ElMagoCT/brophy-tshirt-cannon/docs/concepts/renders/09-ramp.jpg

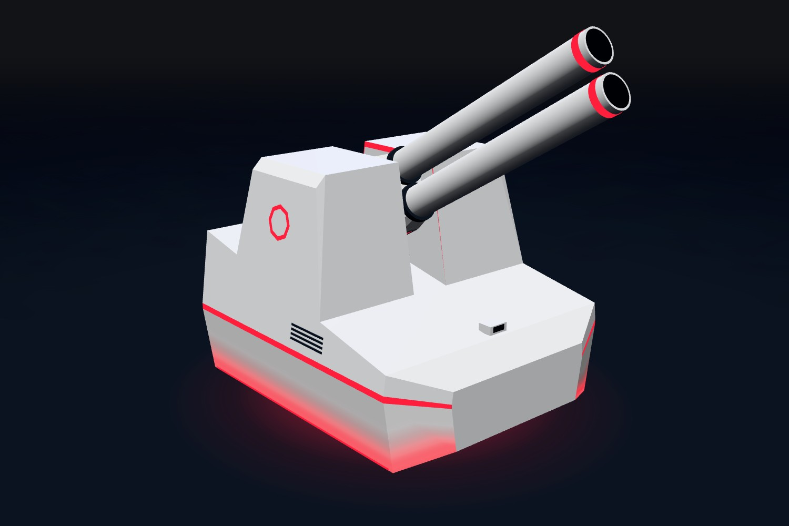
docs/concepts/renders/09-ramp.jpg
