ElMagoCT/brophy-tshirt-cannon/docs/concepts/renders/02-monolith.jpg

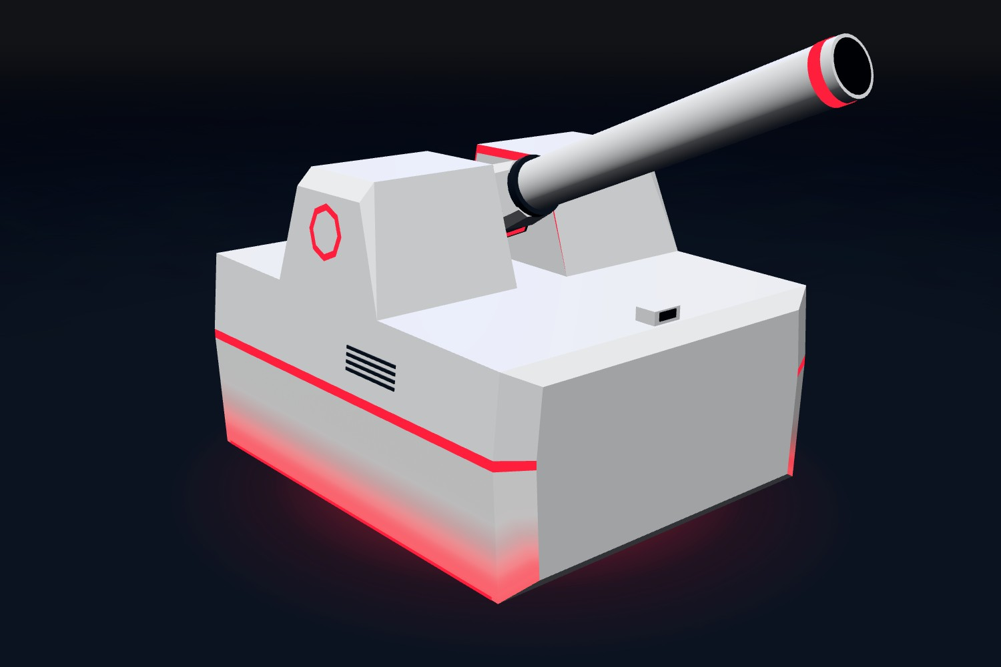
docs/concepts/renders/02-monolith.jpg
