ElMagoCT/brophy-tshirt-cannon/dashboard/README.md

# dashboard/

Web UI served by the ESP32 from flash. Plain HTML/CSS/JS, no build step, talks to
the robot over a WebSocket. Remappable keyboard / HID / gamepad bindings, per-tank
pressure, battery, fire buttons, arm switch, robot rendering, video feed.

Not started.
