ElMagoCT/brophy-tshirt-cannon/docs/glacis/waterjet/README.md

# Waterjet parts (frame plates, 40x40 T-slot frame)

Every flat plate on the 40x40 T-slot frame (branch extrusion-4040), in millimetres, from `cad/glacis/brackets.py` (the CAD's own numbers, regenerated by every `robot.py` run). Nothing is bent. Each DXF is one part (layer CUT: outline, pockets and holes); `nest_*` are the parts laid out on 12 x 12 in sheets (layer SHEET is the sheet edge).

- Holes of 5.5 mm are for M5 screws into drop-in / roll-in T-nuts in the extrusion's 6 mm slots: no holes in the extrusion for them, so the plates go on anywhere along a slot. The shop list for the extrusion itself (lengths, end taps, 10 mm access holes) is `docs/glacis/cut_list_4040.csv`.
- Parts marked CSK take M5 countersunk screws: countersink those holes 90 deg to 10.4 mm on the outer face after cutting (the bearing plates sit right beside the wheels; the bottom corner plates and the bellypan face the underglow and the floor). The rest take M5 x 10 button heads.
- The bearing plates (3 per wheel: the inner one on the side plate, two stacked on the outer rail) take the flanged 1/2 hex bearing as a press fit (28.68 mm): ream to fit the bearing in hand.
- 1/8 in = 3.175 mm, 6061 or 5052.

| Part | Qty | Thickness | Size (mm) | M5 screws each | File |
|---|---|---|---|---|---|
| Bearing plate | 12 | 1/8 in | 112 x 38 | 4 CSK | `bearing_plate.dxf` |
| Bellypan (CNC router) | 1 | 1/8 in | 768 x 259 | 27 CSK | `bellypan.dxf` |
| Corner plate bottom | 4 | 1/8 in | 70 x 224 | 8 CSK | `corner_plate_bottom.dxf` |
| Corner plate top | 4 | 1/8 in | 70 x 224 | 6 | `corner_plate_top.dxf` |
| Rail spacer strip | 2 | 1/8 in | 171 x 20 | 0 | `rail_spacer_strip.dxf` |
| Side plate front | 2 | 1/8 in | 254 x 140 | 6 | `side_plate_front.dxf` |
| Side plate rear (CNC router) | 2 | 1/8 in | 380 x 140 | 12 | `side_plate_rear.dxf` |
| Tower plate | 2 | 1/8 in | 293 x 128 | 2 | `tower_plate.dxf` |

## Nest

- 1/8 in: 5 sheet(s) of 12 x 12 in, 46% of the metal used (`nest_1-8_sheet1.dxf`, `nest_1-8_sheet2.dxf`, `nest_1-8_sheet3.dxf`, `nest_1-8_sheet4.dxf`, `nest_1-8_sheet5.dxf`)

Not in this nest (CNC router, bigger than the 12 x 12 bed): the bellypan, one piece with every electronics part's footprint engraved on layer MARK (0.3 mm deep: drill each part's holes to the part), and the two gun cradle plates (`docs/glacis/gun_plates/`). Also not here: the fog heater bracket.
