ElMagoCT/brophy-tshirt-cannon/docs/glacis/acrylic_cuts/README.md

# Acrylic cut plan (Brophy Borealis, 2026-11-10)

Two Lesnlok 24 x 48 in sheets, 1/8 in (B0H68ZJZW8). The laser bed is 18 x 36 in, so saw each sheet across into the
strips below (the red dashed lines in `acrylic_cut_plan.svg`, measured from one 24 in end), then lay each strip on the
bed with its 24 in side along the bed's 36 in and cut its DXF (millimetres, origin at the strip's corner, panels
centred on the strip: a strip is 609.6 mm wide).

- Sheet 1 strip 1: 24 x 16.42 in -> rear (22.75 x 15.98)
- Sheet 1 strip 2: 24 x 15.00 in -> front (U round the light bar hole) (22.79 x 14.55)
- Sheet 1 strip 3: 24 x 16.33 in -> front side L (18.33 x 15.89)
- Sheet 2 strip 1: 24 x 16.89 in -> front side R (18.33 x 15.89)
- Sheet 2 strip 2: 24 x 15.43 in -> battery door (15.89 x 10.72), deck strip (18.59 x 3.46)
- Sheet 2 strip 3: 24 x 15.43 in -> battery door (15.89 x 10.72), deck strip (18.59 x 3.46)

The outlines are the acrylic as modelled: 1 mm under the frame's rebate all round, every hole included.
Cut them after a dry assembly of the printed frame, as the parts list says.
