ElMagoCT/brophy-tshirt-cannon/docs/glacis/JUDGMENTS.md

# Glacis rev D.1: judgment calls

Rev C (2026-11-02), C.1 and C.2 (2026-11-03) are the redesign from your third to fifth rounds of notes:
- both chambers on the back of their cannons, in line, with the barrels as close together as they go
  (8 mm apart, rev C.2);
- the gun balanced on a pivot axis that runs between the two cannons;
- the old cannon's firing valve, plus a U.S. Solid one (your savings pick);
- small, cheap 2 in pipe chambers (0.53 L), sized by a shot simulation;
- the back tank moved to the right, and no room left for a pump;
- a 60 deg front, with the sides and back leaning more, and the open middle kept;
- the rear-panel controls at the bottom of the panel, and the electronics in the back bottom;
- a 60 rpm pivot motor;
- a custom 12 V fogger: smoke into both barrels ahead of the shirt, plus trail vents front and back;
- no check valves or fill block: a main valve, then one in valve per chamber, each metering its own chamber;
- an LED loop on a leaning rail 1.15 in behind each panel, aimed across it, and a 100/m strip pushed
  through a tunnel in every frame member, so the frame glows; corner clips chamfered and twice the size;
- two slim 100 W siren speakers high in the front-side corners (horn replacement), with their amp;
- the vector-style wheels from your TTB file.

Each item says what I picked and why. Numbers come from `cad/glacis/params.py` and the last clean run
(`cad/glacis/out/check_log.txt`).

**Checks on the final model:**
- no part overlaps another;
- nothing hits anything as the gun sweeps 0-90 deg, checked every 5 deg;
- every printed part fits a 256 mm bed;
- every part is a single solid.

**Where it is:** Onshape "Brophy Mark 5 - Glacis", saved as version "Glacis rev C.2"; the assembly is
"Glacis rev C (whole robot)". The parts list is the "Glacis BOM" tab: **$1,512.44** to buy (rev C.1 was
$1,707.39, rev B $1,555.11). Aluminum, acrylic, prints, Falcons, FRC stash parts and the old cannon's valve are all at $0.
The pneumatic and electrical diagrams are in the "Glacis air & wiring" artifact
(source `docs/glacis/air_wiring_artifact.html`).

## What I identified on the old cannon
1. **Firing valve: Atlantic Valves SZW-25.** The plate says SZW-25, not S2W.
   - It's a 1 in NPT stainless solenoid valve, normally closed, with a Viton seal.
   - It's semi-direct acting, with a 25 mm orifice and Cv 12. The 12 V DC coil is 16 W.
   - Rated **0-115 psi on the 12 V DC coil** (0-145 on the AC coils).
   - It's sold at electricsolenoidvalves.com, not Amazon: SZW-25-12VDC, **$127.56**, 29 in stock
     ([page](https://www.electricsolenoidvalves.com/1-inch-12-volt-dc-stainless-steel-electric-solenoid-valve/),
     [spec sheet](https://www.electricsolenoidvalves.com/content/Atlantic_Valves_SZW_Spec_Sheet.pdf)).
   - The old one is reused on the top cannon.
   - **The bottom cannon gets a U.S. Solid USS2-01023**, $59.80
     ([B0CXWR76GT](https://www.amazon.com/dp/B0CXWR76GT)): the same 1 in NPT 12 V DC size, rated 0.8 MPa
     (116 psi), which you read off the listing. That's just above the 110 psi cap, and $68 less.
   - **Check the old valve's coil label.** It has to be the 12 V DC one.
2. **Old chamber: a grey primed-steel ASME air tank with a 1 in NPT end port**, probably 1 gal. It's no
   longer used; see item 6 for the new chambers.
   - Its buyable twin was McMaster 9888K9 at $397.34
     ([link](https://www.mcmaster.com/9888K9/)), which is what pushed me to look for something better.
3. **Longacre 5 gal polished aluminum tank:** rated 125 psi
   ([52-50305](https://toolsid.com/longacre/5-gal-horizontal-silver-lightweight-air-tank-mpn-52-50305.html)).
   It can't go on the 200 psi tank side, so it's a spare.
4. **The screw-set regulator is gone.** Each chamber's in valve meters air into it against that
   chamber's transducer, so each cannon's pressure is set in software.
5. **Red "5 in ONE Universal" couplers:** brand and rating not confirmed, so they stay off the pressure
   side.

## Gun
6. **Chamber size, from a shot simulation.** I modelled a shot: the chamber, the valve opening over its
   real time (Cv 12), the air behind the shirt and the shirt itself (250 g with friction). Then I ran it
   against chamber size at 110 psi
   (`cad/glacis/shot_model.py`; numbers below are for a 50 ms valve opening):

   | Chamber | Exit speed | Shots per charge |
   |---|---|---|
   | **0.53 L (2 in x 8 in, picked)** | **22.7 m/s** | **about 20** |
   | 0.64 L (2 in x 10 in) | 24.0 m/s | about 17 |
   | 0.75 L (2 in x 12 in) | 24.9 m/s | about 15 |
   | 1.25 L | 27.0 m/s | about 9 |
   | 3.8 L (1 gal) | 29.0 m/s | about 4 |

   - With this slow a valve, the valve sets the shot, not the chamber. The 1 gal tank gives 28% more speed
     than 0.53 L, and you get a fifth of the shots.
   - The 10 in and 12 in nipples were modelled too. They swing the chambers low enough at the back to
     open the rear face down through the fill port, tank relief and charge port. The 8 in keeps the
     rear controls where you asked for them.
   - If the valve opened in 10 ms like a QEV, the same chamber would give about 38 m/s. That's the case
     for adding a QE5 later (item 9).
7. **Chamber: 2 in Sch 40 x 8 in steel nipple between two 2 x 1 malleable reducing couplings, about
   0.53 L.**
   - About $41 per chamber in pipe ($15 nipple and two $13 couplings), against $397 for the McMaster
     twin of the old tank.
   - The couplings are UL/FM listed, 150 lb class and factory pressure tested; the pipe is rated well over
     1,000 psi. Everything sits behind the 125 psi relief.
   - At 3 in across the couplings, the chambers are no wider than the barrels, which is what lets the
     barrels sit close.
8. **Two cannons stacked 8 mm apart** (84.2 mm between axes; rev C.1 had 3.8, you asked for 8).
   - Each one, back to front:
     1. port block;
     2. 1 x 1/4 bushing;
     3. reducing coupling;
     4. 2 in nipple;
     5. reducing coupling;
     6. 1 in close nipple;
     7. SZW-25;
     8. 1 in close nipple;
     9. CNC breech adapter;
     10. polycarbonate barrel.
   - The breech adapter is stash 6061 with a 1 in NPT tap ($16.99 on the list). The barrel slips over its
     spigot, so it's no wider than the barrel.
   - One printed breech block in two halves clamps both barrels onto their spigots. The muzzle collar is
     two halves meeting between the barrels.
   - **Balanced on the pivot.** The model finds the gun's centre of mass and slides both cannons along the
     barrel axis until it lands on the pivot axis. Valves end up 71 mm ahead of the axis, centre of mass
     within 0.3 mm, gun 11.4 kg: **0 N*m to hold at any angle.**
   - The valve (1.0 kg) and coupling (0.31 kg) masses are estimates; the pipe is computed. Weigh yours,
     update `gun.py`, and re-run before cutting the cradle plates.
9. **Pressures and the valve trade-off.**
   - 110 psi software cap on the chambers, just under the valve's 115 psi DC rating. Above that, the coil
     may not lift the valve; it fails closed, not open.
   - **Milton 1090-125** ASME reliefs ($16.87) go on each chamber. Their pull ring is the manual bleed.
     125 psi is above the cap, so they never simmer, and under the tanks' and transducers' 200. This replaces the settled "150 psi chambers" for this valve.
   - CLAUDE.md lists "big direct-acting solenoid as the firing valve: too slow vs a piloted QEV" as a dead
     end. The SZW-25 is semi-direct, so it's slower. It's in because you asked for the old valves and it
     worked on the old cannon.
   - The simulation says a QE5 QEV ($51.75) between the chamber and the barrel, with the SZW-25 as its
     pilot, would be the biggest single gain if you want more range later.
10. **Air budget:** each 0.53 L refill takes about 5 psi out of the two 6 L tanks, so a 200 psi charge
    gives **about 20 full-power shots** (2 loaded plus about 18 refills). Lower settings give more.
11. **Chamber fittings: a 1/4 NPT brass cross on the back of each chamber**, so nothing is drilled. Its
    four ports are exactly what's needed, so the 5-port block and its plug are gone (-$23, lighter gun):
    - in from the chamber's bushing;
    - fill push-to-connect straight out the back;
    - 125 psi relief pointing outward;
    - 0-200 psi transducer to the side.
12. **No check valves: a main valve, then one in valve per chamber** (your call, rev C.2).
    - The checks were only there because one fill valve fed both chambers through a shared block, so
      firing one would have drained the other back through it. With a valve per chamber, a closed in
      valve seals its chamber, so the checks and the fill block (with its sensor and relief) are gone.
    - **Main valve** (kept, as you asked): the tanks' shut-off. It opens only while a chamber fills, and
      it's on the safety-powered valve rail, so a trip closes it. *Rev C.3: now a manual ball valve (E2).*
    - **In valves A and B:** each pulses until its chamber's sensor reads that cannon's own setpoint
      (110 psi max). All three are the same Aignep 02F direct-acting 12 V valve ($41.36, 507 psi rated).
      Direct-acting means they open from 0 psi and don't need a pressure difference to work.
    - **Fill order:** open the main valve, meter the in valve, close the in valve, then the main valve.
      That leaves tank pressure on the in valves' inlet side, which pushes their seats shut. A solenoid
      valve isn't rated to hold pressure backwards, so the firmware never vents that line.
    - **No bleed valve.** The manual tank bleed is gone. To dump by hand, pull the relief rings:
      - the tank relief, which now points out through the rear panel where the bleed lever was;
      - the 200 psi relief on the valve cross;
      - the 125 psi relief on each chamber.
      With power, the firmware can empty the chambers by firing them.
    - **One relief I kept that you circled:** the brass between the main valve and the in valves holds
      tank pressure when both are shut, so it's its own pressure zone. The project rule is a hardware
      relief on every zone, so the cross carries a 200 psi relief ($16.30) instead of the fill block's
      125.
    - Air side: -$15.60 (checks, fill block, fill sensor, 125 relief and ball valve out; two in valves
      and a 200 relief in). Two more MOSFET channels, from the spares.
    - Two nylon service loops run from the in valves up to the gun and flex as it elevates. The sweep
      check skips them; give them slack when you route them.
13. **Firing valves switch on MOSFET modules, not relays,** to take the relay's ms off the shot. Add a
    flyback diode on each coil.
14. **Cradle:**
    - two 1/8 aluminum plates either side of the stack;
    - printed chamber saddles (one block between both pipes at each station), each pipe's outer half
      held by a printed cap with two M5 screws into the saddle (they replace the cam straps);
    - valve side blocks and the two-piece breech block;
    - a printed mantlet carrying the smoke vents beside the barrels and an LED groove;
    - a two-piece LED-groove muzzle collar.

## Elevation
15. **The 60 rpm motor is the goBILDA 5203 99.5:1.** It drives a 16T -> 56T HTD 9 mm belt (100T) to
    the right pivot stub.
    - That's about 17 rpm at the gun, so 0-90 deg takes about 0.9 s at full speed.
    - The gun is balanced, so the motor only fights friction and inertia. It has 46 N*m stall at the
      pivot.
16. **Two 1/2 hex steel stubs carry the pivot**, one per cradle plate, each through a printed hub
    bolted to the plate's outside face. The pivot axis still runs between the two cannons.
    - With the barrels 8 mm apart, there's no room for a shaft between the chambers' couplings.
    - The stubs sit in four flanged hex bearings, in two PA-CF blocks on 1x1 towers on the inner rails.
    - The pulley is on the right stub; the arm-angle pot is on the left stub through a printed coupler.
    - The two plates are tied together by the saddles, valve blocks, breech block and mantlet.
17. **The gun well follows the gun.** The model sweeps the gun 0-90 deg and cuts the well floor to that
    envelope plus 10 mm, so the body stays as closed as it can.
    - The floor is 437 mm high at the front, 388 at the back and 232 under the axle.
    - The well is 224 mm wide; the elevation pulley turns inside it.

## Body
18. **Front slant 60 deg** (was 70), the back leans 80 deg, and the sides lean in 8 deg (was 6). The deck
    is flat at 24.8 in.
19. **Size:**
    - 37.7 x 27.7 in over the bumpers.
    - With the gun level, the muzzles reach 44.9 in overall and the chambers stand 31.2 in tall.
    - At 90 deg it is 37.8 L x 50.1 H.
    - To get through a 40 in door, drive with the gun raised.
20. **9 panels.** Both side walls split at the battery bay; their rear panels are the battery doors.
21. **Each panel has its own LED loop, 1.15 in behind it, aimed across it** (rev C.2, your second note).
    - A printed rail hangs inside every window from a flange on the frame's inner face, leaning 15 deg
      toward the panel. A 10 mm 60/m strip sticks to its panel side, centred 35 mm behind the outer face
      (1.15 in behind the acrylic). The LEDs shine across the back of the panel and slightly at it.
    - The rail runs all the way round each window, so every panel is one closed loop and can be its own
      colour. The rail's back shades the next panel, so the light doesn't leak across.
    - **How far in:**
      - **42 mm from an edge shared with another panel.** Every corner on this body is 91-100 deg, and at
        any less the two panels' strips cross along the whole edge.
      - **29 mm from an open edge** (the bottom, the gun slot, the speaker notches), so the bottom runs
        sit low.
      - The rail corners round off at up to 45 mm.
    - **The bottom runs fit.** I moved parts out of the loops' way:
      - the batteries 15 mm inboard, and their SB50 plugs with them;
      - the side tanks 6 mm inboard and 20 mm back;
      - the elevation motor 22 mm lower, round its belt circle (same belt);
      - the pot bracket's top 20 mm lower;
      - the rear smoke tube up 15 mm, and the smoke box 10 mm back;
      - the rear manifold 5 mm lower, with its tank transducer pointing down from its underside.
      The rear panel's bottom run passes under the E-stop, charge port and smoke nozzle.
    - 12.1 m of strip, so three 5 m rolls (BTF-LIGHTING, Amazon, $13.99).
22. **The frame glows too: a strip tunnel through every member.**
    - A 6 x 2.6 mm rectangular tunnel runs down the middle of each member, so a 5 mm strip can't twist
      and its LEDs face out. That's 100 LED/m (5 mm, 2020 LEDs, AliExpress, $15.79 per 5 m). Print the
      frame in natural or white PETG.
    - It's centred across the member and stacked over the joint line: the tenons moved deeper (18.5 mm,
      was 15), and the tunnel sits 2.5 mm outward of them, so the M4 cross screws stop 2.75 mm short of it.
    - On the bottom edges, where the face meets the open bottom at a sharp angle (60 deg at the nose),
      the tenon and tunnel move in from the edge until they keep 2 mm of wall.
    - **Feed slots:** at each end of each member, a slot opens from the inside down to the tunnel. Push
      the strip in from one slot to the next; at the nodes, solder or plug the next member's strip in the
      slot. The slots stay 9.5 mm under every outer face and out of every joint.
    - 9.5 m in the tunnels. With the loops that's about 1,680 LEDs, so cap them at about 20% white on
      the 20 A buck.
    - Print the frame in natural PETG at 15% gyroid with 4 walls (your savings pick): lighter, and the
      glow comes out more even than at 25%.
    - **Frame:** 89 printed pieces, 101 tapered tenons with M4 cross screws, 40 corner clips and 2
      door latches. Short edges round the speaker notches set back less so they still get a
      segment, and the few nodes that still came out bigger than the bed are halved and glued.
    - Strips, rails and loops are in the model (red), so they show in Onshape.
23. **Corner clips: chamfered, twice the size.** Each is a corner plate with a straight chamfer across
    the panel corner instead of a round edge, legs 27 mm along the frame (rev C.1's discs reached about
    14). One M3 into a heat-set insert, 8 mm in from both edges.

## Speakers (rev C.2)
24. **Two slim 100 W siren speakers, one high in each front-side corner.** Your old list had a 20-30 W PA
    horn; that's quieter than a car horn at a parade. Siren speakers are built to replace a horn.
    - **UBL 100W Slim:** 11 ohm, 120-130 dB at 100 W, 400-4,000 Hz, 5.5 x 5.75 x 2 in, $79.99. Being 2 in
      deep is what lets them sit in the corners; the 5-6 in PA horns are 6-8 in deep.
    - Horn tones and voice sound right; music has no bass at 400 Hz up.
25. **Aim, as you asked for the top ones:** 45 deg out from straight and 30 deg up. Each sits 90 mm down the
    front-side corner from the top and seats 55 mm in from the corner edge.
    - **I didn't fit the bottom pair** (22.5 out, 15 up). The lower corner has the front wheel under it
      and the side tank behind it, and a 6 in speaker per notch leaves too little panel between two
      notches. Everywhere I tried, one of these broke:
      - the side panels pinched into two pieces;
      - the cups hit the front wheels;
      - the grilles pushed the robot to 28.8 in wide, past your 28 in door.
    - Two at about 26 W each is roughly car-horn loud at 1 m. If you want the bottom pair, a speaker
      about 4 in across would fit. Your call.
26. **Integration:** each speaker sits in a square notch cut into the corner. The body shape itself is
    notched, so the front and side panels, the frame, the LED rails and the loops all follow the notch.
    - A printed cup lines the notch and carries the speaker on 4 x M4 through its floor; a wire hole goes
      through the floor.
    - A printed grille covers the speaker face: 3 walls, no top or bottom layers, 12% gyroid, so it prints
      as an open mesh. Glue it or screw it to the cup.
    - The grille's top corner stands 4 mm above the deck.
27. **Driver:** the ESP32-S3 WiFi bridge streams sound from the web UI over I2S to a PCM5102A DAC. One
    TPA3116D2 board ($13.98) drives both speakers, one channel each.
    - It runs from a 12 -> 24 V 10 A boost converter ($39.99) on a PDH channel. On 24 V it puts about
      26 W into 11 ohm; on 12 V it's about 6 W, 6 dB quieter. Skip the boost if that's loud enough.
    - The amp and the boost sit on the middle of the bellypan, under the gun's swing.
    - Audio adds $199: two speakers $160, amp $14, boost $18, DAC $7.

## Layout
28. **The back tank moved to the right.** I read that as mirroring the left one, so both tanks lie along
    the sides over the front wheels, on cantilevered 1x1 arms with printed saddles and straps. No pump
    spot.
29. **Bottom of the rear panel:**
    - E-stop;
    - fill port (air in; rev C.3: an M-style plug with a check valve behind it, P3);
    - the tank relief's pull ring (the hand dump; there's no bleed valve);
    - SB50 charge port, to run or charge on standby power with the batteries in;
    - USB-C to the STM32.
30. **Rear manifold** (back bottom, left): tank lines, 0-300 psi transducer (pointing down underneath),
    and the line to the main valve. The fill port and the 200 psi relief go straight out through the rear panel.
31. **Electronics in the back bottom bay:**
    - PDH and main breaker on the bellypan;
    - STM32, both ESP32-S3s, the PWM gate, the drivers, the buck and the Spark MAX on a printed shelf;
    - the main valve, valve cross and in valves beside them (coils up).
    - Rev C.3 adds the PDH contactor and the logic supply here (E1); the main valve's handle has to reach
      the rear panel (E2).
32. **Batteries:** two spots, one per side, each on its own sled over a rear wheel, so you can swap one
    while the other runs. Each slides out through its side's rear panel.
    - **The battery doors latch at the top** (your call). Each door keeps its two bottom corner clips,
      which act as hooks, and gets a printed quarter-turn latch on an M4 screw at the middle of its top
      edge. Turn the latch, tip the door out from the top, and lift it off the hooks.

## Smoke
33. **Custom 12 V fogger with one 200 W fog heater core, and room for a second** (your savings pick), instead
    of the EVAP smoker. The tray, the heater bracket, two MOSFET channels and a PDH channel are left free,
    so the second core and its pump drop in later for twice the fog. About $55 of parts plus fluid.
    - **Why not the EVAP smoker:** it burns about 0.3 mL of oil a minute; a 400 W fogger moves 13-16 mL.
      That class can't make outdoor trails or fill two barrels.
    - **Why not a mains fogger:** a $30 400 W fogger plus a 500 W inverter draws about 40 A, puts mains
      wiring on the robot, and the inverter doesn't fit the bay
      ([BORGOVA](https://www.amazon.com/dp/B0F4XJMNFR) + [BESTEK](https://www.amazon.com/dp/B086SSRRZ7)).
    - **The core:** a cast fog-machine heat exchanger made for 12 V
      ([AliExpress, $22.42](https://www.aliexpress.us/item/3256805556610953.html)), 97 x 32 x 36 mm,
      about 17.5 A on its own 30 A PDH channel. One makes about as much fog as a 200 W mains fogger; two
      would match a 400 W one.
    - **Parts:**
      - a Kamoer 12 V peristaltic pump per core, fed from a printed 400 mL tank;
      - a MAX6675 thermocouple amp and K probe per core, read by the STM32;
      - a KSD301 250 C cutout and a 40 A relay per core;
      - a 5015 blower to push the fog into the splitter.
    - **Warm-up is 5-8 minutes** (heat on standby power before an event). Then about 40 s of continuous
      fog before a reheat.
    - The ready-made 12 V 200 W fogger on AliExpress ($58.49) uses the same class of heater, but it has one
      1-star review and no size listed.
34. **Control and safety.**
    - The STM32 holds each core at 220-240 C, with a firmware cut at 245 C. It switches the heaters
      slowly (about 1 Hz) on paired MOSFET channels, gated at 5 V through the spare 74AHCT125 buffers.
    - The pump and the blower are on their own MOSFET channels. With the firing and in valves that's
      8 channels of two 6-packs, which leaves 2 for a second core.
    - Each core's 40 A relay sits upstream of its MOSFETs. Its coil runs through the KSD301 and an STM32
      enable pin that's pulled low, so an overheated core, a shorted MOSFET or an STM32 reset all drop it.
      The KSD301 resets itself when it cools, so the firmware latches the fault.
    - Pump only within 10 C of the setpoint, with a pump timeout, and cut the heater if a thermocouple
      reads open.
    - The cores sit on an aluminum bracket with ceramic-fiber wrap, never on a print.
35. **Fluid:** water-based glycol fog fluid only. Oil (the EVAP fluid) cokes the core's 2.5 mm tube. Like
    any fogger, it can trip gym smoke detectors, so check with each venue.
36. **Ducts:** a printed outlet adapter feeds a printed 1-to-4 splitter, then your four flexible tubes.
    - **Two go to the barrels.** Each barrel has six 5 mm holes 205 mm from its breech end, just past a
      rolled shirt. A printed two-piece smoke collar clamps round both barrels over the holes. Its two
      ring grooves meet between the barrels, so one plenum feeds both.
      - Smoke fills each barrel ahead of the shirt and spills out of the muzzle. On a shot, the shirt
        pushes it out in front.
      - The holes sit ahead of the shirt, so they don't leak the shot until the shirt has passed.
      - Drill the polycarbonate slowly with a sharp bit and deburr; the clamps still never drill it.
      - These two tubes flex with elevation, like the air loops.
    - **One goes to a vent under the front bumper** (through the bellypan, front left).
    - **One goes to a nozzle low in the rear panel**, centred under the open middle. It runs along the
      bellypan, under the gun's swing and over the electronics shelf. That's the back trail.
    - Keep the ducts short and sloped so condensed fluid drains back. Check the core's tab layout and outlet
      tube when they arrive, before printing the tray and splitter.

## Wheels (from your vector-wheel file, TTB-0010)
37. **Same style as your TTB wheel, scaled to 10 in.**
    - 10 rollers, 42 mm across and 104 mm long (rev B had 14 at 30 mm).
    - A lobed hub rim with a printed cup round each roller end, like the TTB's hooked lugs.
    - One change: the rollers keep a true mecanum barrel profile instead of the TTB's straight
      cylinders. At 10 in, a straight roller rides on its corners and the wheel bumps.
    - Coverage +6%, with 5 mm between neighbouring rollers.
38. **Rollers on 608 2RS and a fixed M8 rod.**
    - PETG-CF core, 3 mm TPU 95A tread (1.8 mm at the ends), a 608 pressed 8 mm into each end.
    - The rod doesn't turn; the bearings do. It threads through a captured M8 nyloc in the outboard
      cup (Loctite 243) and bottoms in a blind hole in the inboard cup. The outboard plate covers the
      nut channels, so a rod can't back out.
    - Each cup's stub sits in the roller's end recess and presses only on the bearing's inner race.
    - Nuts, not tapped aluminum: the rods sit at 45 deg to the plates, so a flat plate can't be
      tapped square to them.
    - To change a roller: take off the outboard plate (8 nuts), unscrew the rod by a slot cut in its
      end, and the roller drops out.
39. **Hub: two halves, as big as the bed allows.**
    - Split at the roller centre plane. Each half is 242 mm across and prints face down.
    - The bed would take 250 mm, but the rim stops 6 mm inside the tread so it never touches the floor.
    - Each half is a lobed face web, a drum ring, 6 spokes and a 1/2 hex boss.
40. **Aluminum: 12 flat 1/8 in plates (waterjet), three per wheel.**
    - The inboard plate is the belt's inner flange.
    - A centre disc sits between the two halves.
    - The outboard plate is lobed, the same shape as the rim.
    - 8 x 1/4-20 x 5-1/2 in bolts clamp the stack (M6 x 130 fits the same holes). The plates' hex holes
      put the wheel load on the axle through aluminum, not plastic.
    - Each plate also has 12 lightening holes: the hub's 6, plus 6 x 16 mm between the bolts (your
      savings pick). None at 0 and 180 deg, where they'd meet the hub's holes; >= 7.7 mm of web everywhere.
41. **Pulley: 116T HTD 5M, 15 mm, printed into the inboard half.**
    - Its flange is 1.27 in off the floor. 118T would be 1.20 in.
    - 9.67:1 from the Falcon's 12T (was 10:1); free speed 28.8 ft/s.
    - The stock 140T belt still fits; the Falcons now sit 169 mm from the axle.
42. **Load.** Two 608s per roller rate 2.7 kN static. At 69 kg, a wheel carries about 170 N standing
    and about 500 N on a 3 g bump, often all on one roller: over 5x margin. The printed cups are the
    weakest link, and the plates and bolts carry their load to the axle.
43. **The cost of the width.**
    - Each wheel is 120 mm wide (rev B 94). The outer rails stay put (27.7 in over the bumpers), so
      the inner rails and Falcons moved 26.5 mm inboard: the inner rails are now 104-129 mm off centre.
    - The electronics shelf narrowed to +/-100 mm, with the boards rearranged on it.
    - The valve cross moved 25 mm inboard, clear of the rear-left wheel.
    - The tank lines now run inboard of the rail posts.
    - The pivot bearing blocks follow the rails and are now 20 mm wide (was 47); both flanged hex
      bearings still fit, and the pivot stubs are shorter to match.
44. **Weight: 3.3 kg a wheel** (rev B 2.4), so +3.6 kg for four.
45. **Cost: +$60.85.** The 608s, rod, nylocs, bolts and Loctite replace the 685ZZ and M5 lines. The
    Bolt Depot prices are from search snippets, so check stock when you order.

## Things I'd flag
46. **Cost: $1,512.44**, well inside the $2,000 ceiling.
    - By section: pressure side $425, gun $357, audio $199, drive $157, frame and body $131, controls
      $103, smoke $91, bumpers $30, elevation $19.
    - Your savings picks took off $439 (it was $1,951.55). What I didn't change, and why:
      - **#12, 1/4 NPT transducers:** FUSCH's 200 psi transducer only comes in 1/8 NPT, so the bushings
        stay.
      - **#13, HornBlasters VA-4:** it's $41.95 in stock, the same as the Aignep, and nothing says it's
        direct-acting. So the Aignep stays.
      - **The VA-4 as a firing valve:** it can't do the job. It's a 2.5 mm orifice (Cv about 0.15) against
        the 1 in valve's Cv 12, so a shot would barely leave the barrel.
      - **#10, the pipe tap:** it cuts the 1 in NPT threads inside the two aluminum breech adapters. It
        stays on the list; borrow one if the shop has it.
    - The speakers are now the biggest line (2 x $79.99).
47. **Weight is about 157 lb** (71.0 kg). The two siren speakers add about 4.8 kg (2.4 kg each, a guess from
    similar 100 W units); the gun is 11.5 kg.
48. **Check before ordering:**
    - the old valve's coil voltage (it must be the 12 V DC coil);
    - the U.S. Solid valve's coil voltage (12 V DC);
    - the Aignep coil and plug (you need 3 valves);
    - the AliExpress strip's sale price ($15.79 a roll);
    - the speakers' weight and mounting holes, and that the 4 x M4 pattern in the cups matches;
    - the fog cores' tabs and outlet tube when they arrive;
    - the AliExpress, Zoro and dollar-store prices (search snippets only).
49. **Found while checking: the battery doors are too narrow for the battery.** This goes back to rev C.
    The back leans 80 deg, so at the top of the battery the door window is about 163 mm wide, but the
    battery is 181 mm long; the LED rails take it to about 149. It slides out only if you tilt it. Fixes:
    move the door split forward about 40 mm, which runs the split's LED rail into the side tank, or lay
    the battery on its side. Your call; the new top latch doesn't change it.
50. **The Onshape model is imported STEP** (dumb solids), with the gun posed at 20 deg. To change it,
    edit `cad/glacis`, run `python robot.py`, and replace the changed tabs.

## Electronics and air review (rev C.3, 2026-11-03)
Your electronics review notes, then your pneumatics notes. Full electrical write-up: `electrical/README.md`.
Range math: `cad/glacis/range_model.py`. The parts list goes up $36.46 for all of this.

**Electronics**

E1. **The STM32 switches the whole PDH, and the logic has its own always-on circuit** (your call).
    - Main breaker -> 200 A contactor -> PDH. Ahead of the contactor, a 5 A fuse feeds a Pololu S13V30F5
      5 V buck-boost ($17.95): the logic rail for the STM32, both ESP32-S3s and every sensor.
    - Standby (contactor open) leaves the PDH dead but the STM32, sensors, web UI and remote alive, so you
      see pressures, fog fluid, temperatures and battery with the systems off. Arm from the UI.
    - Contactor: Hamolar RD-200 2-pack ($26.24, one spare), coil about 0.7 A through a spare MOSFET channel.
      The rear E-stop's second contact is in that coil, so the E-stop now kills the whole PDH in hardware;
      the first contact stays in the safety relay coil.
    - Buck-boost, not a buck: a drive sag can't brown out the controllers.
    - The 20 A buck now feeds only the LEDs, from the PDH. 1,680 WS2812s draw about 1 A even when dark,
      so they belong on the switched side.
E2. **Main valve is manual** (your call). A 1/4 NPT brass ball valve, the old cannon's if it's stamped
    200 psi or more (else a $6.55 Dwyer DBV-00). -$41.36 for the Aignep it replaces.
    - Open all session, closed for transport and gun work. Its handle needs to reach the rear panel:
      that's a CAD move I haven't made (the C.3 CAD session has the model open).
    - The in valves now hold tank pressure all session. They're rated 507 psi and normally closed on the
      valve rail, so a trip still isolates both chambers. A stuck in valve is caught by the chamber's
      125 psi relief, which flows 120 SCFM against a 2 mm orifice.
E3. **Smoke sensing.** The core temperature sensor was already there (MAX6675 + K probe). Added:
    - an XKC-Y25 capacitive level switch on the outside of the printed tank ($21.95; no hole in the tank);
    - a fluid gauge for free: the pump is peristaltic, so pump-seconds = mL used;
    - DS18B20 probes ($9.49 for 5) in the fogger box (heater off at 70 C, before the PETG tray softens),
      on the electronics shelf and in the battery bay. That last pair answers the "cooling system" question
      with data.
E4. **The STM32F411 is right for its job, not for Wi-Fi or video.** It has the ADC channels, timers and
    FPU for everything time-critical, and a drag-model trajectory solve takes it tens of ms. But it has no
    radio and 128 KB RAM, which is why the ESP32-S3 bridge does the web UI. Put the trajectory math in the
    browser: it's where the aim arc is drawn, and it costs the robot nothing.
E5. **Camera: a Pi Zero 2 W + Camera Module 3 Wide, about $50, on the logic rail.** H.264 over WebRTC at
    about 720p30 and 0.2 s lag. An ESP32S3 camera ($14-20) is cheaper but VGA MJPEG. Not on the list yet.
    - If 2.4 GHz turns out jammed at games, the better option is an ESP32-C5 bridge (5 GHz access point,
      $8-14) with a dual-band camera Pi. Test with one of your S3s at a game before buying.
E6. **Fixes from the review:**
    - battery and PDH volts on two ADC pins (the dashboard's battery goal had no sensor);
    - pull-downs so a cut transducer wire reads as a fault, not as an empty chamber to keep filling;
    - the gun-angle pot on 3.3 V, not 5 V (5 V would overdrive the ADC);
    - all three transducers are now the same 0-300 psi part;
    - firmware latches: no restart after an E-stop, a welded-contactor check, low-battery standby, an
      in-valve time limit;
    - LED power injection at every frame node.
E7. **Runtime:** about 25 A on average at an event, so two FRC batteries last roughly an hour. Swap one
    every ~30 minutes at long games. LEDs and fog are the big steady draws.

**Air**

P1. **The tanks aren't what's short. The gun is.** I modelled range with drag (250 g rolled shirt; its
    drag is the big unknown, so three cases):

    | Gun (110 psi max on the SZW-25) | Exit speed | Range | 200 ft at | 75 ft at |
    |---|---|---|---|---|
    | **rev C.2: 0.53 L, 22.5 in barrel** | 22.7 m/s | **108-132 ft** | can't | 77 psi |
    | 2.0 L, 36 in barrel | 35.3 m/s | 175-238 ft | 109 psi | 34 psi |
    | 2.0 L, 48 in barrel | 39.4 m/s | 194-271 ft | 89 psi | 40 psi |
    | 3.8 L (old 1 gal tank), 36 in barrel | 37.5 m/s | 185-256 ft | 93 psi | 22 psi |
    | QE5 QEV (opens in 10 ms), 1.0 L, 30 in | 35.2 m/s | 174-237 ft | 110 psi | 52 psi |

    - 200 ft needs about 35 m/s at the nominal drag (31-41 across the range). 75 ft needs only about 17.
    - So 75 ft x 6 already works. 200 ft doesn't with any pressure these valves allow: the SZW-25's DC
      coil stops at 115 psi, and its 50 ms opening is slower than the shirt's trip down a 22.5 in barrel.
      More pressure isn't available without a QEV.
    - What gets 200 ft back is the old cannon's recipe: about 2 L or more of chamber and a 36-48 in barrel.
P2. **Shot count is fine with the tanks you have.** One 200 ft shot then six 75 ft shots needs 4-6 L of
    tank, from shop air at 150 psi. The two 6 L tanks (12 L) cover it twice over. The rev C.2 gun gets
    15-23 shots at 75 ft per charge. Bigger tanks would only add shots, so I didn't change them.
    - Shot order: take the 200 ft shot first in a charge, while the tanks are highest. The dashboard can
      show when the big shot is still available.
    - Most shop compressors stop at 135-175 psi, not 200. Everything above assumes 150.
P3. **Fill port: your universal coupler.** A 1/4 MNPT M-style plug ($4.29) replaces the Schrader valve, so
    your EVOULTES couplers snap on like they do on your tanks. A plug is an open pipe, so a 250 psi brass
    check valve ($7.05) sits right behind it to hold the tanks. No kit to buy: you already have the
    hose-side coupler. +$2.19 net.
P4. **Fewer sizes.** All the air plumbing is 1/4 NPT with one 1/4 in tube and one push-fit. The only other
    sizes are the firing path (1 in), the chamber body (2 in) and the transducers' 1/8 NPT port. I looked
    for 1/4 NPT transducers to drop the bushings: the cheap ones are G1/4 (BSPP, which won't seal in NPT),
    so the bushings stay. The 0-200 and 0-300 psi transducers are now one part. A bigger gun in the old
    cannon's style (a 1 gal tank with its 1 in end port) would also drop the 2 in pipe and reducing couplings.
P5. **Open: which gun for 200 ft.** Bigger chambers and longer barrels change the gun's size, weight and
    balance, so the CAD has to be redone. I haven't changed the model or the list for it; that waits on your pick.

## Rev D gun and air (proposal, 2026-11-03)
Your picks after the range math: the top cannon on the old chamber, the bottom on a smaller one, both
barrels the same length, and the top able to run at full tank pressure. Targets: 200 ft from the top
cannon; 120 ft shots, 6 per cannon (12) per tank charge, 10 each (20) ideally. Numbers: `cad/glacis/range_model.py`.
Not in the CAD yet (D6).

D1. **Top firing valve: U.S. Solid USS-HSV04, $98.19.** 1 in NPT, 12 V DC, normally closed, pilot-operated,
    rated 1-50 bar (725 psi) on air, Cv 11.67 (the SZW-25 is 12), 25 mm, 16 W, PTFE seal, 3.86 lb.
    - What else I found: every 1 in 12 V valve on Amazon and AliExpress tops out at 0.8-1.0 MPa
      (116-145 psi). One U.S. Solid listing claims 230 psi, but its own spec table says 7 bar. ASCO's 1 in
      high-flow valve is rated 350 psi on air (price not checked; ASCO is usually several hundred). The
      1/2 in train-horn valves are rated high enough (HornBlasters 210 psi, Kleinn VX7004 250 psi), but at
      Cv 5.5 they flow under half as much.
    - Its opening time isn't published, so the model brackets it at 50 and 80 ms. Bench-test it with a
      phone in slow-motion before cutting the barrels.
    - It replaces the U.S. Solid USS2-01023 (116 psi, $59.80). The old SZW-25 moves to the bottom cannon.
D2. **Top chamber: the old 1 gal ASME tank (3.8 L)**, its 1 in end port straight onto the HSV04.
    - Read its nameplate. It needs 200 psi or more to run at full tank pressure; otherwise cap it 10% under
      the plate. Also check which small ports it has (fill, transducer, relief) and its diameter and length.
    - Software cap 190 psi, with a 200 psi relief (the same Interstate V200-4 as the tanks). It can't fill
      past the tanks anyway.
D3. **Bottom chamber: 3 in Sch 40 x 10 in nipple between two 3 x 1 reducing couplings, about 1.35 L** (you
    asked for 3 in pipe). It stays on the SZW-25 with the 110 psi cap and the 125 psi relief. 2 L would be
    a 3 in x 16 in pipe; 1.35 L does the 120 ft shot at 69 psi, so the extra length buys nothing.
D4. **Both barrels 36 in** (two 4 ft sticks, +$84.48):

    | 36 in barrels | Top, 200 psi | 200 ft at | 120 ft at |
    |---|---|---|---|
    | HSV04 opens in 50 ms | 46.5 m/s, about 263 ft | 96 psi | 42 psi |
    | HSV04 opens in 80 ms | 39.2 m/s, about 224 ft | 151 psi | 65 psi |
    | Bottom, 1.35 L on the SZW-25 | 33.0 m/s at 110 psi | can't | 69 psi |

    - 48 in barrels (the option you picked) were for a 110 psi valve. With 200 psi on the top they add range
      you don't need and make the gun a foot longer. Go to 42 in if the HSV04 bench-tests slower than ~60 ms.
D5. **Tanks: five of the same 6 L aluminum 200 psi tank (30 L), +$170.** Tank needed for 120 ft shots:

    | Charge | 6 + 6 shots | 10 + 10 shots |
    |---|---|---|
    | 200 psi | 13-18 L | 22-30 L |
    | 175 psi | 16-22 L | 28-38 L |
    | 150 psi | 22-29 L | 37-50 L |

    (Ranges are the 50 ms and 80 ms cases, with 15% lost to the tanks cooling as they empty.)
    - 30 L gives 10 + 10 from a 200 psi charge and 6 + 6 from 150-175. Three tanks (18 L, -$113 from this)
      would give 6 + 6 only from a 200 psi charge.
    - One part number, daisy-chained. More fittings and straps are on the list.
    - **"Full 200" needs a compressor that reaches 200 psi.** Most shop compressors stop at 135-175.
    - The other way to get a whole event from one fill: a 4,500 psi carbon-fibre paintball tank holds more
      air than all five tanks in about 1.5 kg, but it's filled at a paintball or scuba shop, not with shop air.
D6. **CAD (not done).** A 1 gal tank (about 6 in across) and a 3.5 in chamber can't both sit in line behind
    barrels 84 mm apart. Stagger them along the barrel axis or spread the barrels. The gun also gets longer
    and roughly 5 kg heavier, which changes its balance. That's the gun CAD, which the C.3 session has open.
D7. **Cost: +$360.07**, so $1,908.97 on the committed list. That's close to the $2,000 ceiling (about
    $1,964 with the other session's C.3 rows). The biggest adds are tanks +$170, barrels +$84 and the valve +$38.
D8. **Electronics:** the web UI's access point moves to 5 GHz on an ESP32-C5 ($13.99); the camera is deferred.
    The "STM32 with WiFi" question is answered in `electrical/README.md`.

## Rev D.1: both chambers in 3 in pipe, three tanks (proposal, 2026-11-03)
Your notes on rev D: five tanks is too many and too expensive; put a bigger or third tank where you
circled (low in the front half, under the gun); the old tank is too big, so make the top chamber like the
bottom one but longer; barrel spacing, the top elevation (60 deg is fine), the pivot and the drive motors
can all move. Supersedes D2, D5 and D6.

D9. **Both chambers are 3 in Sch 40 pipe between 3 x 1 reducing couplings.** Top: 12 in nipple, about
    1.59 L, on the HSV04 (up to 190 psi). Bottom: 10 in nipple, about 1.35 L, on the SZW-25 (110 psi).
    Both use 36 in barrels:

    | Top chamber on the HSV04 | 200 ft at | 120 ft at | Air per 120 ft shot |
    |---|---|---|---|
    | 10 in (same as the bottom) | 127-184 psi | 70-96 psi | 95-129 L*psi |
    | **12 in (picked)** | **120-176 psi** | **64-89 psi** | **102-142** |
    | 18 in | 107-163 psi | 52-76 psi | 122-177 |
    | old 1 gal tank (rev D) | 96-151 psi | 42-65 psi | 159-246 |

    - Past 12 in, a longer chamber barely adds speed (the valve limits it), and it burns more air on every
      120 ft shot. 12 in keeps the 200 ft shot under the 190 psi cap even if the valve opens slowly.
    - The smaller top chamber uses about 40% less air per shot than the old tank, which is what lets the
      tank count drop.
D10. **Barrel spacing: about 112 mm between axes (barrels about 36 mm apart, was 8).** A 3 in coupling is
    4.28 in (109 mm) across, so two of them side by side set the spacing.
    - Staggering the couplings only gets it to about 102 mm (a coupling still has to clear the other
      chamber's 3.5 in pipe), and it takes a longer nipple on one cannon. Not worth 10 mm.
    - 2.5 in pipe would fit at about 95 mm, but the chambers grow to 17-21 in long.
D11. **Tanks: the two side tanks plus a third 6 L of the same part (18 L), in the space you circled.**
    120 ft shots per charge, both cannons alternating:

    | Tanks | Total | Fast valve (150/175/200 psi) | Slow valve | Cost of the third |
    |---|---|---|---|---|
    | two side tanks only | 12 L | 9 / 11 / 15 | 6 / 8 / 10 | - |
    | **+ third 6 L (picked)** | **18 L** | **13 / 17 / 21** | **8 / 12 / 16** | **$56.60** |
    | + Viair 2.5 gal steel, 6 x 23.5 in | 21.5 L | 15 / 21 / 25 | 10 / 14 / 18 | $109.25 |
    | + 3 gal aluminum, 7 x 18.9 in (Ridetech) | 23.4 L | 17 / 23 / 27 | 10 / 16 / 20 | about $145 |

    - The third 6 L gets your 12-shot target from a 175 psi charge, and 16-21 shots from 200 psi.
    - The bigger ones add 2-6 shots for $53-88 more. The Viair is likely too long for that spot, and Ridetech
      doesn't publish the 3 gal tank's pressure rating (ask before buying). AccuAir's 2 gal seamless tank is
      $174.95.
    - The spot you circled is where the side tanks and, above 60 deg, the chambers' swing already are. So the
      CAD has to make room: cap elevation at 60 deg, move the pivot or the Falcons, or move the side tanks.
      That's a CAD call (the C.3 session); if a 3 gal fits there, it's the upgrade.
D12. **Money, each round** (parts list on committed rows):

    | Round | Change | Total |
    |---|---|---|
    | rev C.2 | | $1,512.44 |
    | C.3 electronics + air review | +$36.46 | $1,548.90 |
    | rev D (old tank on a 725 psi valve, 5 tanks, 36 in barrels, 5 GHz bridge) | +$360.07 | $1,908.97 |
    | rev D.1 (3 in top chamber, 3 tanks) | -$17.83 | $1,891.14 |
    | rev D.1 as modelled (two tanks, underglow, hood lights) | -$2.77 | $1,888.37 |
    | D.1.1 your cuts: no rivets, old 9 in mecanum (printed-wheel hardware off), goBILDA owned, light bar | -$225.30 | $1,663.07 |
    | **D.1.1 cost-down: cheapest of AliExpress (logged in), Amazon, McMaster** | **-$303.16** | **$1,359.91** |

    - Rev D.1 in detail: two fewer tanks -$113.20 and one fewer pack of straps -$8.99; the top chamber
      (12 in nipple $31.59, two couplings $63.78, a bushing $8.99) +$104.36. The old tank goes back to spare.
    - The other session's C.3 rows (elevation, smoke, body) add about $55 on top.
    - The biggest lines now: speakers $160, barrels $169, the three tanks $170, the HSV04 $98.
D13. **Search: one tank, 200 psi, bigger than the three 6 L tanks (18 L) and under their $169.80.**
    None found that also fits. 200 psi tanks over about 12 L are long and thin (24-30 in). The robot's
    longest straight run in the spot you circled is about 18-20 in across, and only if the Falcons and
    fogger move. Shorter, fatter 5 gal tanks exist, but they're 125-150 psi.

    | 200 psi tank | Volume | Size | Price | Verdict |
    |---|---|---|---|---|
    | **6 L aluminum (current)** | 6 L | 6 x 14.2 in | $56.60 | Fits anywhere; $9.43/L, the cheapest per litre |
    | Viair 91028 steel | 9.5 L | 6 x 23.5 in | $109.25 | Too long to go across |
    | Ridetech 3 gal aluminum | 11.4 L | 7 x 18.9 in | $141-145 | Might fit across; pressure rating not published |
    | Generic 3 gal aluminum (eBay) | 11.4 L | 6.7 x 20.5 in | $48-58 | Listed 200 psi but out of stock; generic like the 6 L |
    | Seamless / Speedway 2 gal | 7.6 L | 6.6 x 18 in | $175-201 | Over budget |
    | Air Lift 4 gal aluminum | 15 L | 6 x 30 in | not checked | Too long |
    | Vixen 5 gal steel | 19 L | 7 x 30 in | not checked | Too long |
    | "Bomb" 5 gal | 19 L | 20 in long, 12.5 in high | about $230 (EUR 199) | Over budget, 1/2 in ports |

    - **So the three 6 L tanks stay (18 L, $169.80).** The only upgrade worth it is a 3 gal as the third tank
      (23.4 L total), if one is confirmed 200 psi and the CAD shows it fits across. That's +$0 to +$88.
    - Skipped: 150 psi tanks (Viair 91050, Firestone, Kleinn, HornBlasters) and anything with G (BSP) ports.
D14. **CAD test-fit (the C.3 session): no room for a third tank, so it's two 6 L tanks (12 L).**
    - The side tanks already fill your circled band in side view (x -134..226 mm, z 280-440). Between them
      only about 295 mm is free lengthwise, and a 6 L needs 360. The gun's rear swing is behind that and
      the front face is ahead of it.
    - Across the robot (x ~80, z ~335, ends in the middle of each front side window) a 3 gal fits: the
      generic 170 x 520 mm and the Ridetech 178 x 479. But it takes the side tanks' place, so 11.4 L would
      replace 12 L. The Viair 2.5 gal (597 mm) doesn't fit.
    - The CAD now has the pivot at z 645 and **45 deg max elevation** (you'd allowed 60), slot +/-133 mm.
    - 120 ft shots per charge with 12 L: **9 / 11 / 15** from a 150 / 175 / 200 psi fill if the HSV04 opens
      fast, **6 / 8 / 10** if slow. Your 12-shot target needs a 200 psi fill and a fast valve. More would take
      a bigger relayout: the side tanks need somewhere new, and the battery bay is behind them.
    - **Money: -$65.59** (one fewer tank -$56.60, one fewer pack of straps -$8.99), so **$1,825.55** on the
      committed rows. The other session's C.3 parts rows (elevation, smoke) are still uncommitted.

## Model: rev C.3 body and rev D.1 gun (CAD, 2026-11-03)
Your body notes, then the D.1 gun above, as built and checked in `cad/glacis/` (Onshape version "Glacis rev D.1").
These replace items 14-17 and 20-26 where they disagree.

M1. **Frame and acrylic.** The acrylic now laps 7 mm onto the print (was 14): members are 19 mm wide, the outer lip
    stays 12. Windows, acrylic and clips all have rounded corners (22.5 mm windows, 28 mm acrylic). Each clip is a
    round head lapping 6 mm over the acrylic's corner plus a tail to its screw, which goes into an M4 heat-set
    insert where the acrylic's corner is cut away. M4 x 12 is now the only screw on the body; the M3 pack is off
    the list.
M2. **Front.** The front panel stops at the gun-well floor, so it's one plain rectangle (no arms up the sides).
    Above it, each side is one printed cheek round the speaker pocket (it replaces the cluster of small pieces you
    named). The speakers sit 13 mm deeper.
M3. **LED loops.** Corners are 22.5 mm (half) and stand square to the panel, so the strip bends the easy way; the
    15 deg lean only happens on the straight runs and twists in over 40 mm. How far in each run sits:
    - **42 mm on edges shared with another panel.** I tried 8. A neighbour's rail hangs square to its own panel, so
      any closer it sits right behind this panel's acrylic (a dark shelf, and it hit the acrylic) and its cross runs
      cut through this loop. The corners still come in: about 66 mm from the panel corner, was 78.
    - **19 mm on edges with no neighbour** (bottom, front cut, the seams in the deck and side walls): just behind the
      window edge, so those dim bands are gone. 24 on the gun-well edges (clear of the pivot blocks), 30 on the
      speaker notches, 46 under the speaker cups.
    - A flange from the member's inner face carries each rail. 10.6 m of 60/m strip in the loops.
M4. **Battery doors.** The side walls now split at x -105 (was -150) and the batteries sit 17 mm further forward,
    so a battery passes between the door's LED rails with a few mm each end.
M5. **Underglow:** a printed 45 deg bracket under each outer and end rail, just inside the bumper, with 60/m strip
    aimed down and out. Light passes under the bumper (3 in off the floor) and pools round the robot. 2.5 m, from
    the rest of the third 60/m roll. A strip inside the bumper would mostly light the noodles.
M6. **Hood lights:** two mini 12 V 3 W spots (30 deg beam, 32 x 19 mm, $3.86 each on AliExpress) in printed pods at
    the low front corners, just above the bumper, aimed straight ahead; dimmed together on the last spare MOSFET.
    The cheeks were the first spot, but the wider gun well left them only about 20 mm wide.
M7. **Gun (rev D.1).** Both chambers 3 in Sch 40 between 3 x 1 couplings: 12 in on the HSV04 (1.63 L) on top, 10 in on
    the SZW-25 (1.38 L) below; barrels 112 mm apart and 36 in long. Valve faces line up; the core is 148 mm wide
    for the couplings plus the fill and smoke lines beside them. Gun 20.3 kg, balanced on the pivot.
    - **Elevation 0-45 deg, pivot raised 73 mm to z 645.** The chambers reach 460 mm behind the pivot. At 60 deg
      they swung down through the electronics shelf and the rear manifold, fill plug and main-valve lever; 45 deg
      is about the best range angle anyway. The bearing towers now stand about 15 mm above the deck, inside the
      gun well, which is 266 mm wide (was 224).
    - Envelope: 62.2 in long with the gun level (the muzzles reach 25 in past the front bumper), 30.9 in tall.
    - Elevation belt 150T (was 135T) so the motor stays above the side tanks.
M8. **Third tank: no room.** The side tanks already fill the zone you circled (x -134..226, |y| 87-239, z 280-440).
    Between them, a 6 L lengthwise needs 360 mm but about 295 is free (the gun's rear swing behind, the front face
    ahead). A tank across the robot (3 gal 170 x 520 or Ridetech 178 x 479) fits at x ~80, z ~335 with its ends in
    the middle of the front side windows, but only in place of the two side tanks. So D.1 keeps two 6 L tanks (12 L).
M9. **Detailed pneumatics in Onshape.** Every air part is now a recognisable fitting (hex bodies, thread stubs,
    push-to-connect collets, valve coils and levers, relief pull rings, transducer plugs; `cad/glacis/pneu_parts.py`),
    and each one's Onshape Description says what it does.
M10. **Onshape is grouped by system:** sub-assemblies for the body panels, body frame, lights & speakers, bumpers,
    pneumatics, power & smoke, chassis & drive, and the gun. Click one's eye to hide or show it.
M11. **Checks:** sweep 0-45 deg clean, nothing over the bed, every part one solid. Two fittings' hex bodies touch
    (146 and 64 mm3) at the valve cross and the manifold's fill elbow, where a real close nipple would space them.
    Weight 174 lb (gun 20.3 kg). Parts $1,888.37.

## Rev D.1.1: LEDs, light bar, tanks, parts cost-down (2026-11-04)
Onshape version "Glacis rev D.1.1"; renders in `docs/glacis/render_d1_1_*.png`.

N1. **LED loops (your notes).** Every corner radius is 2/3 of C.3's (windows 15 mm, acrylic 18.7, LED corners 15), and
    each kind has its own variable in `params.py`: `WINDOW_R`, `ACRYLIC_R`, `LED_CORNER`, `FLANGE_ROUND`, `CLIP_ROUND`,
    `RAIL_EDGE_R`. The rail's free back edge rounds over (2.5 mm).
    - The strip face now starts right at the window edge on every side (19 mm in), so the dead band is gone. On an
      edge shared with another panel the two rails meet back to back in a point.
    - The strip is 5 mm closer to the acrylic (0.96 in behind the panel, was 1.15) and the rail is 5 mm shorter.
    - Where three panels meet, a neighbour's corner turn crosses the loop. The strip is cut there and jumped with 3 wires:
      8 jumpers on the robot.
N2. **Front light bar: your Zmoon 12 in** (72 W, spot/flood) across the nose just above the bumper, on two printed
    brackets. Its face stays inside the bumper line.
    - The STM32 switches it, and can PWM-dim it, through a MOSFET channel (about 6 A).
    - Amazon lists only "12 in", so it's modelled 330 x 30 x 45 mm [UNVERIFIED].
    - The lens-pod bars from the AliExpress search are out.
N3. **Tanks: the EVIL ENERGY 2.5 gal (9.5 L, 200 psi, 498 x 200 x 160 mm, steel 4.55 kg, $98.99) isn't worth it.**
    The CAD test-fit:
    - **Sides, lengthwise:** about 381 mm is free ahead of the battery bays, but the tank needs 498. At every position
      tried it runs into a battery and pokes through the side wall.
    - **Across the front:** one fits, at x 60 and z 330. It only needs the fog line to the gun rerouted. But it sits in
      the same space as the two side tanks, so it can only replace them.

    Shots at 120 ft per charge to 150 / 175 / 200 psi, both cannons alternating:

    | Air | Cost | HSV04 opens in 50 ms | in 80 ms | Fits? |
    |---|---|---|---|---|
    | **Two 6 L (now), 12 L** | $112.62 | 9 / 11 / 14 | 6 / 8 / 10 | yes |
    | One EVIL instead, 9.5 L | $98.99 | 7 / 9 / 11 | 4 / 6 / 8 | yes, in their place |
    | Two EVIL, 18.9 L | $197.98 | 13 / 17 / 22 | 8 / 12 / 16 | no |
    | Two 6 L + one EVIL, 21.5 L | $211.61 | 15 / 21 / 25 | 10 / 14 / 18 | no |

    - **For the EVIL:** steel, 6 ports, well reviewed. Two of them would nearly double the shots.
    - **Against:** two don't fit without moving the batteries back and growing the body. One alone holds less air than
      now, and the steel adds about 6 kg over two.
    - **The cheaper lever is the valve:** bench-test the HSV04 and charge to 200 psi.
N4. **Parts cost-down: $1,888.37 to $1,359.91.** Every line is now the cheapest of AliExpress (your logged-in
    prices), Amazon and McMaster.
    - **Your cuts:** no rivets (your screws), the old 9 in mecanum for now (608s, M8 rod, nylocs, hub bolts and 140T
      belts off), and the goBILDA owned.
    - **Biggest savings:**
      - relief valves -$39.09 (McMaster 48435K72: ASME, ring pull, $6.67);
      - speakers -$40 (SoundAlert $59.99, 2 in deep like the old pick, 8 ohm);
      - barrels -$36.86 (3 ft tubes are the 36 in barrels);
      - couplings -$31.60;
      - LED strips -$23.24;
      - one push-to-connect pack instead of two -$19.99 (the CAD uses 8);
      - E-stops -$17.48;
      - most electronics moved to AliExpress.
    - **What went up:**
      - fog core +$11.97 ($22.42 was the new-shopper price);
      - check valve +$8.82 (Zoro isn't one of the three; AliExpress check valves are 145 psi);
      - Zmoon bar +$12.74 over the AliExpress bar;
      - sealant +$4.53;
      - an estimated $15 for McMaster shipping.
    - **Still off the three sellers, on purpose:**
      - the Aignep in valves: nothing at the three is 1/4 NPT, direct-acting and rated 200 psi under $155;
      - the HSV04: Amazon's only 200+ psi 1 in valve is $156.66;
      - the pool noodles: Amazon's are $33 for six.
    - **Kept the dearer, rated part on the pressure side:**
      - AliExpress relief valves are $2.69 but unrated;
      - its brass crosses state 850 kPa (123 psi);
      - the cheaper transducer doesn't state 0.5-4.5 V.
N5. **Not checked yet:**
    - AliExpress started showing a slider captcha after the parallel lookups, so the cheapest siren speakers there weren't
      searched. Solve the slider once in your browser and I'll look.
    - The M5 insert price is assumed equal to the M4 pack.
    - The canvas colour on Amazon, the Zmoon's size and the SoundAlert's height are unconfirmed. The speaker cup may need
      a few mm once it's in hand.
N6. **Checks:**
    - The light bar clears everything.
    - Sweep 0-45 deg is clean, nothing is over the bed, and every part is one solid.
    - The same two fitting slivers as D.1 remain (146 and 64 mm3): where two male threads overlap inside a 1/4 cross, the
      model engages them deeper than a real joint does.

## Rev D.1.2: the LED band is the window wall (2026-11-04)
Onshape version "Glacis rev D.1.2"; sections in `docs/glacis/led_sections_d1_2.png`. This replaces N1's rail.

N7. **Your fix list:**
    - **No rail, no flange.** The window wall runs straight back from the ledge the acrylic sits on (the only step) and
      carries on past the member as a 2.5 mm web.
    - **The strip** sits on that wall's last 10 mm, centred 25 mm behind the acrylic. It leans 10 deg toward the panel
      on the straight runs and stands square round the corners. The bend into the lean is the only "chamfer".
    - The strip needs only about 8 mm to stick to; the band is 10 mm, the strip's width.
N8. **No strip touches another strip, a web or the frame**: 0 overlaps, 0 jumpers, with 99-100% of every loop kept.
    The rule that does it:
    - **Shared corners:** each panel's web and strip stay on their own side of the corner's bisector, so the two
      neighbours' strips meet back to back at a point. That puts the window edge 31-36 mm in from a shared edge,
      depending on the angle (91 deg 36, 94 deg 35, 98 deg 32.5, 100 deg 31.4): in between the old 42 and the 19
      that overlapped. At 19, each web hung into the neighbour's window and ran into its seams and corners.
    - **Every other edge** stays at 19 (gun-well edges 24). The build pushes in any edge whose strip would hit frame,
      4 mm at a time. None needed it.
    - **The cost:** wider solid members on the shared edges, so the frame is 5.64 L of PETG (was 4.44). Hollowing their
      hidden back would only win about a third of that back, because the neighbour's member already fills most of
      the extra width.
N9. **Clip inserts no longer break out of a slanted face.** Each hole is tested against the outer surface with a 1 mm
    skin and shortened if needed. At the two deck-front corners, where two clips merge, the second screw would break
    out whatever the depth, so each of those clips keeps one screw.
N10. **Also fixed:** the light bar brackets' upright tab now sits behind the bar instead of inside it (2,880 mm3 each).
     Checks:
     - interference: only the two known fitting slivers;
     - sweep 0-45 deg clean;
     - nothing over the bed;
     - every part one solid.

## Rev D.1.3: chamfered window wall, filled LED corners, bent frame strips (2026-11-04)
Onshape version "Glacis rev D.1.3". Replaces N7's straight wall.

N11. **The thick edge is chamfered away, everywhere.** The acrylic keeps its 7 mm ledge (the only step). From the ledge's
     edge, which follows a line MEM_W in from the panel edge rounded at the corners, the wall chamfers straight down to
     the top of the LED band, then the band, then the skin.
     - Below the member the window cut is only a 4 mm ring inside the LED line. It clears the strip and nothing else.
     - Frame 5.17 L of PETG, down from 5.64 L (D.1.2), even with the corners filled.
N12. **The gap between back-to-back LED corners is filled.** On the 10 edges shared by two panels at an angle, the
     corner is solid between the two skins. The two strips sit on one V-shaped ridge that comes to a point, with no slot
     between them. Every way in for a joint screw there would come through the ridge or a surface you see through the
     acrylic, so those 24 joints are tapered tenons glued with epoxy. The other 57 keep their M4 cross screws.
N13. **Frame (interior) strips are modelled as one piece per member.**
     - Each strip lies on its tunnel's inner wall with the LEDs facing out.
     - At each end it bends the easy way (about its width), up to 8 mm radius, up into the feed slot. It runs out to the
       slot's mouth at the bottom of the ridge, where it's soldered to the next member's strip. Each bend is sized so the
       whole strip width stays inside the slot.
     - On 6 short members the slot at one end is too short for even a 3 mm bend. There the strip ends straight at the
       slot and is soldered in place.
     - 8.7 m in all.
N14. **Checks:**
     - No strip touches another strip, a skin, a corner fill or the frame; 0 jumpers.
     - Sweep clean, nothing over the bed, every part one solid.
     - Only the two known fitting slivers.
     - An independent code review caught and fixed: the joint counterbore cutting both LED bands, a corner-fill gap at
       mismatched corners, buried solder ends, and the contact check not seeing strips.

## Rev D.1.4: printable frame, mounts, bumper ring, Xprite speakers (2026-11-05)
Micah's asks:
- hollow the prints to 2 mm and estimate plates, PETG and hours (0.6 mm nozzle, 2 walls, 10%, no slicing, frame only);
- review and clean up every part (clip 01-2, E04S0 + N13, N11, E28S0 + N14) and cut everything to the CC1/CC2 beds;
- tie the frame to the chassis perimeter and the turret towers (screwed from below into threaded inserts);
- bumpers that slide off the bottom, held by #10-32s from inside the chassis into wood inserts.

A nine-agent review of all 121 printed body parts then found 39 more problems (26 survived a skeptic, the
critic added 13), and the fixes are below. Onshape version "Glacis rev D.1.4". Your custom tank edits were versioned first,
as "Micah's edits (custom tank), before rev D.1.4".

N15. **Print plan** (docs/glacis/print_plan.md, from render/part_report.py):
     - each part in the orientation it prints in;
     - support from a ray cast, so tunnel roofs count as bridges;
     - plates packed from the real footprints.
     - **45 frame pieces on 11 plates: 2.97 kg PETG** (145 g of it support), **73 machine-hours, about 37 h with
       the CC1 and CC2 both running** (0.6 mm, 2 walls, 10% gyroid). Treat it as +/-25%: a slicer run will be closer.
     - At 3 walls (2 mm walls): 4.05 kg, about 50 h on both printers.
     - The other printed body parts (78 clips, posts, brackets, cups, grilles at 4 walls, 25%): 2.03 kg, 6 plates,
       about 27 h on both printers.
     - E13S0 and E31S0 touch the bed on a narrow strip: give them a brim.
N16. **Nothing is hollowed in the CAD.** At 2 walls and 10% gyroid the slicer already prints every piece as a
     1.3 mm shell over sparse infill, so a modelled 2 mm hollow would only add inner walls. If "2 mm" means the wall
     thickness, that's 3 walls (the plan gives both).
N17. **Your examples:**
     - Clip 01-2 (and its mirror 05-0) lapped the acrylic by 0 mm³. That panel's face ends in a spike by the
       speaker notch, and the acrylic's corner sits about 75 mm back from the tip. The two tip corners now act as
       one: the clip runs down the spike to the acrylic's corner, with its screw where both members are wide
       enough to clear their light tunnels. Every clip now has to lap at least 120 mm³; all 38 do.
     - E04S0 is part of the cheek, and N13 (now N12) is merged into its neighbour.
     - E28S0 + N14 (now E29S0 + N10 + E28S0) and its mirror are merged, along with the two lone sticks at the
       rear-top corners. Short segments merge into their one off-edge neighbour when the union fits the bed and
       lies flat.
     - N11 (now N00): the node across the gun well's front is still the only glued split. Its halves are merged
       into E05S0 and E05S1, and both fit the bed.
     - The rear one (N09) is gone: its region now leans out along the well floor.
     - 45 frame pieces, mirrored left and right (a mirror-consistent cut order), 51 tenons, no loose ends.
N18. **Frame to chassis.** Sized for your #10-32s (1/2 and 2-1/2 in):
     - **Side walls:** the bottom member sits right on the bumper, so each side station has a tab on the frame's
       inner face, out over the outer rail. A post on the rail holds it: 2-1/2 in up through the rail into the
       post's foot insert, then 1/2 in up from the post's outer pocket into the tab.
     - **Ends:** posts on the end rails at y 0 and +/-170. The outer two stand on the corner gussets.
     - **Towers:** a bracket on each tower's outer face, two 1/2 in screws in +/-3 mm slots into rivnuts. Nothing
       pokes into the gun well, and you set the height against the deck at assembly.
     - The x -150 station moved to -205: there its tab blocked a frame joint's cross screw. The build now checks
       every tab and insert against the joint screws and tunnels.
N19. **Bumpers are one ring.**
     - **Screws:** the old front, rear and outer side screws were unreachable (behind the wheels, the PDH and the
       bellypan). The 6 that hold the ring are at x -80, 0, 80 through each side rail, driven from the open bay
       underneath.
     - **Corners:** printed brackets join the four plywood strips (2 x 1/2 in per leg from the rail side, heads
       counterbored flush).
     - **T-nuts:** #10-32 4-prong T-nuts replace the wood inserts. A 10 mm insert doesn't fit 1/4 in ply. The T-nut
       goes in from the noodle side, so the screw pulls its flange into the ply; file its barrel to 6 mm.
     - **Axle screws:** the side strips have open-bottom slots past the axle-end screws.
N20. **Clips and panels:**
     - **Inserts and screws:** M4 x 6 inserts (5 mm OD, 4.7 mm hole, as bought) with M4 x 8 screws. Where two
       neighbouring panels' clip screws met inside a node (10 pairs), or a face was close, a short M4 x 4 insert
       and an M4 x 6 screw (12 clips).
     - **Battery doors:** ordinary clips. The quarter-turn latch couldn't turn in its pocket, and its insert ran
       through a light tunnel.
     - **Acrylic:** cut 1 mm under per side, with 1/16 in foam tape on the ledge (the rebate is 0.7 mm deeper) so
       the clips clamp it.
N21. **Speakers: Xprite 200 W (B01DMSR4L4).**
     - **Cups:** sunk 7.4 mm deeper so the face stays put. Each cup is screwed to the frame by 4 M4 through its
       walls (it was only sitting in the notch).
     - **Amp:** "100 W drivers" read as the amps: a TPA3255 board on a 1500 W boost set to 48 V, about 100 W a
       speaker, on a 40 A PDH channel. If you meant something else, say.
N22. **Light bar brackets:** a plate on the front slant's bottom lip with 2 x M4 into inserts. The front and rear
     bottom members lose their light tunnel: it ran under the acrylic's rebate with paper-thin walls. A jumper wire
     goes round each. The front's LED web moved in to 23 mm, so those pieces have a flat face to print on.
N23. **Underglow brackets** sit flat on the rails again, stepping down under the corner gussets. Each has 2 x M4 and
     a clearance hole round the post screws' heads.
N24. **Joints:** TENON_CLEAR is 0.3 mm a side for the 0.6 mm nozzle; print a test joint first. Small 5 mm tenons get
     their own mortise and are glued. Where a tenon would push a piece past the bed, the neighbour carries it.
     Merges keep 2 mm of bed margin.
N25. **PETG for everything.** The notes that said PA-CF or PETG-CF now say PETG, 5 walls, 40% gyroid.
N26. **Still open (your call, or later):**
     - Diagonal placement on the 256 bed would allow longer segments and fewer joints.
     - The glow through 2-wall gyroid will show the infill: the plan suggests a 100% modifier on the lit lip.
     - Cap the 100/m frame strips' brightness in firmware: heat in PETG in the sun.
     - The rivnut grip range is [UNVERIFIED].
N27. **Checks (build 15):**
     - interference: only the two known fitting slivers (146 and 64 mm³);
     - the 0-45 deg sweep is clean;
     - every printed part fits the 250 mm bed, and every part is one solid;
     - every clip laps its acrylic, no two clip screws meet, and no clip insert crosses a light tunnel;
     - every segment end has a neighbour piece;
     - every insert found frame clear of the tunnels and joint screws: 16 frame-mount, 8 speaker-cup, 4 light-bar;
     - LED strips: 0 overlaps, 0 jumpers.

## Rev D.2 proposal: listing re-check, one controller, bumper foam (2026-11-06)
Micah's asks: review every part (pneumatics with every thread confirmed from its listing, electronics), find better or
cheaper parts, a stronger single-board controller with WiFi (and Bluetooth for music the dashboard still controls),
drop the PWM gate, GoTo Foam for the bumpers, a female fill valve, a 1x6 bumper backing at the next CAD update, the LED
lean 0.75 closer to the panels at the next Onshape update; no Onshape changes until he green-lights the parts list.
Artifact "Glacis air & wiring" (same URL) is now four tabs: an air sim, a power sim, the parts list, the review.

P1. **Fill line genders were wrong.** The male McMaster 1077T17 plug went onto a male 1-1/2 in nipple, and the
    "FNPT x MNPT" check valve (B076K8SLBZ) is male on both ends (listing photo). Now: Milton 728 1/4 FNPT M-style plug
    (300 psi per Lord Co./Toolsid; box of 10, $9.99) threaded onto the check valve, which itself passes through the
    rear panel, then two street elbows into the manifold. The 1-1/2 in nipple is freed. Micah: "the fill valve should
    be female".
P2. **Three street elbows were missing** from the parts list (the CAD has them: main valve, fill line). 5-pack $11.99.
P3. **Top chamber fittings: listing ratings below 190 psi.** Supply Giant's 3 x 1 coupling and 1 x 1/4 bushing both say
    "pressures up to 150 lb". ASME B16.3 rates Class 150 malleable iron at 300 psi up to 150 F, but the rule is rated
    parts by their listing. Proposed: 304 stainless 1 x 1/4 bushings, 350 psi (B0C7N73YVZ, $7.99, cheaper) on both
    chambers; MSI Products 3 x 1 couplings "150-300 psi" (Global Industrial, $27.95) on the top only. Micah's call: those,
    or cap the top at 150.
P4. **HSV04 thread is "NPT / G"**, one version, no option (the old note said to pick NPT). Test-fit a 1 in NPT nipple
    before trusting it at 190 psi. Price $98.19 confirmed.
P5. **SZW-25 listing now says 0-90 psi** for the 12 V DC valve (old note: 0-115). Bottom capped at 90 until Micah reads
    the plate. The 125 psi relief stays.
P6. **Tank**: photos show 2 side bungs + an end port and welded feet; the CAD has 3 bungs underneath and strap saddles.
    $56.60 list ($46.81 is a new-shopper deal). Fix at the next CAD update.
P7. Confirmed from listings (2026-11-06): relief 48435K72 1/4 MNPT, ASME VIII, 125 and 200 set options, $6.67;
    transducer 1/8-27 MNPT, 0.5-4.5 V, +/-1% FS; 9151K91 1/4 M x 1/8 F, 1,000 psi; crosses 1/4 FNPT x4; close nipples
    and plugs 1/4 MNPT, 1,200 psi; DOT tube 1/4 OD J844 1,150 psi; push-to-connects 1/4 tube x 1/4 MNPT 250 psi J1131;
    Aignep 02F 1/4 NPTF both ends, 2 mm, 0-35 bar, $41.36. Not re-read: the Dwyer ball valve (Zoro blocks reads) and
    McMaster 44615K416. No psi stated: the 3 in nipples, the street elbows, the barrels.
E1. **One controller: ESP32-P4 + ESP32-C5 on one board** (Wireless Tag WTDKP4C5-S1, $29.29 AliExpress). Replaces the
    STM32F411 + ESP32-C5 bridge + their UART. Keeps 2.4 + 5 GHz WiFi 6, adds MIPI-CSI + H.264 (camera), 16 parallel LED
    lanes, a UART for a lidar. ADS1115 ($7.99) for the transducers (settled: ESP32 ADCs too nonlinear); the P4 ADC reads
    the pot and battery volts. Catches: new board (3 sold), ESP-IDF wanted for camera/LEDs, Arduino partial.
    Considered: ESP32-S31 (the only one-chip WiFi + Bluetooth Classic, but 2.4 GHz only, ESP-IDF preview, no Arduino),
    Arduino GIGA R1 WiFi ($65.54, 2.4 GHz only, no A2DP in the Arduino libraries, Mbed core being retired), Pico 2 W.
E2. **Bluetooth music** needs Bluetooth Classic (A2DP); only the original ESP32 and the S31 have it. A $8.99 ESP32
    WROOM board is the phone's speaker and streams I2S into the P4, which mixes the horn/effects and sends volume/pause
    back over a UART. If it dies only phone music stops. Alternative: songs stored on the robot, picked from the dashboard.
E3. **PWM gate removed** (Micah). The contactor is the cut-off: its coil runs through rear E-stop contact 1, the safety
    node's switch and the main controller's MOSFET in series. The safety node's only job is holding that coil while the
    remote's and the controller's heartbeats are alive. The valve arm relay stays (coil from the PDH through E-stop
    contact 2, armed by the controller). 74AHCT125s now only level-shift the LED data; the new MOSFET modules trigger
    from 3.3 V.
E4. Firmware latch modelled in the sim: power lost without a command = stays off until Enable is pressed again.
B1. **Bumper foam**: GoTo Foam 5 x 24 x 24 in, 43 ILD, $19.99 (Micah's pick) replaces the noodles. **Backing becomes a
    1x6** (Micah, next CAD update): 3/4 in is 1/2 in thicker per side than the 1/4 ply, so the foam is cut 2 in deep
    (not 2.5) to stay 27.75 in wide under the 28 in door limit; 5-1/2 in tall vs 5 in of foam (rip it or let the canvas
    cover the step); T-nut screws become the 1-1/4 in #10-32s. Lumber price is an estimate ($9 a board).
C1. Cost-downs: barrels to K-mac on Amazon (same 3.00 x 2.75 x 1/8 x 36 in PC tube, $45.81 vs $66.05), fog core now
    $26.38 at his price, one contactor ($12.99), diymore logic buck-boost ($8.17), MOSFET 10-pack ($6.29), Hillman tee
    nuts, FogUp gallon for a quart's price, light bar $17.99, McMaster shipping $10 (no long box). Kept: TPA3255 + 48 V
    boost (100 W into 8 ohm needs ~28 V RMS), Xprite speakers (cheapest real 200 W), the potted 20 A buck.
D12 (rev D.2). **Money**: $1,373.42 -> **$1,382.62 (+$9.20)**: cost-downs -$73.98, fixes +$26.34, Micah's changes
    +$56.84 (controller swap +$11.87, ADS1115 +$7.99, music board +$8.99, foam +$9.99, 1x6 est. +$18.00).
Queued for the next Onshape update (after the green light): LED lean 10 -> 10.75 deg ("0.75 closer to the panels";
read as degrees, to confirm), 1x6 backing + 2 in foam, the fill line re-route, the real tank ports and feet, one
controller board + music board + ADS1115 + one contactor on the shelf, MSI couplings and stainless bushings on top.

### Rev D.2, Micah's follow-ups and the green light (2026-11-06)
F1. **Bottom cannon to full tank pressure** ("the bottom has to do the full 200"): a second U.S. Solid HSV04 ($98.19)
    replaces the SZW-25 (now spare, listed 0-90 psi); MSI 150-300 psi couplings on both chambers (the Supply Giant pair
    is gone); a 200 psi relief on both chambers (four 48435K72 at 200, the 125 psi one is gone). Both caps 190 psi: the
    tanks are rated 200, so a chamber can't usefully exceed the tank, and 190 keeps the 200 psi reliefs from simmering.
    +$106.11. The gun re-balances itself (gun.py solves the CoM onto the axle).
F2. **Fill line, corrected again:** the check valve can't pass through the panel (its 1/4 NPT male end is ~10 mm and
    the panel is 5.7 mm, leaving ~4 mm for the plug). Final chain: female Milton 728 outside <- the owned 1-1/2 in
    nipple through the panel (the elbow sits 27.7 mm behind the outer face, so the nipple reaches the plug with ~3 mm to
    spare) -> 1/4 FNPT x FNPT 90 deg elbow (ChillWaves 2-pack, $7.99, 1,200 psi) <- male x male check valve -> street
    elbow -> rear manifold. Street elbows used: 2.
F3. **Open ports audit:** rear manifold ends 2 + up to 3 spare bungs per tank (photos show 3-4) = 8 of the 10 hex plugs;
    the valve cross and chamber crosses have no open port. One low tank plug doubles as the drain.
F4. **LED lean 17.5 deg** (Micah; supersedes the 10.75 reading of "0.75 closer"). params.LED_BAND.
F5. **Bumper backing 1x6 ripped to 5 in** (3/4 in), foam 2 in deep x 5 in: the envelope stays 27.75 x 37.74 in and the
    5 in bumper height, so nothing above it moves. Foam modelled as one mitred strip per side (cut from 24 in lengths).
F6. **E-stop placement** (his question): stays in the contactor's coil circuit, a hardwired power wire, not data. A 22 mm
    E-stop's contacts are rated ~10 A and the main line peaks near 160 A; the contactor switches the current, the
    E-stop cuts its coil, so no software can hold power on. The 120 A breaker is the main-line manual kill.
F7. **Compute headroom (estimate)** for the ESP32-P4: with the web UI to 8 browsers, 1 kHz control, 1,680 LEDs at
    60 fps on 8 PARLIO lanes, audio mixing, 720p H.264 to one viewer and a lidar: ~30% of the network/camera core and
    ~20% of the control core busy (65-75% headroom each); ~500 KB of 768 KB SRAM and ~20 of 32 MB PSRAM free. Video
    bandwidth through the C5 link and WiFi airtime is the real limit (one 720p or two 480p streams, ~10-20 Mbps).
F8. **Barrels, cheaper pipe:** clear PC (K-mac) $91.62 for two vs one 10 ft stick of 3 in Sch 40 solid PVC (Charlotte,
    $37.31 at Home Depot) for both: -$54.31, but opaque, 3.04 in bore, 3.5 in OD (spigot and four prints resize).
    Not changed: Micah's call.
D12 (rev D.2 final). **Money:** $1,373.42 -> **$1,496.72 (+$123.30)**: cost-downs -$73.98, fixes +$34.33 (incl. the
    FxF elbow), Micah's changes +$162.95 (controller swap +$11.87, ADS1115 +$7.99, music board +$8.99, foam +$9.99,
    1x6 est. +$18.00, bottom cannon to 200 psi +$106.11).

## Rev D.2.1: Waveshare controller, speaker tap, battery relays (2026-11-09)
Micah's asks: a board with the USB plugs (he picked the Waveshare ESP32-P4-Module-DEV-KIT on Amazon), use its speaker
output for the amp at a low volume instead of buying a line converter, his spare ESP32-C3 SuperMinis, and "a relay to
one of the battery leads and voltage checking to both so it can automatically disconnect the lower battery until they
are close enough in voltage".

W1. **Controller:** Waveshare ESP32-P4-Module-DEV-KIT, $28.79 (Amazon B0FDWZ6KWT, sold by UeeKKoo, 3.6 stars from 10).
    Gains USB-A + 2 USB-C, RJ45, a Pi-style 40-pin header (28 GPIO, takes Pi HATs), ES8311 + NS4150B + mic + speaker.
    Loses 5 GHz (the C6 is 2.4 GHz): the D.2 reason for the C5 (crowded gyms) is gone, so the AP runs 2.4 GHz.
W2. **Pins:** D.2 needs about 38 signals (5 drive PWM, 10 MOSFET outputs, valve arm relay, 8 LED lanes, I2C, 1-Wire,
    lidar UART, music I2S + UART, pot, heartbeat, 2 battery relays) against 28 header GPIO. A PCA9685 ($5.99) takes 12
    slow outputs (drive PWM, fog, light bar, battery relays; one ~200 Hz frequency, full-on/off for switches); OE pulled
    up and driven low by the controller so a crash turns them off. Valves, LED data and the contactor stay direct.
    Battery, bus and PDH volts move to a second ADS1115 (a 2-pack for the single's $7.99); the P4 ADC reads only the pot.
W3. **Speaker output to the amp:** not straight in at low volume. The NS4150B is a filterless bridge-tied class-D amp:
    each speaker wire switches 0-5 V at a few hundred kHz around 2.5 V DC whatever the volume (volume only changes the
    duty cycle difference between the two wires), and the amp's input ground is the robot ground, so wiring SPK- to it
    shorts the amp's output. The tap: SPK+ through two 1k/10 nF low-pass stages (16 kHz each, the carrier drops ~1000x)
    and a 1 uF cap (blocks the 2.5 V) into the TPA3255 input; SPK- unconnected. One wire gives about half the swing, up
    to ~1.8 V RMS, against the ~1.4 V RMS the TPA3255 needs for 100 W at 26 dB gain, so no divider. Parts from the kit,
    $0; the PCM5102A ($2.44) moves to LATER as the fallback if the amp whines. The $7 speaker-to-line converter is
    not needed.
W4. **Battery relays: two, not one.** One relay can only hold off the pack it's on; if the fuller pack is on the
    unswitched side, the robot would run on the emptier one and the gap would grow. So each pack gets a 200 A relay
    (the contactor's part, $12.99, 0.15 A coil) on a ULN2803 channel. Normally open + a 4.7 ohm 5 W bypass across each:
    power-up and a dead controller leave both open, the bypass still feeds the logic rail and trickle-balances the packs,
    and the contactor drops anyway. Close rule: within 0.3 V (about 10 A of rush), comparing the connected pack under
    load with the other at rest, which is the difference the rush sees. Normally closed 100 A+ relays weren't found
    under $40 (Amazon search, 2026-11-09), and a diode-OR logic feed would have needed its own master switch.
W5. **Remote:** one of Micah's C3 SuperMinis replaces the $3.79 S3 SuperMini (ESP-NOW is the same). They can't be the
    phone-music board: Bluetooth LE only, no A2DP. The $8.99 WROOM stays for that.
D13 (rev D.2.1). **Money:** $1,702.75 -> **$1,733.78 (+$31.03)**: controller -$0.50, PCM5102A to LATER -$2.44,
    ADS1115 2-pack $0, PCA9685 +$5.99, two battery relays +$25.98, bypass resistors +$5.79, C3 remote -$3.79.
Queued for the next CAD update: the Waveshare board's footprint on the shelf (dimensions not on its page), two more
200 A relays and their bypass resistors by the battery bay, the PCA9685 and the second ADS1115.

## Brophy Borealis (2026-11-10, Micah's Windows Claude Code chat)

Micah's asks (via his Mac chat): name it Brophy Borealis; two orders; a better fill plug and self-sealing interior
quick disconnects; the light bar recessed into the front panel with a 3 in gap above it for crowd sensors; 20x20
extrusion each side of the top and the cannon hub, symmetrical and clear of the pivot; an Onshape assembly that pivots
with an Upmost / Downmost / Range / Free setting; then a BOM review, a steeper LED lean, and a faster build.

B1. **Name:** "Brophy Borealis" on the Onshape document, CLAUDE.md and the Sheet; the code stays `cad/glacis/`.
B2. **Two orders** (Sheet tabs "Borealis Order 1 - pneumatics, electronics, speakers" and "Borealis Order 2 -
    materials, LEDs, smoke"), each with an ALREADY HAVE block under it (owned and stash rows, $0). Old-cannon spares
    and LATER rows are gone.
B3. **Plugs:** fill plug is a 303 stainless industrial M-style plug (McMaster 6718K52); the five interior joints are
    Milton 715 couplers + 728 plugs (300 psi; the coupler seals the supply side when it's pulled), on DOT
    push-to-connects. $39.88 for all five against $243.60 for McMaster ISO-B pairs. Still rated metal parts: nothing
    printed on the pressure side.
B4. **Light bar pocket:** the Zmoon bar sits 20 mm back from the front slant in a pocket with a level floor (z 266),
    level roof and upright back wall, so the bar and anything mounted on the 3 in blank band above it point straight
    ahead. A printed liner in two halves (split at y = 0 for the bed) lines it and carries the bar; 6 screws into the
    frame. The front fog tube was rerouted under the pocket floor (it clashed with the liner).
B5. **20x20 rails** (Micah's spares, $0): one inside each gun cradle plate (300 mm, 3 x M5 x 10 each), and two pieces
    each side of the deck along the gun well (245 mm behind the pivot, 155 mm ahead), with a 70 mm gap round the
    axle stub, angle pot, coupler and its bracket, which the one-piece rail ran into. All mirrored about y = 0 and
    clear of the 0-45 deg swing. The deck pieces' M5 x 30 screws come up from inside the well; the member's LED light
    tunnel runs under the rail's inboard half (|y| 137-142), so the screws go outboard of it (|y| 148.5), through a
    U-slot in the deck acrylic's edge, and the rail clamps that edge. 8 of 8 screws find frame.
B6. **LED lean 22.5 deg** (was 17.5), reached 15 mm after each corner arc (was 40 mm square + 40 mm ramp), smoothstep
    so there's no flat spot. A 2 mm square lead-in stays: with 0, OCC built an invalid window loft on the rear panel
    and the window cut deleted the whole frame (body.build now stops on an invalid window cut or a collapsed frame).
    Checks: LED strips 0 overlaps, every loop kept 100%, 0 jumpers.
B7. **Build speed:** `par.py` runs the slow independent OCC jobs on 90% of the cores (14 of 16 here; GLACIS_JOBS=1
    for serial): frame sectioning, the piece contact table (Shape.distance on the twisted members was ~1.5 h serial),
    node-merge trial fuses, joint neighbour lookups, interference pairs, the elevation sweep and the STEP export (one
    tab per worker). Full robot.py: ~2 h 40 min -> 55 min, same results (52 pieces, 54 tenons).
B8. **Onshape:** each of the 9 sub-assemblies has one rigid group of all its parts and an "Origin" mate connector;
    Chassis & drive and Gun also have a "Pivot" connector on the axle line (x -40, z 645). At the top, every
    sub-assembly but the gun is fastened to the origin, the gun has a revolute on the pivot connectors (+ = barrels
    up, configured limits), and a "Gun angle" configuration: Range (0-45 limits), Free (no limits), Upmost and
    Downmost (the revolute swapped for a fastened lock at 45 or 0 deg). **Known issue:** Onshape keeps one stored
    position for every configuration and doesn't re-solve on a switch: server renders of all four settings are the
    same 45 deg pose, even after re-saving the lock in Downmost. Dragging in Range/Free is the reliable way to set an
    angle; the fix would be a separate gun instance per fixed setting, shown by configured suppression. Micah
    (2026-11-10): "Range drag is fine", so the fixed settings stay as they are.
B9. **Front light bar hole** (Micah, same day: "it should start from the bottom and just be a hole, not plastic frame",
    aluminum extrusions inside to mount the light and other things, "from the bumper to 4.5in above the bumper").
    Replaces B4's pocket and liner. The hole runs from the body's bottom edge (z 204.7, on the bumper) to z 317.5
    (4.5 in above the bumper's top), |y| < 175, open at the bottom; its edges are plain 19 mm frame members, and the
    front acrylic is now one U-shaped sheet round it (8 panels, was 9). Two 372 mm 20x20 rails cross it behind the
    shell, lying flat on the frame's inner face (tilted with the 60 deg slant), one along the bottom and one level with
    the top (372 mm: at 380 their ends touched the LED walls of the windows beside the hole's top corners), each held
    by one M4 x 8 per end from inside, through a hole CNC'd across the rail into an M4 x 4 insert in the inner face
    of the frame member beside the hole: screws through that member from outside hit its LED light tunnel near the
    bottom, and from inside no heads show on the front. The bar
    stands on the lower rail on its own end brackets (M4 x 8 into T-nuts; its side bolts set the aim), bottom at
    z 241, clear of the fogger, 4 mm behind the slant at its top edge; the upper rail is free for sensors. The front
    end of the chassis now has 2 frame mount posts at y +-205 (was 3 at 0 and +-170, which the hole left without frame
    over them).
B10. **In-well rails and the pivot mount** (Micah, same day, from a screenshot of the deck rail beside the bearing
    block: "move the extrusion to be inside the cannon section, not on top of the panel, it can go through the 1x2
    going up holding the pivot", "push the pivot up a smidge", "cut off the 1x2 at the extrusion and run a plate from it
    to the extrusion and to the bearing", "outside is fine, just make sure it wraps the frame, i want the extrusion and
    the frame to be seamless"). Each deck rail is now one 470 mm piece inside the gun well (x -320 to 150), flush with
    the tower's and bearing block's outboard face (|y| 109.35-129.35) and 2 mm under the deck (z 608-628). The 1x1
    tower stops under it, the bearing block sits on it (2 x M4 x 12 into T-nuts), and the pivot went up 11 mm
    (z 645 -> 656). A 1/8 in tower plate on the outboard side (not the inside: the 112T pulley sits just inboard of the
    right block) runs the rail's length between it and the deck's well-edge member, wraps the tower's outboard, front
    and back faces (4 rivets) and runs up the block (its 1/4-20s); the axle and pot coupler pass through a hole in it.
    The rail's screws are M4 x 30s through holes CNC'd across its core (8 mm head access from the well) and the plate
    into inserts in the member's inner face at z 618, under the member's light tunnel (z 620-623). The elevation motor
    bracket's web now stops under the right rail and bolts into its bottom slot. The turret tower brackets and their 4
    rivnuts are gone: the rail screws over the tower hold the deck to it. The deck acrylic's U-slots are gone too.
B11. **Welded chambers and the Mac chat's batch** (Micah's calls in the Sheet's column J; the Mac chat's answers in
    column K, now kept in `bom/glacis_bom.py` COMMENTS). 3 in Sch 40 plain-end pipe (top 12.9 in, 1.56 L; bottom
    10.9 in, 1.32 L) between two 3/8 in A36 discs, 3.5 in OD, flush with the pipe (waterjet). The valve screws onto half
    of a 1 x 4 in nipple welded through the front disc's 1.33 in hole, flush with its inner face (24 mm between the
    valve and the disc for the weld). The back disc is blank. The 1/4 NPT weld bung sits 1 in behind the front disc
    on the tube-lane side (-y), turned 30 deg toward the axis, with a swivel push-to-connect elbow pointing forward to
    where its tube drops out of the core. At 45 deg straight toward the axis, the two cannons' elbows met between the
    chambers. The reducing couplings, bushings and the crosses, reliefs and transducers on the chambers' backs are gone.
    Each chamber's transducer and 200 psi relief now sit on a brass cross right after its in valve on the chassis,
    modelled at the ChillWaves cross's ~33 mm across the ports (at the generic 25.4 mm the hexes collided). The gun
    lost 2.5 kg (18.9 kg) and rebalanced with the valves 55 mm further forward. The smoke line is 1/2 in ID x 5/8 OD:
    the splitter's gun barb is 1/2 in (10 mm bore, was 7 mm), and the breech block, mantlet and collar passages are
    opened to suit (collar's inner passages 10.5 mm). M4 throughout: every insert M4 x 4 (holes and screw lengths as
    drawn), cradle-plate rail holes 4.5 mm with M4 x 8s, chamber caps on M4 x 12s. The fill plug comes from the
    Lnrueg M-style kit and the fill check valve is the 304 stainless male x male one. PITCH stays 112 mm, so the 23 mm
    gap between the chambers keeps room for the tubes. Cannon A's cross sits beside the left tower, so its transducer
    stands up and its relief hangs down through a notch in the electronics shelf; cannon B's lie flat (pointing down,
    its relief hit the main breaker).
B12. **Elevation 0-85 deg** (Micah, same day: "the gun should swing to 85"; read as 85 deg). The welded chambers are
    shorter and the pivot is higher, so at 85 deg the chambers' back ends reach about z 290 just behind the pivot. The
    gun well's floor (cut from the swing) now reaches z 281 under the axle (351 at 45 deg). Precheck: 0 clashes from 0
    to 85 deg against everything outside the body; the full build's sweep and interference checks cover the body.
B13. **GOGO in valves** (Micah, via the Mac chat): GOGO GPG-M03 2/2 NC direct-acting 12 V, G1/4 (BSPP) ports,
    modelled from the seller drawing (40 x 26 mm body, 76 mm to the top nut, coil + DIN plug 82 mm long), coil up,
    flow toward the chamber. Each port takes a G1/4 x 1/4 NPT 304 hex nipple (19 mm hex drawn) with a bonded seal; the
    QD on the inlet side isn't drawn. The runs got about 20 mm longer, so the valve cross moved 51 mm back (x -300).
    That clears the rear-left Falcon, which cannon A's chamber cross hit. Cannon A's DIN plug points +y: pointed -y,
    it met cannon B's valve. The left tank tube's run behind the valves rose to z 282, over that plug. The valve cross
    is now drawn at the ChillWaves part's real ~33 mm across the ports (was 25.4), which also cleared the 146 mm3
    valve cross / line relief sliver that had been on main since rev D.2.
B14. **Elevation 0-90 deg; Onshape gun mate = one revolute with variable limits** (Micah, same day: "it should just
    be the limits on the revolute that are variables in the configuration panel. no need for those other fastens. ...
    at least 0-85 but you can go up to 90 if there's room"). A swing check of the pass-2 build (every gun part rotated
    about the pivot against every other exported part, 80-95 deg) found no clash with the body, chassis or anything
    fixed up to 95 deg, so ELEV_RANGE is 0-90. The only hits were with parts that ride on the gun (its two 20x20 rails)
    or flex with it (service and fog loops). Next build re-cuts the well floor for 90 and its sweep checks 0-90.
    Onshape: configuration = two variables, "Gun min angle" (default 0) and "Gun max angle" (default 90), 0-90 deg;
    the "Gun pivot" revolute's limits are #Gun_min / #Gun_max (+ = barrels up: both Pivot connectors were turned 180
    deg about X, which flips the sense without moving anything). The angle-lock mate is gone. (The 8 fasten-to-origin
    mates went too at first, with the sub-assemblies only locked, but a lock didn't hold the chassis against the pivot
    solve, so Micah asked for the static parts to be fixed to the origin: the 8 fastens are back.) The gun's two
    20x20 rails moved from the
    Add-on rails sub-assembly into the Gun sub-assembly so they swing with it. The old Gun instance carried a stale
    stored pose (60 deg and 487 mm sideways, off its pivot) that no solve cleared, so it was replaced with a fresh
    instance. Onshape doesn't re-pose the gun when the variables change; drag it, or set both to one angle and
    use the mate's "Apply limit position".
B15. **Pivot hubs; the pulley bolts to the plate** (Micah, same day: "try to clean up the cannon hub, it needs some work.
    also the pulley should screw to the aluminum side plate instead of going through the axle"). Before: a 10 mm
    printed puck on each cradle plate keyed the 1/2 hex stub, the 112T pulley hung on the right stub's hex 18 mm out
    from the plate, and about 32 mm of bare hex crossed to each bearing block, with nothing locating the gun between
    the bearings. Now each side has a 72 mm printed boss on the plate's outer face that runs out to 1.5 mm short of the
    inner pivot bearing, with a 19 mm lip that bears on that bearing's inner race (0.3 mm float), so the hubs also
    locate the gun sideways. Right: the boss and the 112T HTD pulley are one print ("Elevation pulley 112T (pulley
    hub)"), with the belt plane unchanged (y -97 to -106) and a round 15.7 mm bore, so the stub only passes through;
    torque goes pulley -> plate. Left: "Axle hub left", hex bore (it keys the stub that turns the pot). Each takes 4 x
    M4 x 30 from its outer face (counterbored so 20 mm of print is under the head) through the plate into nylocs
    inside; the 4 bolts sit on a 28 mm circle at 30 / 120 / 195 / 300 deg, the angles that clear the fill and smoke
    lines and the valve side blocks inside both plates (checked against the gun). The plates' 6 x M3 hub holes became
    the 4 x 4.5 mm bolt holes. Checks (full build): interference 1 pair (the old 64 mm3 fill elbow sliver), sweep 0-90
    deg 0 clashes, every print fits the bed (the pulley hub is 183 mm across), gun 19.0 kg balanced on the axle.
B16. **Parts list: Kenzo's cheaper list, Amazon or AliExpress only** (Kenzo's "Cheaper Parts" tab, reviewed with every
    Amazon page re-read; Micah: "do the good ones ... amazon or ali are the ideal for everything. try hard not to have
    anything else"). Taken: brass close nipples (250 psi), the F x F elbow at $6.39, 2-pc street elbows, a stainless
    plug 10-pack, Litoexpe bushings (1200 psi), Boeray 35 ft DOT tube (500 psi), step bungs (24.8 mm collar; drill to
    it), cheaper continuous-duty contactors, a Diann blower 2-pack, $20.99 fog fluid (FogUp rose to $23.95), a MOSFET
    6-pack, iSANMATE PETG. His QD split is in with the plugs corrected to FEMALE thread (his were male, which don't go
    on the nipples). Off McMaster/Zoro: Loner ST25-1A ASME 200 psi relief 2-packs (pull ring), Grainger-approved 1 in
    Sch 80 close nipples (seamless A106, 300 psi; bore 24.3 vs 26.6 mm, about the HSV04's own orifice; the only Sch 40
    ones on Amazon are 150 psi decorative pipe), Amazon M4 nylocs; the McMaster shipping row is gone. Not taken: his
    M x F check valve (unrated, wrong gender), the ESP32-P4-WIFI6 (no USB-A, RJ45 or speaker amp), his canvas (no
    white), and his Amazon copies of AliExpress rows. The 1x6 bumper boards stay Home Depot (Amazon lumber is ~5x).
    Pre-tax $1,480.86 (Order 1 $1,039.12, Order 2 $441.74, no shipping rows), from $1,516.05.
B17. **Elevation: ring pulley on standoffs, belt centred** (Micah, same day: "remake it and its pair centered between the
    tower and the cannon. the cannon pulley should be a ring and have standoffs so its screwed to and floating on the
    side. the other pulley axle should be a touch shorter but the pulley further out ... I have a pulley design for
    whatever amount of teeth you want"). The 112T is now a printed ring (136 mm bore, the axle runs through its open
    middle) on 6 M4 x 10 stainless coupling nuts used as standoffs, 10 mm off the right cradle plate: M4 x 8 from
    inside the plate, M4 x 12 through the ring (7 mm counterbore). They sit on a 78 mm circle at 10 / 90 / 150 / 210 /
    270 / 350 deg, where the heads inside the plate clear the valve side blocks and fill lines. Belt plane |y| 87.2 to
    100.2 (centre 93.7; the gap between the plate and the bearing block is centred at 93.1), was 95 to 108. The
    16T pinion slid out the same 8 mm on the goBILDA's 8 mm REX shaft (shaft drawn 22.8 mm, ending flush; the motor
    and its bracket don't move), printed from Micah's own pulley design. 16T/112T kept: the 150T belt still fits
    exactly (750 mm). The left hub (B15) is unchanged; on the right a printed hex sleeve on the stub, from the plate to
    the inner bearing's race, takes over locating the gun sideways. BEARING_BLOCK_Y is now its own number (109), no
    longer tied to the pulley. Checked without a full rebuild (Micah: "just rebuild those parts"): the gun and the
    tower/pivot/elevation parts rebuilt and swapped into the last full build's STEPs, then the rebuilt chassis parts
    against everything and the gun swung 0-90 deg every 5 against everything fixed: 0 hits over 30 mm3; every print
    fits the bed; gun 18.8 kg, balanced.
B30. **Frame in 40x40 T-slot (design branch `micah-windows/extrusion-4040`, not merged)** (Micah, 2026-11-12: replace all
    the 1x2 / 1x1 box tube with 40x40 T-slot, he has lots spare; M5 T-nuts, end taps and new brackets instead of rivets;
    bumpers may be bigger than the battery door).
    - **Profile:** standard 40x40 20-series: 2 slots per face (6.2 mm opening) at face centre +/- 10, four 4.2 mm cores at
      (+/-10, +/-10) tapped M5 for end taps, a centre bore (`lib.ext4040`; `simple=True` drops cores and bore for fast
      booleans). Taken at 1.5 kg/m. Check the vendor drawing for the core size before tapping.
    - **Members (24, 7.47 m):** outer rails 848 (full length), inner rails 768 and end rails 547.5 (butting), towers 461,
      sled posts 114.4, tank posts 94.8, arms 172.7 (8). Cut list: `docs/glacis/cut_list_4040.csv` (lengths, end taps,
      access holes). Every butt joint is 2 x M5 x 16 end taps on the diagonal cores, the socket head through a 10 mm access
      hole in the far face of the member it butts against (52 holes; the 4 tower tops take M5 x 35 down through the
      in-well 20x20 rail instead). The corners also get flat 1/8 corner plates top (C) and bottom (L) on T-nuts.
    - **Y stack (gun side fixed):** `GUN_RAIL_Y` 129.35 is the datum, so the gun well, deck rails, bearing blocks, towers
      and pulleys don't move. Outward: side plate, inner bearing plate, flange, 1.5 mm printed thrust spacer, wheel,
      1/4 in hex collar, flange, two outer bearing plates, outer rail. FW 627.5 mm (24.70 in, was 22.25); 30.2 in over the
      bumpers (they come off), 26.6 in over the body; length 38.9 in over the bumpers (FRAME_X 424, +14.6). The plan's
      option B (+29.2) wasn't enough once the bearings needed two plates each side and the collar.
    - **Axle (Micah: keep the live 1/2 hex axles and the 9 in wheels):** no hole in any extrusion. A flanged hex bearing's
      5/16 in body needs two 1/8 plates, so the inner one is pressed through the side plate (bottom-open slot) and a bolted
      inner bearing plate over it, the outer one through two stacked outer bearing plates on the outer rail's inboard face.
      The hex axle is captive 0.5 mm off each rail face; a 1/4 in clamping hex collar outboard of the wheel locates it.
      The 8 bearing-plate screws per wheel are countersunk M5 x 12 on the wheel hub's light-hole circle (r 43), so a hex
      key reaches each through a light hole. Wheel off: unbolt the Falcon (belt slack), take the 8 screws out through the
      hub, and the wheel, axle, bearings and plates drop out of the side plate's slot. The 12 bearing plates are one
      waterjet part (press fit 28.68 mm: ream to the bearing in hand).
    - **Arm heights:** the sled rails' top goes to 301.4 (+19.6; batteries to 307.4): the plan's 296.4 left 3.7 mm at the
      -215 rail's near edge over the wheel's 127 mm swept circle, now 8.7 (19.5 at -332); the tower is 5.0 mm from the -215 post. The tank arms stay at 281.8 and the tanks at
      z 364 (raising them 14.6 puts the right tank 0.3 mm under the elevation motor); instead the front tank post moves
      to x 165 (its arm's lower corner 6.9 mm off the front wheel's 127 mm circle, 8.2 straight up; the Falcon 6.2 mm
      from the post) and the rear one to x 0 (a 40 mm post at -60 hits the rear Falcon),
      the tanks to x 47.5 so all three bungs fall between and ahead of the arms, straps between the bungs. The rear sled
      post moves to -332 (the valve cross's line relief points at it); the corner plates start at x 354 to clear it.
    - **Side plates stay 1/8 with M5 x 10 button heads:** the inner bearing plate sits between the side plate and the
      wheel, so the wheel is 6.3 mm off the side plate and a 2.75 mm button head clears it; countersinking 1/8 for M5
      (2.8 mm head) would leave a knife edge. Countersunk only where flush matters: bearing plates (beside the wheel),
      bottom corner plates and bellypan (underglow, floor), underglow brackets.
    - **Brackets:** dropped the inboard plates (6), arm knees (14) and the riveted corner gussets; added 12 bearing plates,
      8 corner plates on T-nuts, and 13 cast 40-series corner brackets at the post feet and inner/end corners where they
      fit (the placer drops any that would hit a part or a wheel's swept circle: 19 of 32 candidates; the arms rely on
      their end taps, about 220 N per screw for a 3 kg pack 150 mm out). `check_fasteners`: every T-nut screw on a slot
      centre line, none closer than 12 mm in a slot or 8 mm from an end, every end tap on a core, nothing in an access hole.
    - **Bumpers:** 6 printed hanger blocks under the outer rails (2 x M5 x 12 into the bottom slots each), one M5 x 30 from
      each into an M5 tee nut in the 1x6 (was a #10-32 through the tube). Underglow brackets screw up into the outer
      slots (2 x M5 x 8 countersunk each) instead of 3M tape. Frame-mount posts: 2 x M5 x 12 into the rails' top slots
      (M5 x 16 where they stand on a corner plate) instead of the 2-1/2 in #10-32s; the body's own #10-32 x 1/2 screws and
      heat-set inserts are unchanged (swapping them to M5 is easy but touches every body print; left for Micah).
    - **Electronics:** the 40 mm inner rails' inner faces are at |y| 89.35 (were 103.95), so every bellypan part is
      inside |y| 87; eleven moved a few mm to stay clear of each other (the engraving marks follow).
      The tank lines run at |y| 84.5 (inboard of the posts, was 98) and drop 25 mm ahead of the rear cross (a drop
      straight over it grazed the wider body's rear frame nodes and the rear panel's LED loop).
    - **Hardware (CAD count):** 273 T-nuts (M5, 6 mm slot); M5 x 10 button 116, x 12 button 8, x 8 countersunk 79,
      x 12 countersunk 32, x 12 socket 30, x 16 socket 8, x 16 socket end taps 52, x 35 socket 4; plus 6 M5 x 30 and 6 M5
      tee nuts (bumper), 4 hex collars. No rivets (262 before), no CNC'd tube holes (299 before), no 2-1/2 in #10-32s.
    - **Mass:** extrusion 11.2 kg (the box tube was 3.9 kg real). Whole robot 95.9 kg in the CAD; without the body 79.3 -> 89.4 kg;
      about 1.8 kg of that is the old model under-weighing the tube, and about 1.5 kg of screws and T-nuts isn't in the
      CAD, so the real gain is about +10 kg.
    - **Open:** the Falcon spline now engages its pulley 9.9 mm (was 14.6: the pulley moved out 4.8 mm with the wheel);
      check the real spline length or use a 1/8 thinner inner bearing plate. The 4 tank-arm and 8 sled-arm joints have no
      bracket. Parts list not updated (Micah: not yet).
B29. **No rear E-stop; rear panel in one row** (Micah, 2026-11-12: "remove the e-stop bc the frc breaker has a red kill
    button already. move things tighter in"). The breaker's trip kills the logic rail too (the E-stop only dropped the
    contactor), so a kill now means a cold restart; the remote's E-stop still drops the contactor through the safety
    node. Row: breaker, charge port, fill plug, USB-C within 175 mm.
B28. **No QDs, straight connectors, flat rear cross** (Micah, 2026-11-12: "remove every quick disconnect except the fill
    one, we'll just use the tube connectors if we need to take off the cannon or a tank. we only need 10 tube
    connectors, none of them angled. also remove the angle 1/4 to 1/4 and just adjust the T to be horizontal and have
    the fill valve point out the back, the master pneumatic valve can be right on the inside of the robot").
    - The rear cross lies flat 120 mm right of the old spot (clear of in valve A's coil): fill check valve out the
      back through the rear panel with the fill plug on it, main ball valve straight off the front, tanks either side.
      The check valve's hex sits in a 24 mm panel hole; the main valve lever is inside (reach in through the rear).
    - Tank outlets and chamber inlets take straight push-to-connects; their tubes leave along the port and bend.
    - Concept branch in Onshape (not the design): in valves + sensors on the chambers' back ends.
B27. **Rear manifold is one real cross; no tank relief; no QD on the main valve line** (Micah, 2026-11-12: "P04-1 and
    P05-2 is redundant remove it. P10-1 idk what it is, its not a 4way"; "for the ChillWaves parts, just up the
    count on amazon"; "remove P02-1 so it can be a single cross for the rear manifold").
    - **Rear manifold:** was a drawn block of made-up port blocks (P10-1). Now one ChillWaves 1/4 NPT cross standing
      upright behind the rear panel: right tank line straight up, left tank line into its bottom through a swivel
      push-to-connect (the tube comes in from the front), the main ball valve on a close nipple straight off its -y
      end, and the fill check valve screwed straight into its +y end (the female elbow behind the panel now sits on
      the cross's axis, so the fill nipple is 2-1/2 in). Nothing points forward: the left sled post and rail are
      there. Two crosses on a nipple were tried first; the second one hit the sled post.
    - **Tank transducer** moves into the right tank's front bung (a 1/4 x 1/8 bushing, same as before; the rear bung was tried first and hit the tank-arm knee plate) in place of a plug.
    - **Tank relief (P02-1) deleted, Micah's call.** The valve cross's 200 psi relief now covers the tanks only while
      the main valve is open, and its ring is the hand dump. Flagged before he chose: with the main valve shut
      (filling, transport), nothing on the robot limits tank pressure. So fill with the main valve open, or from a
      source that has its own relief at 200 psi or less.
    - **Main valve line QD (P04-1 / P05-2) deleted:** the main valve already isolates that line. 4 interior QDs left.
    - **Parts list:** crosses are one ChillWaves 6-pack ($16.99) instead of two 3-packs ($25.98), 4 used; fill nipple
      1-1/2 -> 2-1/2 in (Legines B0747L5XQZ, $8.49); street elbows dropped (none left in the design, -$7.49).
      Total $1,562.42 -> $1,546.94.
B26. **Smooth smoke channels, LED bands open all round** (Micah, 2026-11-12: "the tube geometry is not very smooth
    ... scrap the air barb system and just try to make the angle smoother and a little longer. the part is thick
    enough"; the mantlet's LED groove "is some weird artifact ... make it exposed all the way around"; "add a spot
    for a strip like it on the fog and end pieces"; "a 5.5mm groove so i can put COB strips we already have").
    - **Smoke collar:** baffles gone. 60 mm long: the line's socket, a short plenum (the line's bore), then six
      swept 3/8 in channels, each leaving the plenum heading forward and curving out, tangent all the way, into
      its hole. The holes now lean 45 deg toward the muzzle and sit 22 mm ahead of the collar's centre. Checked:
      no channel breaks out of the collar; each only grazes its barrel's outside beside its hole (~8 mm3, air).
    - **LED bands:** one helper cuts a 5.5 x 2.5 mm groove from the part's own section, so it is open all the way
      round: the mantlet (was a fixed rounded rectangle that missed the loft, leaving a partial slot), the smoke
      collar (new) and the muzzle ring. COB strips Micah already has; no parts-list change.
B25. **Angled smoke holes, collar baffles, breech pucks** (Micah, 2026-11-12: "make them bigger and angle them
    towards the open end ... put silencer type air barbs on the inside"; "i don't have any aluminum stock. i can only
    machine in 2.5D ... an aluminum plug with a flange that's jbwelded in"; "the whole tube assembly should be able to
    slide in the gun core and screw into the solenoid").
    - **Smoke holes:** 3/8 in, 3 per barrel facing the other barrel, each leaning 40 deg from radial toward the
      muzzle, so the shot's air streams past them instead of ramming into them. Drill them after the barrel is
      screwed home (NPT stops wherever it's tight), so they face the other barrel.
    - **Smoke collar:** 42 mm long: the line's socket, a chamber with two cone baffles (plate + forward-pointing lip:
      smoke passes the lips, blast air coming back is caught in the pockets round them), then one 7 mm channel per
      hole. Simple check-valve-by-shape, nothing moving.
    - **Breech puck** (replaces the turned adapter): 2.5D from 1 in 6061 flat bar (1 x 4 x 8 in, Amazon, ~$30
      [UNVERIFIED]): a 3 in x 1/4 in flange and a 2.74 in x 3/4 in spigot JB Welded in the barrel, 1 in NPT tapped
      through. Barrel + puck slide into the core from the front (clear 3 in bore, +0.4 mm) and screw onto the valve
      nipple; the core halves just close round them. The core and plates did not move; the barrels sit 34 mm further
      back (muzzle too). It is downstream of the firing valve: it sees the shot's pulse like the barrel, never held
      pressure. Gun 18.7 kg, balanced; gun rebuild clean.
    - **Parts list:** $1,562.42 pre-tax (Order 1 $1,088.28 / $1,187.31 with tax, Order 2 $474.14).
B24. **Micah's Sheet notes, LED wiring, a bigger centred smoke line** (Micah, 2026-11-11/12: his notes on both order
    tabs; "add 3p wire for leds, and servo connectors"; "every led should be individually addressable, nothing in
    parallel"; "have it be all controlled from the one board, just group the panels"; "thermal just complicates
    wiring"; "go bigger ... make the holes oblong so it can squish ... it should run perfectly in the middle and the 3d
    print that spreads it should be cleaned up and have specific holes that match the ones you add to the polycarb.
    also fix the hollow section in the loft thing at the front of the cannon hub").
    - **Dropped:** the LED level shifter (330 ohm series resistors), the fluid level switch (the pump-time gauge
      stops the pump), the KSD301 cutout (the firmware cut at 245 C is the only heater limit: Micah's call), M4 x 6s
      (cut M4 x 8s), both rivnut rows (the underglow brackets are taped to the rails), the coupling nuts (the 112T
      ring's 6 posts are printed on, an insert in each), the pin headers (his).
    - **Owned now:** M4 nylocs, the 1x6 boards, the 3 mm silicone tube. **Cheaper / changed:** 30 cm panel USB-C,
      a TP4056 Type-C board for the remote (no boost), white 2 yd canvas ($24.99), one PETG bundle (he has 3 kg), one
      pack of dome rivets; both rivet rows in Order 1. **Checked and kept:** the G1/4 adapters, the brass crosses
      (the cheaper 5-pack is 150 psi), the 2-pack ball valve, the Hillman tee nuts (cheaper per piece, dearer in
      total).
    - **LED wiring:** 22 AWG 3-pin wire (100 ft) and 20 servo leads cut into pigtails; five data lines from the main
      controller: left panels, right panels (each panel its own plug in and out, chained), left frame, right frame,
      underglow. Every LED individually addressable; nothing shares a data line.
    - **Smoke line:** 3/4 in ID x 1 in OD silicone (Quickun, 240 C). In the gun it runs dead centre between the
      barrels (25 mm apart), drawn squished to a 30 x 20 mm oval, and every printed hole it passes is that oval plus
      0.6 mm; it crosses in front of the valves on edge and drops out of the core beside the chambers. The splitter's
      gun barb is 3/4 in. Some fog will always condense in the line: wide, short and no low sag is what helps.
    - **Smoke collar:** an oblong socket and a small plenum between the barrels; one 5 mm channel to each of 3 holes
      per barrel, facing the other barrel (straight at it and 35 deg either side). The old barrel holes were drawn
      20 mm long from the axis, so they never actually reached the wall; they go through now. No ring grooves.
    - **Gun core:** the mantlet loft is solid (was a shelled loft that read as a hollow). The core is 8 mm taller
      and its clamp screws are 4, over the top barrel and under the bottom one (the line has the middle).
      Gun 18.8 kg, still balanced on the pivot.
    - **Parts list:** $1,532.42 pre-tax (Order 1 $1,058.28, Order 2 $474.14).
B23. **CAD matches the parts list, pulley teeth, fog tube up high, show-off visuals, McMaster check** (Micah,
    2026-11-11: "make sure the CAD BOM and parts list match" -> "Yes, both" [model the missing modules, list the drive
    belts]; "add teeth to the pulley"; "the fog tube can move to run above stuff or above the wheels. add visuals ...
    suppressable via configuration. make them organic. make a fake floor too"; "confirm we don't need any mcmaster
    stuff and that switching it away saved money").
    - **Modules now modelled** on the bellypan, each on a printed tray where it stands off: ULN2803A relay driver,
      SN74AHCT125 level shifter, two 40 A fog relays (one per core), six valve MOSFET modules, five fog / light MOSFET
      modules with heat sinks, the MAX6675, the inline ATO fuse holder and three DS18B20 probes (electronics, battery
      bay, fogger). On the fogger: a KSD301 cutout on the core and the fluid level switch on the tank.
    - **Five quick disconnects** (M-style coupler + plug) in the tank lines, the main valve line and both service
      loops, each at the first clear spot along the tube's longest run (checked against every part and, for the
      service loops, the gun at 0-90 deg every 15); the tube is split there into "(supply)" and "(downstream)" parts.
      The service loops now rise to z 310 straight out of the in valves so their QDs sit below the chambers' swing.
    - **Pulley teeth:** the 112T ring and the 16T pinion have real HTD 5M grooves (`lib.htd_teeth`).
    - **Fog tube:** the rear run now climbs to z 235 behind the gun well and runs above the sled to the rear vent,
      instead of along the floor.
    - **Visuals** (new `visuals.py`, its own "Visuals" tab, never in the checks or the parts list): a gym floor,
      billowing smoke under the front and rear vents and at both muzzles, four rolled t-shirts in flight, aurora
      ribbons behind each window and a headlight cone. Built from overlapping spheres, lofted splines and sine ribbons
      so they read as organic. In Onshape each kind has a configuration switch.
    - **Parts list:** + HTD 5M 15 mm drive belt 140T x4 (D06, $35.60, for the CAD's 116T wheel pulley). $1,566.22 ->
      $1,601.82 pre-tax.
    - **McMaster:** nothing on the list is McMaster now and nothing needs to be. Every McMaster item in dee53b1 came to
      $309.25 with shipping; their Amazon / AliExpress equivalents are about $73.81, so about $235 saved overall. The
      one switch that cost more (rated Sch 80 1 in nipples, +$17.10, net about +$7 after the cheaper relief valves and
      bushings and no McMaster shipping) is under the $20 line, so it stays.
B22. **Tube drilling table, lower underglow on tape, axles inside the rail, 3/16 in bumper gap** (Micah, 2026-11-11:
    ".4in 2x [the 3M tape listing], add it to the list for the bottom leds. also add a bracket / also add the holes in
    the extrusions for CNCing it"; "the underglow LEDs need to go lower down and be at least level with the bottom of
    the bumper. also the bumper wood shouldn't need the holes for the bearings, the bearing should just be on the
    inside face of the extrusion"; "add tolerance between the bumper and chassis? i think 3/16ths on each side").
    - **Every tube hole is in the CAD and in one table:** each bracket rivet (dome and countersunk), the bearing bores,
      the axle end-screw access holes, the bumper #10-32s and their access holes, the underglow rivnuts and the
      frame-mount #10-32s are cut through the box tubes, and `docs/glacis/tube_drilling.csv` lists each hole by tube,
      face, distance along the tube from its -x/-y/-z end, offset from the face's centre line and diameter, for the
      CNC program (about 300 holes in 24 tubes).
    - **Axles:** the axle ends in the outer rail's bearing (bearing in the rail's inner wall). Its end screw and washer go
      in through a 14 mm hole in the rail's outer wall, which the bumper covers, so the bumper has no axle slots.
      Axles are 6-3/8 in.
    - **Underglow:** new printed bracket, the 45 deg face dropped 16 mm on a web from the rail so the strip's centre is
      2.6 mm under the bumper's bottom edge. The strip sticks on with the 3M tape (0.39 in, 2-pack). Each bracket screws
      up with M4 x 8s into M4 rivnuts in the rail's bottom wall (28; 1/16 in is too thin to tap), through the corner
      gussets where it steps down; the gussets have the matching holes (and lost a few rivets, 7 top and 5 bottom,
      to clear them).
    - **Bumper gap:** the ring sits 3/16 in off the outer rails and the end rails all round, on six printed 3/16 in
      spacers at the side screws. To stay 27.75 in wide (the 28 in door), the foam is cut 1-13/16 in deep instead of 2 in.
    - **Parts list:** + 3M tape $15.99 (L05), + M4 rivnuts 50 pcs $5.49 (B20, grip range for 1/16 in unverified),
      M4 x 8 button heads 1 -> 2 packs (+$6.74). $1,538.00 -> $1,566.22 pre-tax.
B21. **Electronics on the bellypan, breaker at the rear panel, part numbers** (Micah, 2026-11-11: "try to put all the
    electronics on the bottom plate which can also be cnc'ed. make sure the breaker switch thing is accessible or are
    we just using the E-stop to turn on and off the bot?"; then "give every single part a number or code that
    corresponds to something on the list ... Acr ... ASh ... ATu ... AEx ... 3DP ... a pneumatic valve could be P24";
    "things like standoffs we can 3d print"; rows 56 and 57 "i don't think we have either of those"; "move the audio
    to the second parts order").
    - **On / off:** the 120 A main breaker is the switch. It moved from the bellypan (behind the bumpers, reachable
      only with the body open) to the rear panel's bottom strip beside the E-stop, its face parallel to the slanted
      panel 4 mm behind it, the trip button and reset lever through a 42 mm hole in the acrylic. The E-stop stays a
      stop, not a switch: it drops the contactor and the logic rail stays up (rev C.3 by design).
    - **Bellypan:** one piece on the CNC router (768 x 259 mm), the printed shelf gone. Each shelf part's spot was
      searched for clear of every other solid (the pneumatics over the rear bay, the fog tube and vents, the inboard
      plates): controller, Spark MAX, safety node and PCA9685 in the rear bay, both ADCs and the valve relay in the
      middle, the drivers board, LED buck and logic supply ahead of the boost. Every footprint is engraved (layer MARK)
      so its holes are drilled to the real part; no hole patterns were guessed.
    - **Board trays (3DP):** one under each board, 6 mm posts with pegs a soldering iron mushrooms over the board's
      holes, 2 x M4 x 12 up through the bellypan into inserts. Replaces the nylon standoff kit before it was bought.
    - **Codes:** every list row has one (bom/glacis_bom_codes.json, column A of the Sheet), kept fixed once given. A
      bought or owned part is its system letter and number (P pneumatics + gun, D drive, E elevation, C controls +
      power, S sound, F fog, B body + fasteners, R rails, L lights): the firing valves are P23-1 and P23-2. A made part
      is material + system + number: 3DP-B014, ASh-D02, ATu-D05, AEx-R03, ABr-P01, Acr-B04. `cad/glacis/partcodes.py`
      writes out/part_codes.json / .csv; every Onshape part's Part number is set from it. W = the deferred printed
      wheels' belts and rods (not on the list).
    - **List:** the main ball valve (2-pack, $15.99) and the 1-1/2 in nipple (2-pack, $7.49) are buys now; the M5
      standoffs under the fog heater stay metal (240 C) and go on the list as stash; audio moved to Order 2.
    Checks: full robot.py (interference: only the old 64 mm3 fill-elbow sliver; sweep 0-90 deg 0 clashes; prints fit;
    0 multi-piece), then the trays added and the power tab re-checked against everything and the gun swing: 0 hits.

B20. **Flat waterjet brackets, riveted, tied together** (Micah, 2026-11-11: "add all the brackets, everything can be
    waterjet from 1/8in or 1/16th aluminum. try to avoid bends because they throw off the holes and we plan to cnc the
    extrusions ... be metal efficient and feel free to style stuff. try to keep brackets under 12x12"; then "tie the
    motor mounts into the tank posts and stuff. make it interconnected. include the threaded rivets if/where you use
    them please but no need for screws").
    - **New module** `cad/glacis/brackets.py`: every bracket is 2D data (outline, isogrid pockets, holes) that makes
      the solid, the DXF and the nest. Each rivet hole is checked for its head (dropped if it would hit a part) and
      cut through the near wall of the tube under it, so the CNC program for every extrusion comes from the model.
    - **Side plates** (4, replace the drive plates): the Falcon and axle plate grown along the inner rail's outboard
      face into every post on its stretch. Rear: both sled posts, the tower and the rear tank post; front: the front
      tank post. Isogrid pockets, countersunk rivets (the wheel runs right beside them). 290 x 146 and 210 x 146 mm.
    - **Inboard plates** (6) on the rail's inner face round the same posts, clear of the Falcon bodies; the rear one
      stays low (the valve cross, line relief and in valve A sit just above the rail on the left).
    - **Arm knees** (14): an L on both faces of every post-to-arm joint (sled rails, tank arms) in place of the old
      flat top gussets; the -320 sled joint gets one short knee on its front face only (the rear manifold is right
      behind the post). The tank saddles step down onto the arms where the old gusset was.
    - **Tower plates** flat (no bent flanges), 293 mm, plus a flat spacer strip for the rest of the in-well rail; the
      bent tower base gussets are gone (the side and inboard plates hold the tower's foot).
    - **Corner gussets** as before, now drilled (the bottom ones countersunk: the underglow bracket runs right under).
    - **Bellypan** in 3 pieces (284, 240, 244 x 259 mm) with a strap under each seam.
    - Everything is 1/8 in (the only 1/16 part was a seam strap, which would have wasted a sheet): 41 parts, 15
      different, the biggest 293 mm; they nest on 11 sheets of 12 x 12 in (about 75% of each sheet inside part
      outlines; the bellypan takes 3 sheets on its own). 3/16 blind rivets: 166 dome, 118 countersunk (120 deg).
      No threaded rivets: nothing that has to come off screws into a tube.
    - Not bracketed: the gun cradle plates (490 x 226 mm) are bigger than the 12 x 12 bed, so they go on the CNC
      router (Micah: "ill use a cnc").
    Checks: full robot.py (interference 2 pairs: the old 64 mm3 fill-elbow sliver and a 475 mm3 tank line through the
    lowered tank saddle, then fixed and re-checked alone: 0; sweep 0-90 deg 0 clashes; prints fit; 0 multi-piece;
    brackets vs every part 0 hits).

B19. **Review pass: every plate hole backed, one gun core (left / right), side screws, electronics shelf, parts list**
    (Micah, 2026-11-10: "review the holes in it probably combining the manifold and breech blocks into one piece. review
    all the cannon parts and make sure they all go together well. then review the whole design and make sure its good.
    then review the parts list one more time and update the artifact and sidenote"; answers: combine all three, the
    holes are "the screw holes that don't have anything behind them, they should be moved").
    - **Holes:** the six 6.6 mm tie holes had nothing behind them and are gone. Every hole in both plates now lands on an
      insert, nyloc, T-nut or standoff (21 left, 23 right, all 4.5 mm for M4, plus the hex): 8 into the saddles, 4 into
      the chamber caps and 6 into the gun core per side (M4 x 8 into M4 x 4 inserts), 3 into the rail's T-nuts, the
      hub's 4 or the ring's 6. The chevrons were re-phased so every screw sits in a solid web. 704 g per plate.
    - **Gun core:** the valve side blocks, breech block and mantlet are one printed part split LEFT / RIGHT on the plane
      through both barrel axes. Micah's pick said top / bottom, but a top / bottom split leaves each half a closed ring
      round its barrel that can only slide on, not clamp; left / right halves close from the sides and 2 x M4 x 12
      across the split clamp both barrels onto their spigots. 243 x 198 x 74 mm and about 0.5 kg each, printed outer
      face down.
    - **Caps and saddles** screw in from the sides through the plates (the old vertical cap screws sat under the add-on
      rail). Left hub flange 3 mm (4 mm left an M4 x 12 too short for a nyloc); the ring's standoff screws are
      counterbored so the M4 x 8 and M4 x 12 don't meet inside the 10 mm coupling nut. Pivot stubs tapped 1/4-20 both
      ends with a bolt and washer each side.
    - **Electronics shelf** now matches the rev D.2.1 parts: Waveshare ESP32-P4-Module-DEV-KIT (88 x 56 x 18), a PCA9685
      where the music board was, both ADS1115s, a battery relay each side of the bellypan, the amp 40 mm forward, the
      1200 W boost (130 x 55 x 55, [UNVERIFIED] size). Stale CAD labels (McMaster relief, Lnrueg plug, FUSCH
      transducer, Sch 40 nipple) refreshed.
    - **Parts list:** PETG 1 -> 2 spools (the prints come to about 6.5 kg), M4 inserts 1 -> 2 packs, the logic supply
      row got its link (3.6-32 V buck-boost, $2.67), new $0 rows for the gun plates, breech-adapter bar, printed gun parts
      and aluminium stock, the drive rows get their own section, two stale notes corrected. $1,525.57 pre-tax.
    Checks: full robot.py (interference 1 pair, the old 64 mm3 fill-elbow sliver; sweep 0-90 deg 0 clashes; 0
    multi-piece; 50 frame pieces; all rail and speaker screws found; gun 18.5 kg, CG 1 mm ahead). The bed check flagged
    the two core halves at 254 x 198 x 83: it measured them tilted to the 20 deg display pose; robot.py now measures gun
    parts level (243 x 198 x 74, fits). The new shelf parts, rebuilt alone and swapped into the power STEP: 0 hits over
    30 mm3 against every other part and the gun over 0-90 deg.

B18. **Gun restyle: chevron + turret-wheel plates, cannons 30% closer, V rear holder, printed end covers** (Micah, same
    day, after 15 side-plate concepts (claude.ai artifact "Borealis Side Plates"): "combine chevron and turret wheel.
    make the wheel chevrons", then "just 1 set in the ring", "shorten the back ... leave the chambers where they are",
    "go 3 and 3", "push the chamber holder thing up ... to align it with the indent on the back ... make it match the
    profile"; earlier: "the turret hub needs to be cleaned up. fix these holes. lighten the sideplates and make them
    look cool. also make the chamber caps 3d printed and better. make the back more interesting. make the top and
    bottom profiles more dynamic. also put the cannons 30% closer together").
    - **Cannons:** GUN_GAP 35.8 -> 25.1 mm (read as the gap shrinking 30%; a 30% cut to the axis-to-axis spacing would
      overlap the 3 in chambers). Axes 101 mm apart (was 112), chambers 12 mm apart, the gun 11 mm shorter top to
      bottom. The old 35.8 came from two 3 x 1 reducing couplings side by side, gone since the chambers are welded.
    - **Plates** (new `plates.py`): the Chevron concept's swallowtail back and pointed nose, plus the turret wheel's
      round boss (r = plate half-height + 6) breaking the top and bottom edges round the pivot. Pockets: 3 forward
      chevrons behind the hub, 3 ahead of it, an X of 4 outward chevrons round the hub between the ring's standoffs;
      6 mm webs, 4 mm corner rounds, a 10 mm rim, solid at the pivot boss, the ring's standoff pads, the breech block,
      the top rail, the valve-block pads, the tie bolts and the saddle screws (the chevrons may be broken by those
      pads). The back is shorter: it ends 4 mm behind the rear saddle line (was 30), the chambers unchanged. 717 g each
      (was 846).
    - **Rear chamber holder:** the rear saddle and its two caps are now V-shaped, a 24 mm band 4 mm in from the plates'
      swallowtail edge, so they line up with the indent. Front saddle stays straight.
    - **Chamber caps** (both stations): solid blocks that fill out to the plates (stepping in under the add-on rail on
      top), so there are no open corners round the pipes (the holes in Micah's screenshot); 2 x M4 x 12 down through
      counterbores into inserts in the saddle. The saddles now also screw to the plates: 2 x M4 x 8 per saddle per side
      into inserts in their sides (the plates had no saddle screws before).
    - **End covers:** a printed sleeve over each chamber's welded back end with an octagonal faceted nose and an LED
      groove, held with RTV; cosmetic, the steel disc is the pressure boundary.
    - **Left hub:** a slim flanged hub (4 mm flange on the plate, 44 mm barrel to the inner bearing, the inner-race
      lip, 4 x M4 x 12 into nylocs) instead of the 72 mm block; the plate's turret boss is the visual hub now.
    - **Gun rails** 300 -> 276 mm (the plate starts later).
    Checks: full robot.py (on the 7-chevron version: interference 1 pair, the 64 mm3 fill elbow sliver; sweep 0-90 deg
    0 clashes; all prints on the bed; 0 multi-piece; the gun well floor re-cut, 261 under the axle; 50 frame pieces,
    58 tenons; all rail and speaker screws found), then the final gun rebuilt and swapped into those STEPs: the gun vs
    everything over 0-90 deg every 5 and the rebuilt chassis parts vs everything, 0 hits over 30 mm3; no clashes
    inside the gun; every print fits the bed; gun 18.5 kg, balanced.
D14 (Borealis). **Money:** $2,002.43 before the review -> $1,777.71, then $1,600.79 after Micah's Sheet changes
    (welded chambers, the M-style QD kit, M4 hardware, cheaper transducers and boost; Order 1 $1,082.69 + $10 shipping,
    Order 2 $508.10), then $1,584.06 with the GOGO in valves (Order 1 $1,065.96 + $10). The MSI vs Supply Giant coupling
    question is moot: the chambers are welded.
Not changed (already on main): two pneumatic fitting slivers in the interference check (valve cross / 200 psi relief
146 mm3, fill elbow / rear manifold 64 mm3), from rev D.2.
