ElMagoCT/brophy-tshirt-cannon/cad/glacis/out/clip_check.png

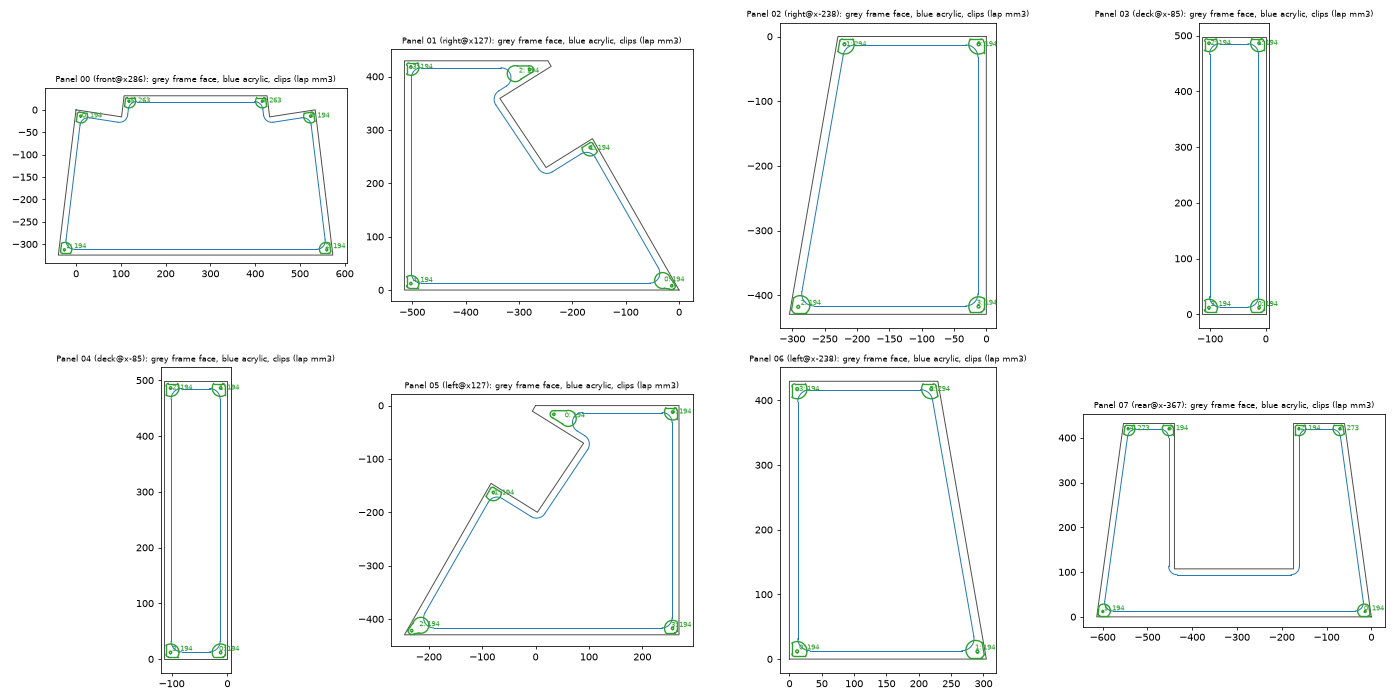
cad/glacis/out/clip_check.png
