ElMagoCT/brophy-tshirt-cannon/cad/glacis/out/glacis_gun.png

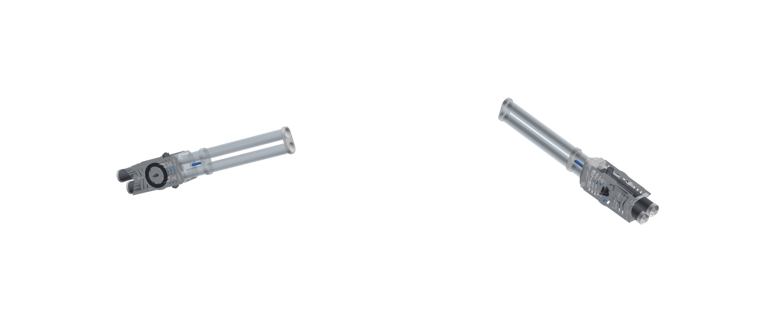
cad/glacis/out/glacis_gun.png
