ElMagoCT/brophy-tshirt-cannon/cad/glacis/out/glacis_inside.png

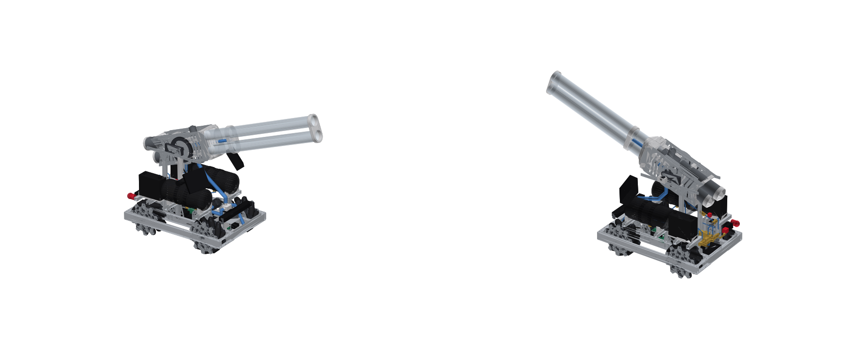
cad/glacis/out/glacis_inside.png
