ElMagoCT/brophy-tshirt-cannon/docs/concepts/renders/01-spectre.jpg

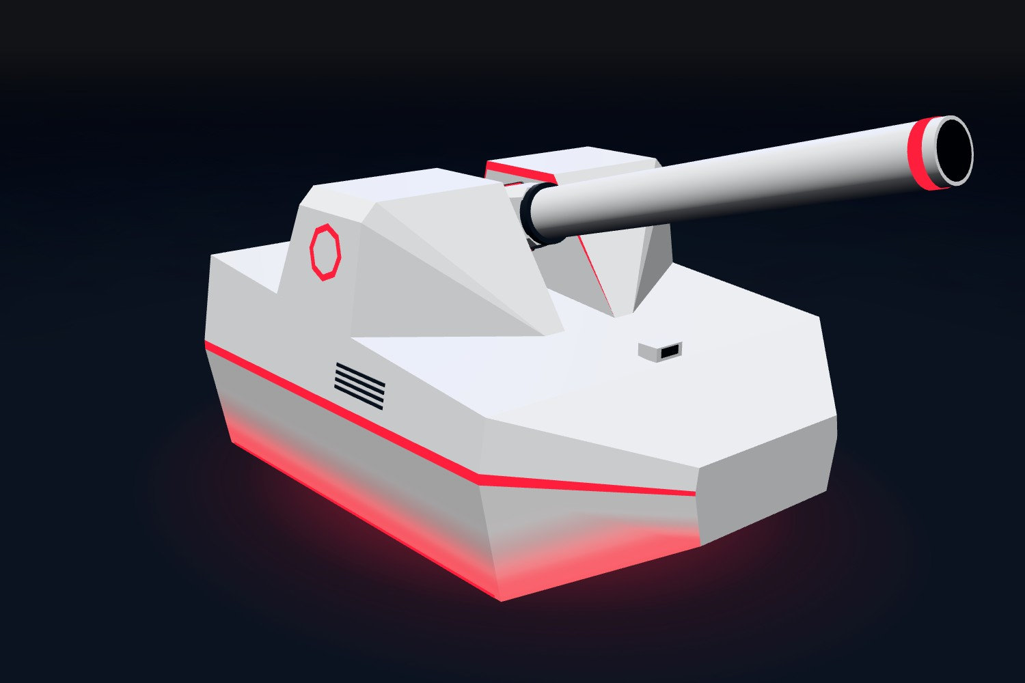
docs/concepts/renders/01-spectre.jpg
