ElMagoCT/brophy-tshirt-cannon/docs/concepts/renders/03-raptor.jpg

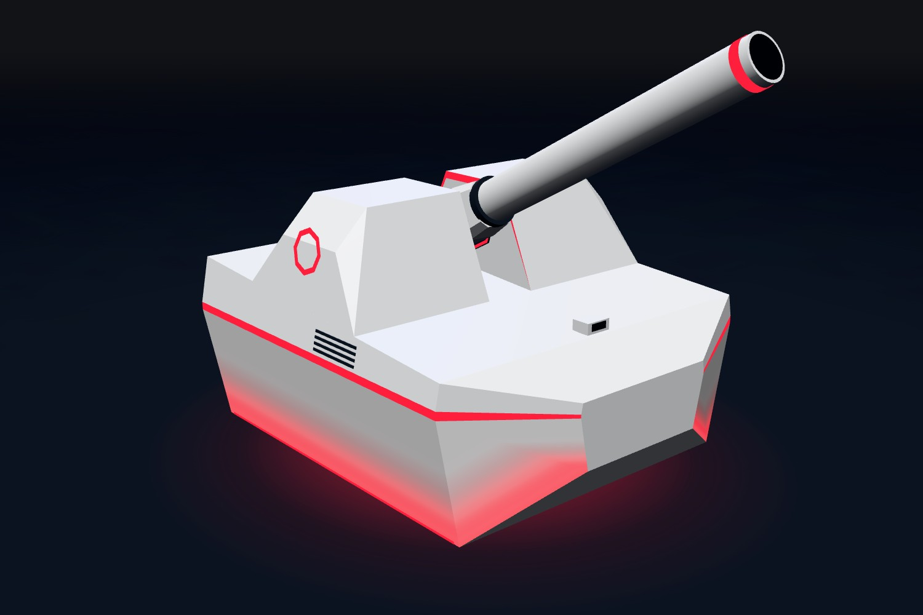
docs/concepts/renders/03-raptor.jpg
