ElMagoCT/brophy-tshirt-cannon/docs/concepts/renders/04-doorstop.jpg

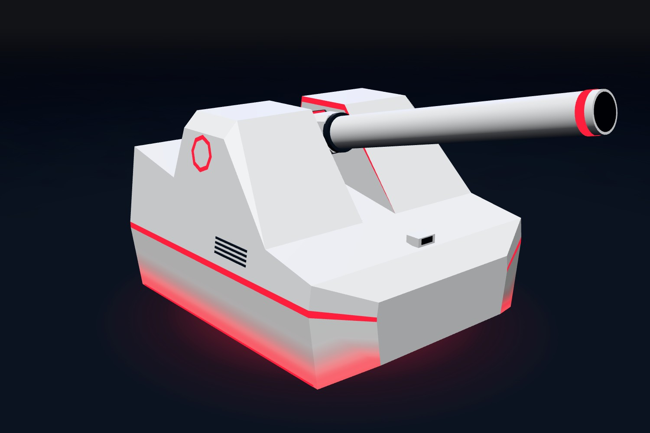
docs/concepts/renders/04-doorstop.jpg
