ElMagoCT/brophy-tshirt-cannon/docs/concepts/renders/05-citadel.jpg

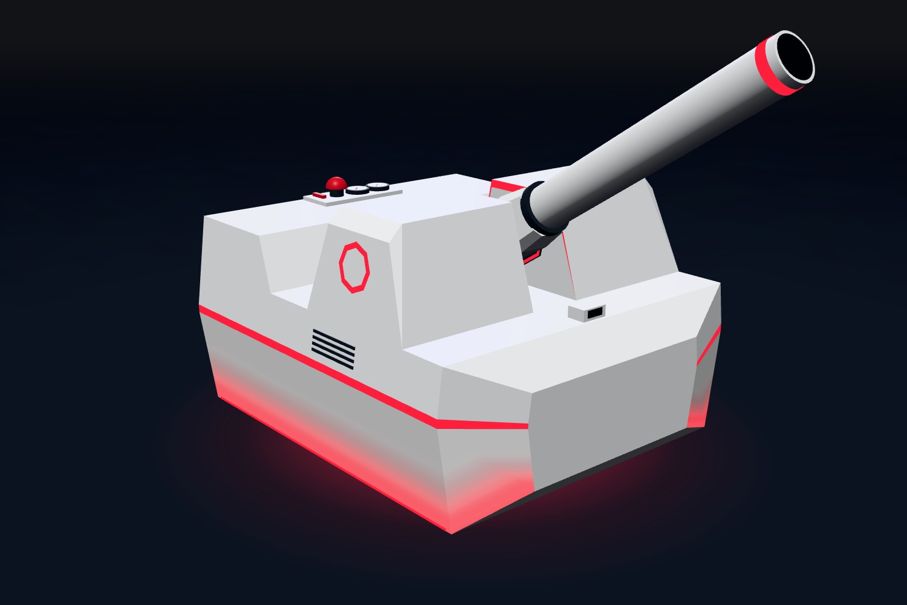
docs/concepts/renders/05-citadel.jpg
