ElMagoCT/brophy-tshirt-cannon/docs/concepts/renders/06-phantom.jpg

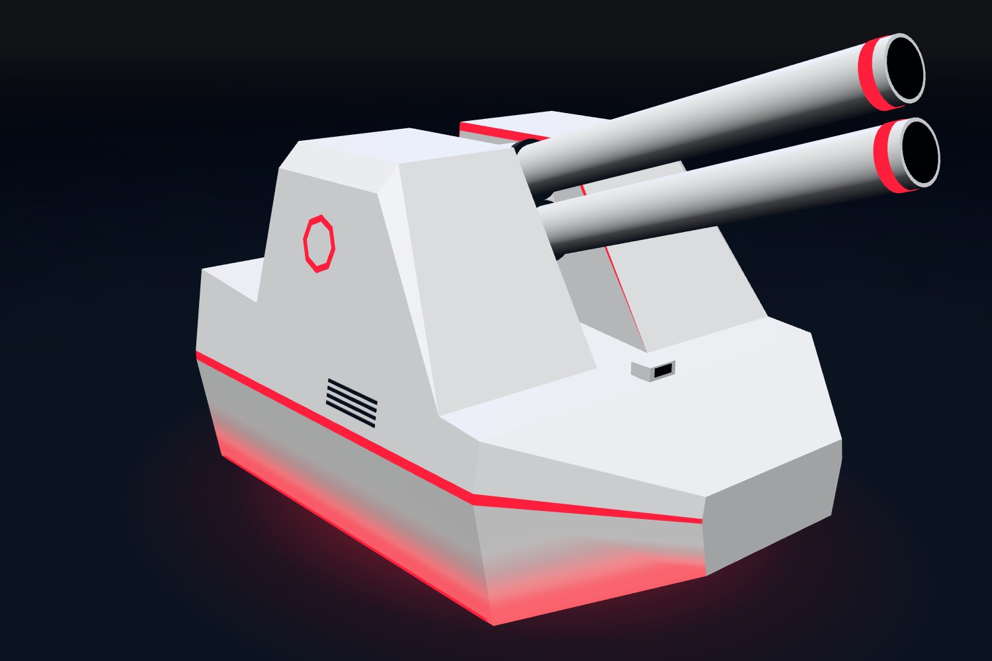
docs/concepts/renders/06-phantom.jpg
