ElMagoCT/brophy-tshirt-cannon/docs/concepts/renders/07-slab.jpg

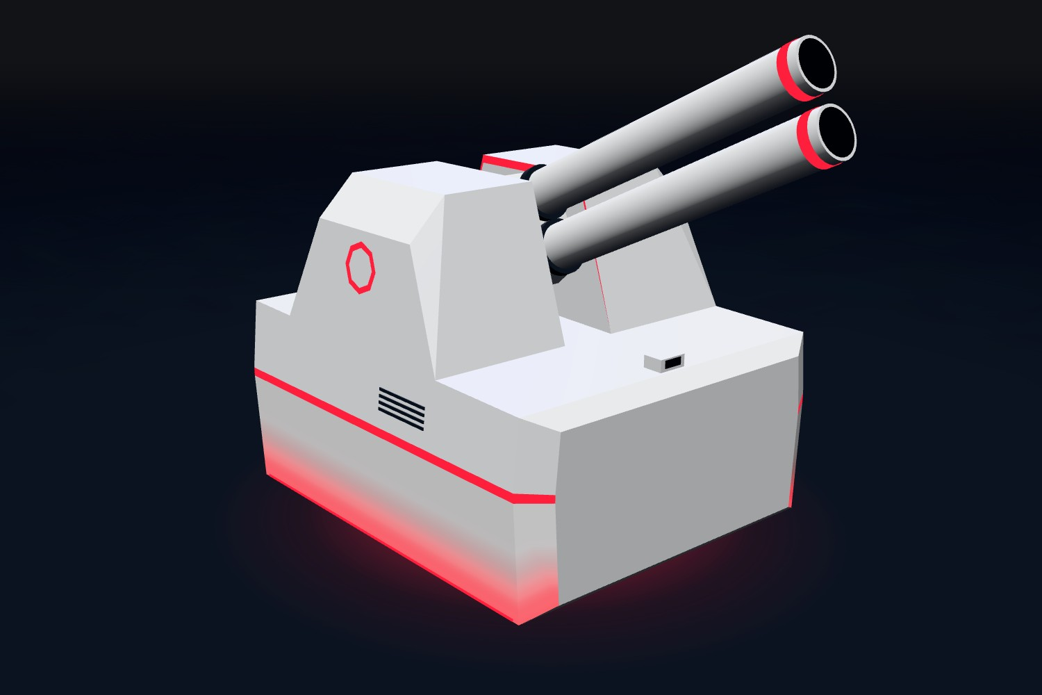
docs/concepts/renders/07-slab.jpg
