ElMagoCT/brophy-tshirt-cannon/docs/concepts/renders/10-keep.jpg

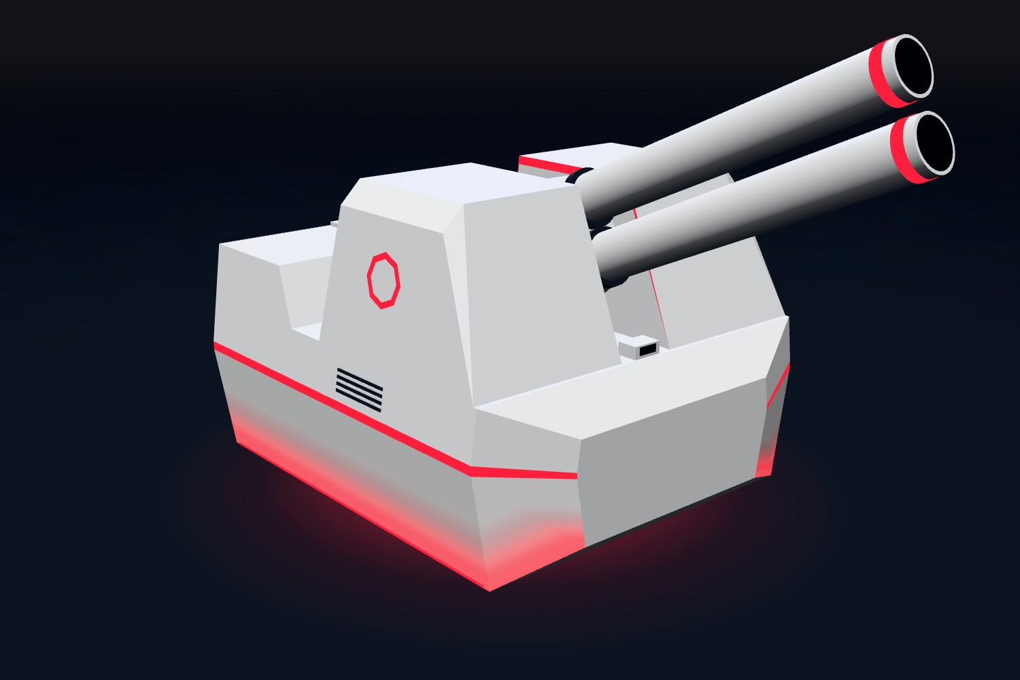
docs/concepts/renders/10-keep.jpg
