ElMagoCT/brophy-tshirt-cannon/docs/concepts/renders/11-wraith.jpg

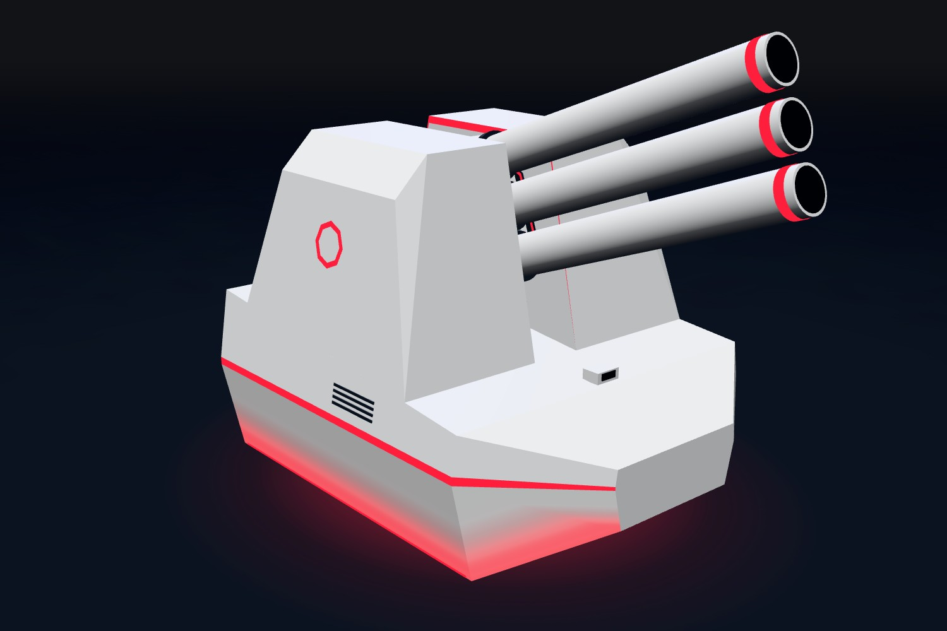
docs/concepts/renders/11-wraith.jpg
