ElMagoCT/brophy-tshirt-cannon/docs/concepts/renders/13-harrier.jpg

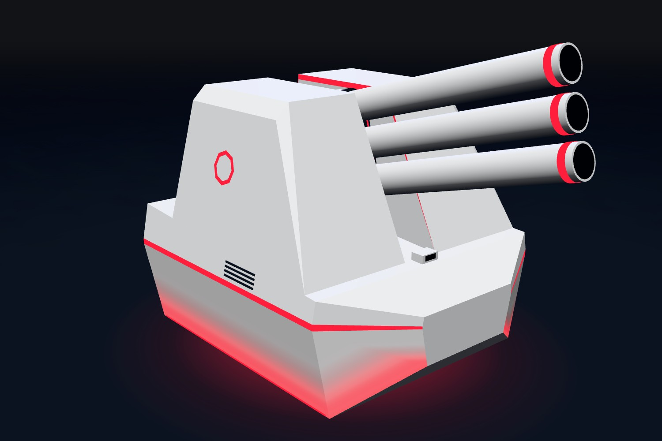
docs/concepts/renders/13-harrier.jpg
