ElMagoCT/brophy-tshirt-cannon/docs/concepts/renders/15-rampart.jpg

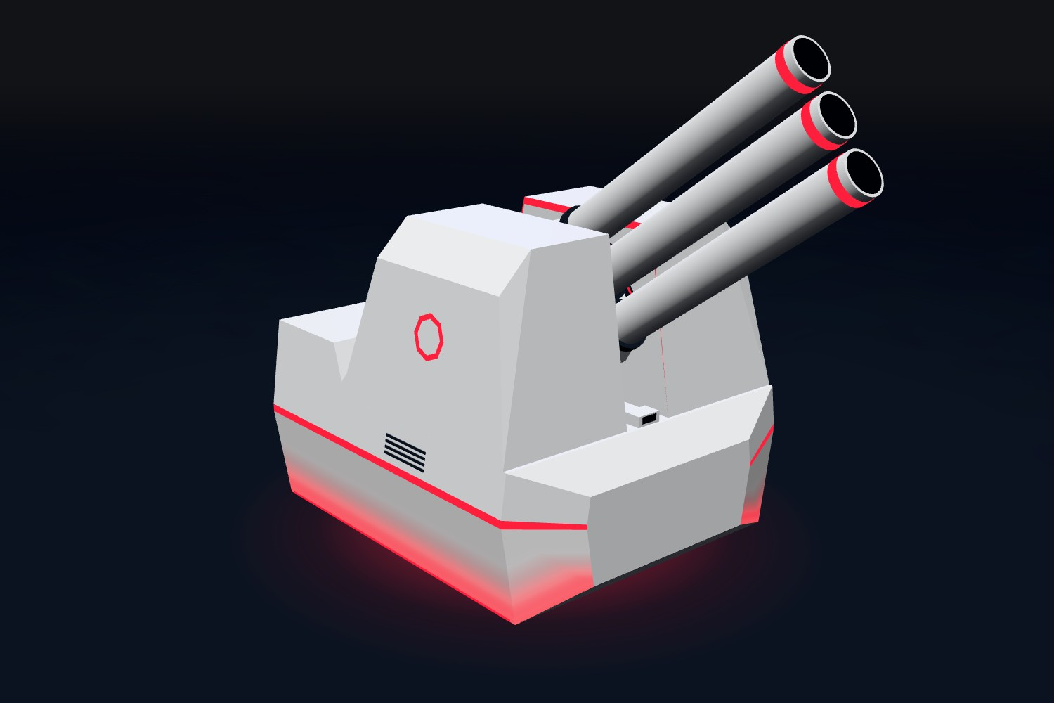
docs/concepts/renders/15-rampart.jpg
