ElMagoCT/brophy-tshirt-cannon/docs/concepts/renders/16-revenant.jpg

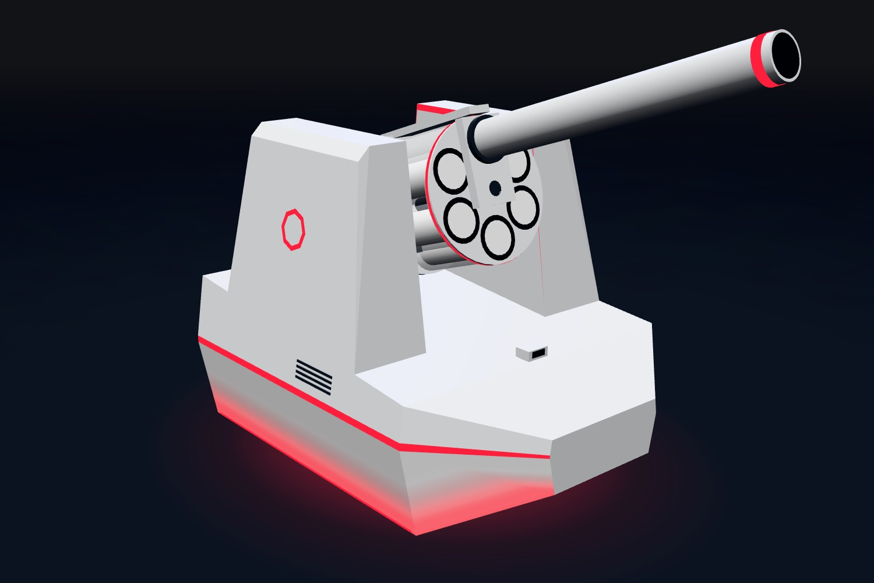
docs/concepts/renders/16-revenant.jpg
