ElMagoCT/brophy-tshirt-cannon/docs/concepts/renders/18-kestrel.jpg

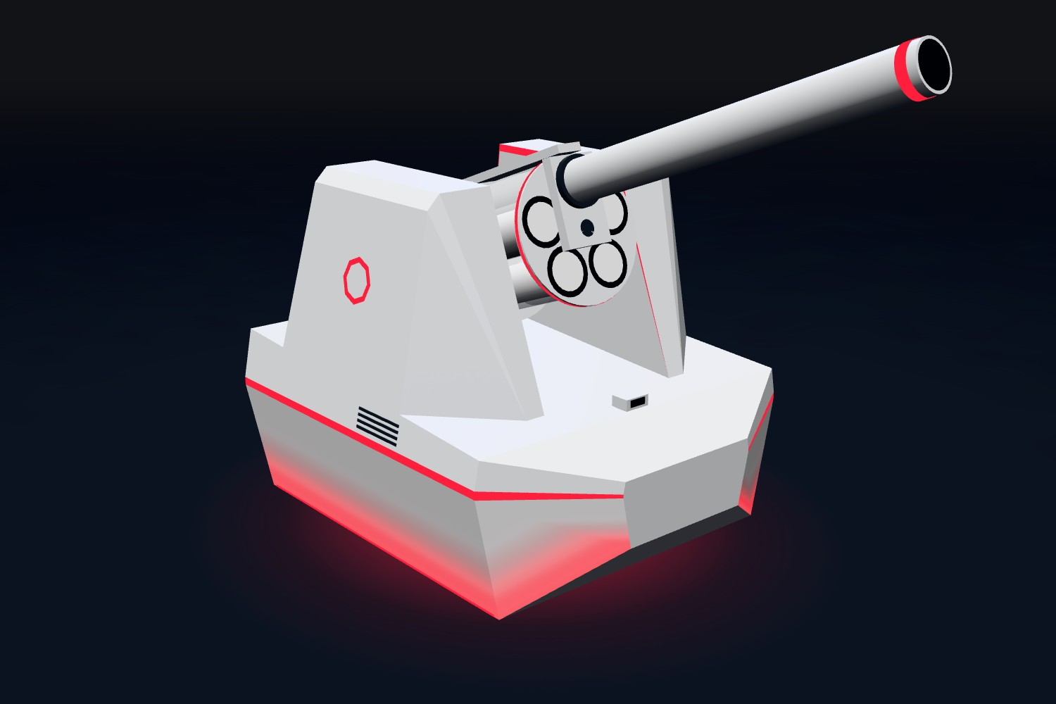
docs/concepts/renders/18-kestrel.jpg
