ElMagoCT/brophy-tshirt-cannon/docs/concepts/renders/19-incline.jpg

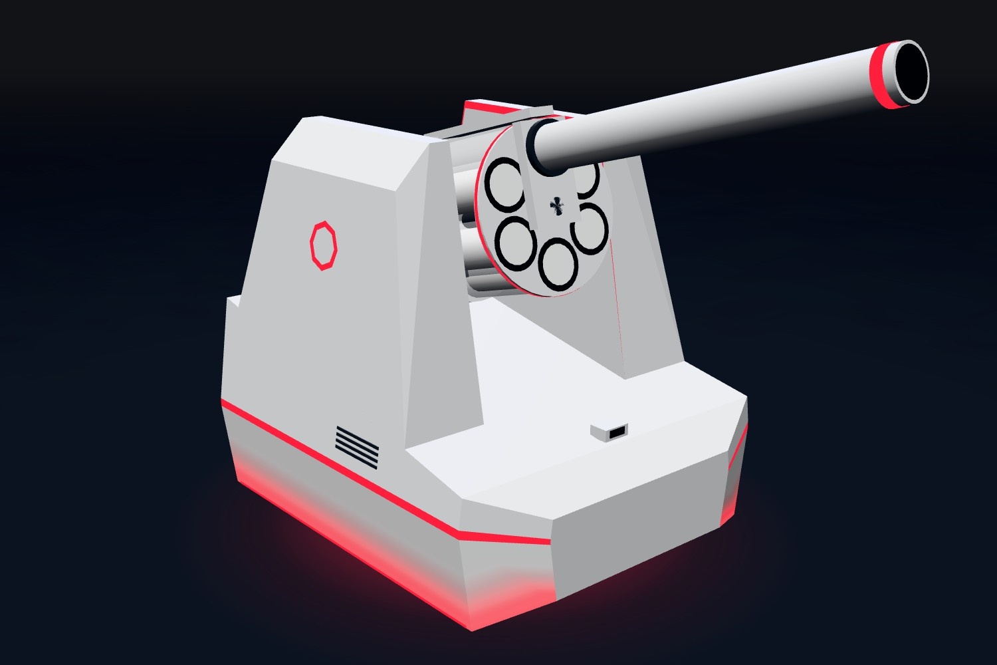
docs/concepts/renders/19-incline.jpg
