ElMagoCT/brophy-tshirt-cannon/docs/concepts/renders/20-bulwark.jpg

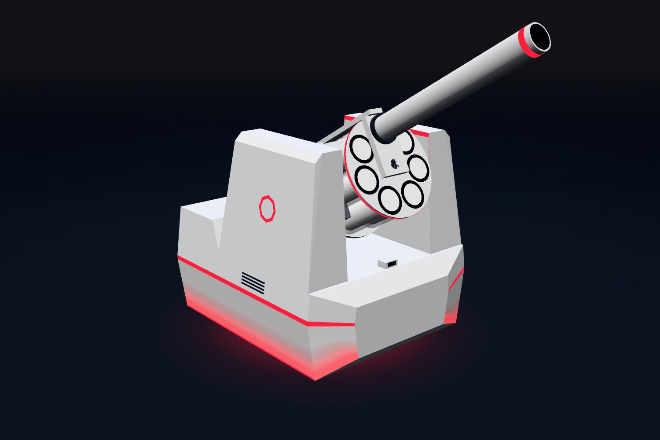
docs/concepts/renders/20-bulwark.jpg
