ElMagoCT/brophy-tshirt-cannon/docs/concepts/renders/contact-sheet-xray.jpg

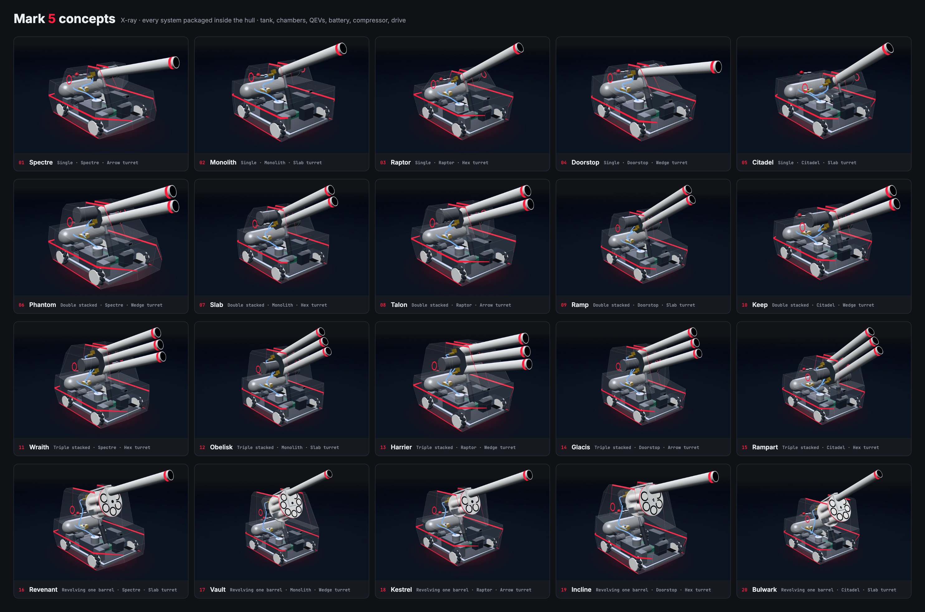
docs/concepts/renders/contact-sheet-xray.jpg
