ElMagoCT/brophy-tshirt-cannon/docs/concepts/renders/contact-sheet.jpg

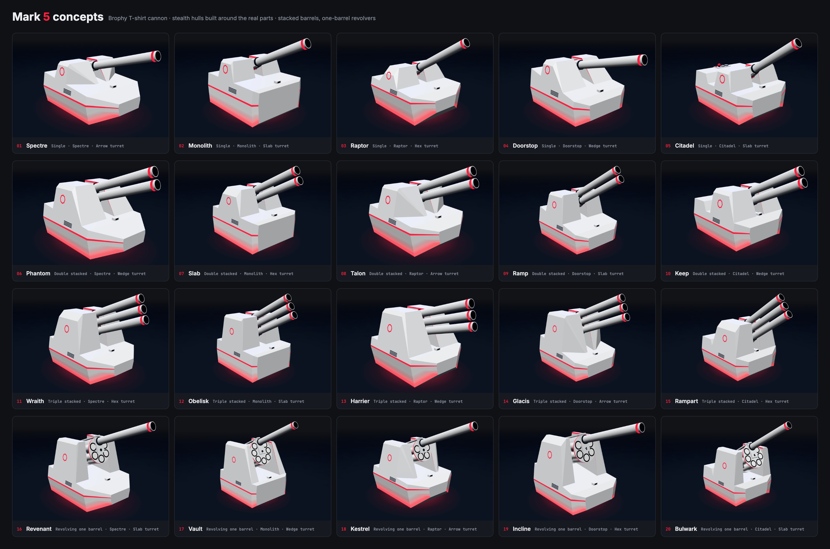
docs/concepts/renders/contact-sheet.jpg
