ElMagoCT/brophy-tshirt-cannon/docs/glacis/glacis_inside.png

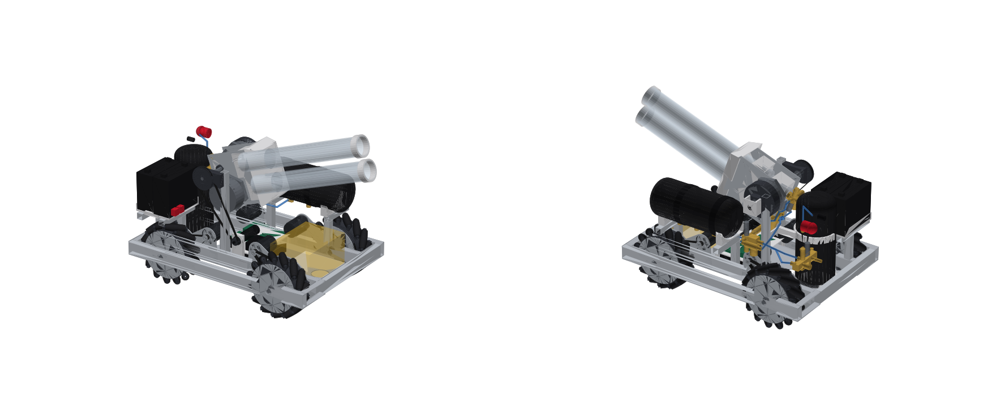
docs/glacis/glacis_inside.png
