ElMagoCT/brophy-tshirt-cannon/docs/glacis/img/aignep.jpg

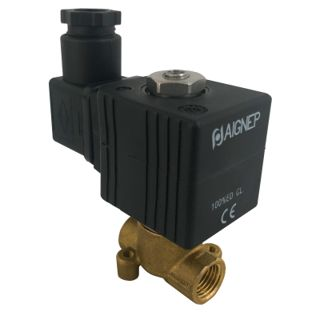
docs/glacis/img/aignep.jpg
