ElMagoCT/brophy-tshirt-cannon/docs/glacis/img/bushing_ss.jpg

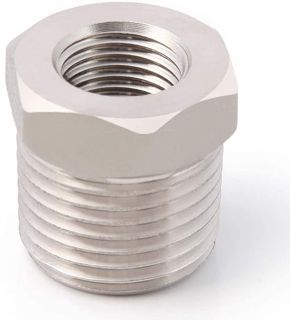
docs/glacis/img/bushing_ss.jpg
