ElMagoCT/brophy-tshirt-cannon/docs/glacis/img/check_mm.jpg

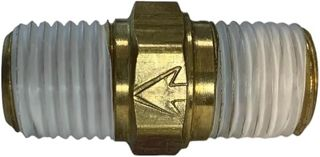
docs/glacis/img/check_mm.jpg
