ElMagoCT/brophy-tshirt-cannon/docs/glacis/img/close_nipple.jpg

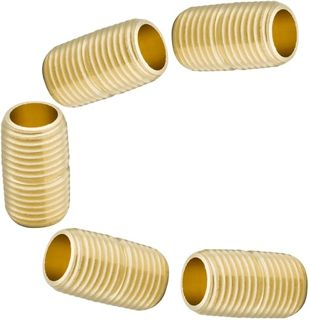
docs/glacis/img/close_nipple.jpg
