ElMagoCT/brophy-tshirt-cannon/docs/glacis/img/contactor.jpg

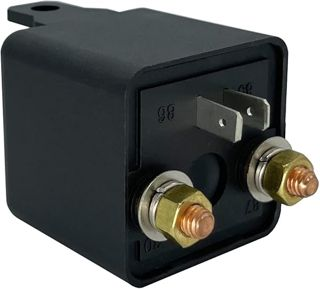
docs/glacis/img/contactor.jpg
