ElMagoCT/brophy-tshirt-cannon/docs/glacis/img/cross.jpg

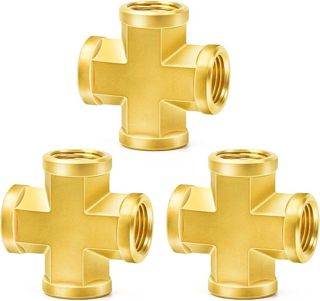
docs/glacis/img/cross.jpg
