ElMagoCT/brophy-tshirt-cannon/docs/glacis/img/dot_tube.jpg

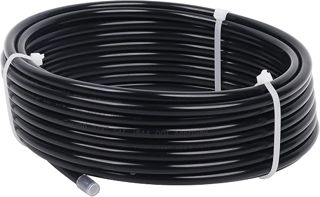
docs/glacis/img/dot_tube.jpg
