ElMagoCT/brophy-tshirt-cannon/docs/glacis/img/elbow_ff.jpg

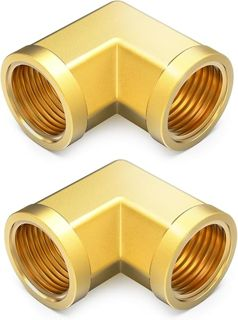
docs/glacis/img/elbow_ff.jpg
