ElMagoCT/brophy-tshirt-cannon/docs/glacis/img/foam.jpg

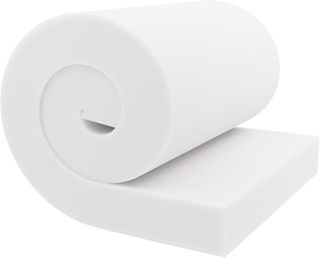
docs/glacis/img/foam.jpg
