ElMagoCT/brophy-tshirt-cannon/docs/glacis/img/fog_fluid.jpg

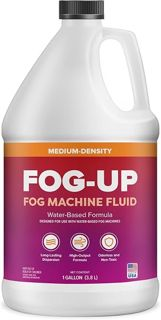
docs/glacis/img/fog_fluid.jpg
