ElMagoCT/brophy-tshirt-cannon/docs/glacis/img/hex_plug.jpg

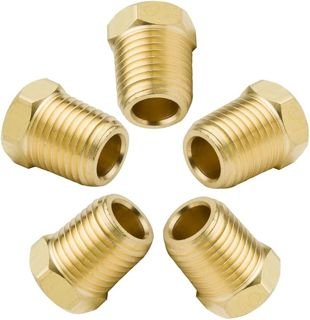
docs/glacis/img/hex_plug.jpg
