ElMagoCT/brophy-tshirt-cannon/docs/glacis/img/hsv04.jpg

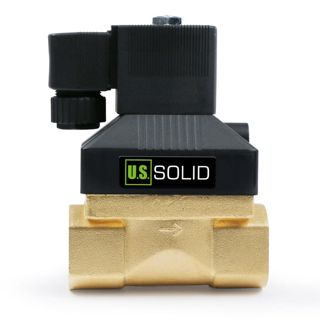
docs/glacis/img/hsv04.jpg
