ElMagoCT/brophy-tshirt-cannon/docs/glacis/img/mosfet.jpg

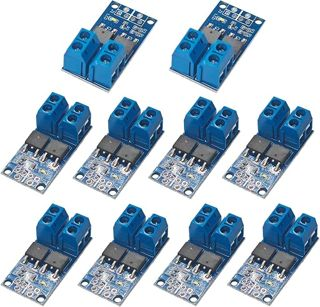
docs/glacis/img/mosfet.jpg
