ElMagoCT/brophy-tshirt-cannon/docs/glacis/img/nipple_3in.jpg

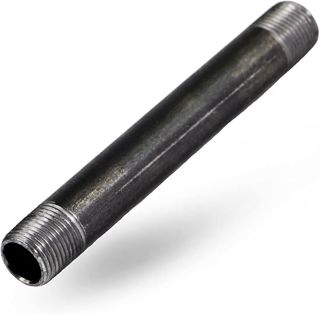
docs/glacis/img/nipple_3in.jpg
