ElMagoCT/brophy-tshirt-cannon/docs/glacis/img/p4c5.jpg

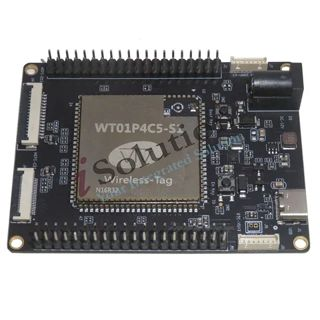
docs/glacis/img/p4c5.jpg
