ElMagoCT/brophy-tshirt-cannon/docs/glacis/img/plug_f.jpg

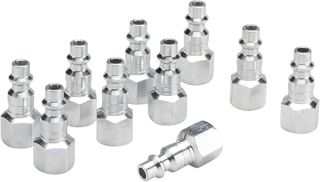
docs/glacis/img/plug_f.jpg
