ElMagoCT/brophy-tshirt-cannon/docs/glacis/img/ptc_elbow.jpg

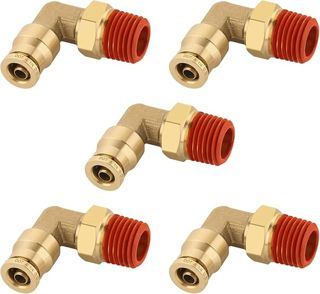
docs/glacis/img/ptc_elbow.jpg
