ElMagoCT/brophy-tshirt-cannon/docs/glacis/img/red_coupling.jpg

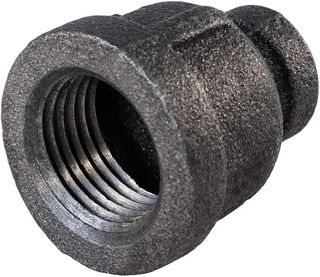
docs/glacis/img/red_coupling.jpg
