ElMagoCT/brophy-tshirt-cannon/docs/glacis/img/sealant.jpg

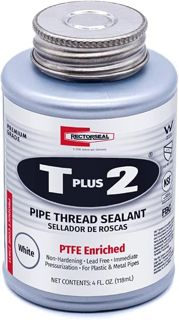
docs/glacis/img/sealant.jpg
