ElMagoCT/brophy-tshirt-cannon/docs/glacis/img/speaker.jpg

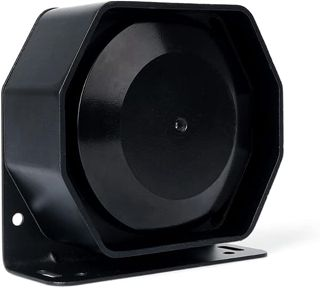
docs/glacis/img/speaker.jpg
