ElMagoCT/brophy-tshirt-cannon/docs/glacis/img/street_elbow.jpg

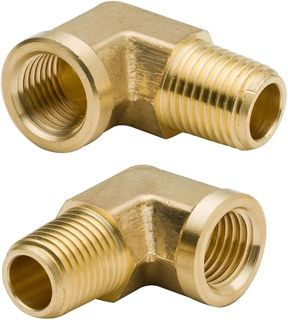
docs/glacis/img/street_elbow.jpg
