ElMagoCT/brophy-tshirt-cannon/docs/glacis/img/szw25.jpg

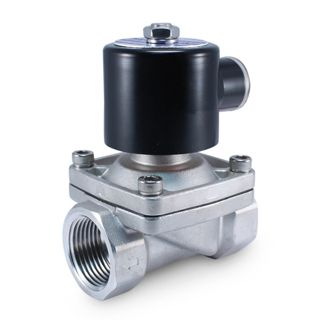
docs/glacis/img/szw25.jpg
