ElMagoCT/brophy-tshirt-cannon/docs/glacis/img/tank.jpg

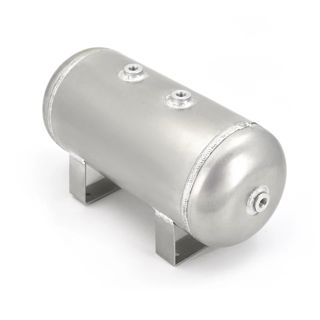
docs/glacis/img/tank.jpg
