ElMagoCT/brophy-tshirt-cannon/docs/glacis/img/tank_port.jpg

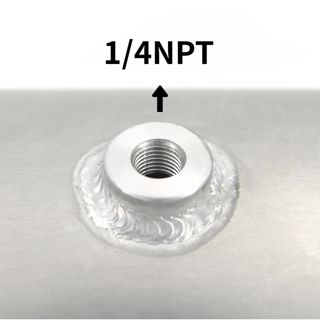
docs/glacis/img/tank_port.jpg
