ElMagoCT/brophy-tshirt-cannon/docs/glacis/img/tnut.jpg

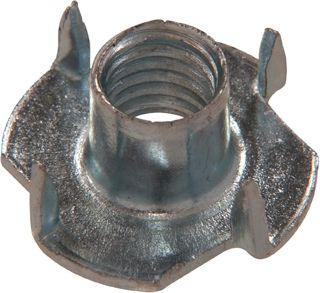
docs/glacis/img/tnut.jpg
