ElMagoCT/brophy-tshirt-cannon/docs/glacis/img/transducer.jpg

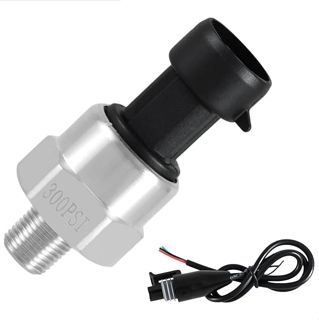
docs/glacis/img/transducer.jpg
