ElMagoCT/brophy-tshirt-cannon/docs/glacis/led_sections_d1_2.png

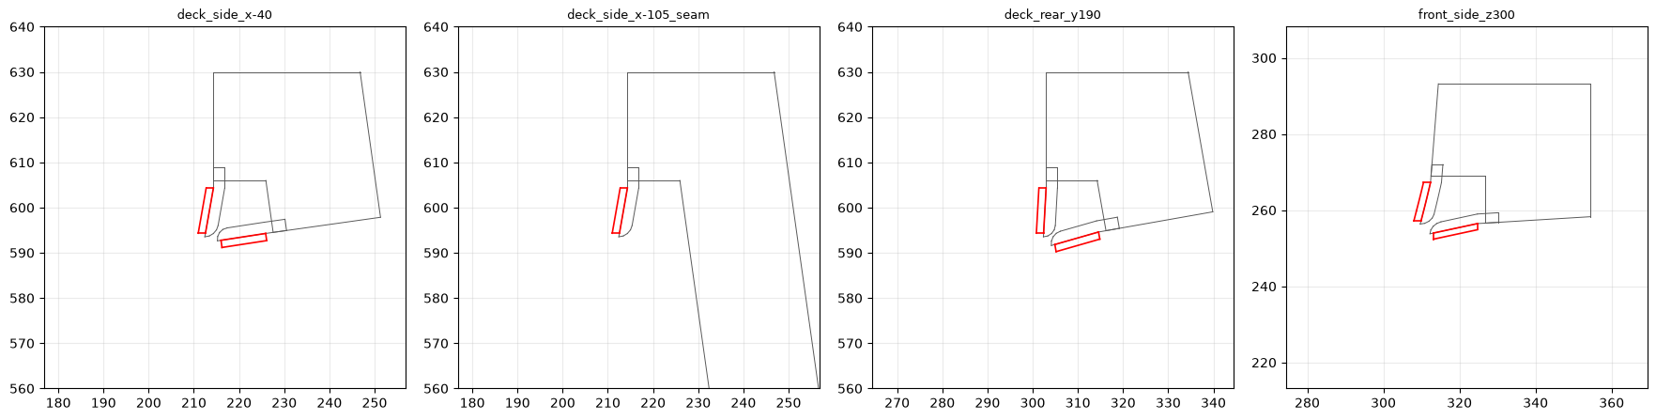
docs/glacis/led_sections_d1_2.png
