ElMagoCT/brophy-tshirt-cannon/docs/glacis/led_sections_d1_3.png

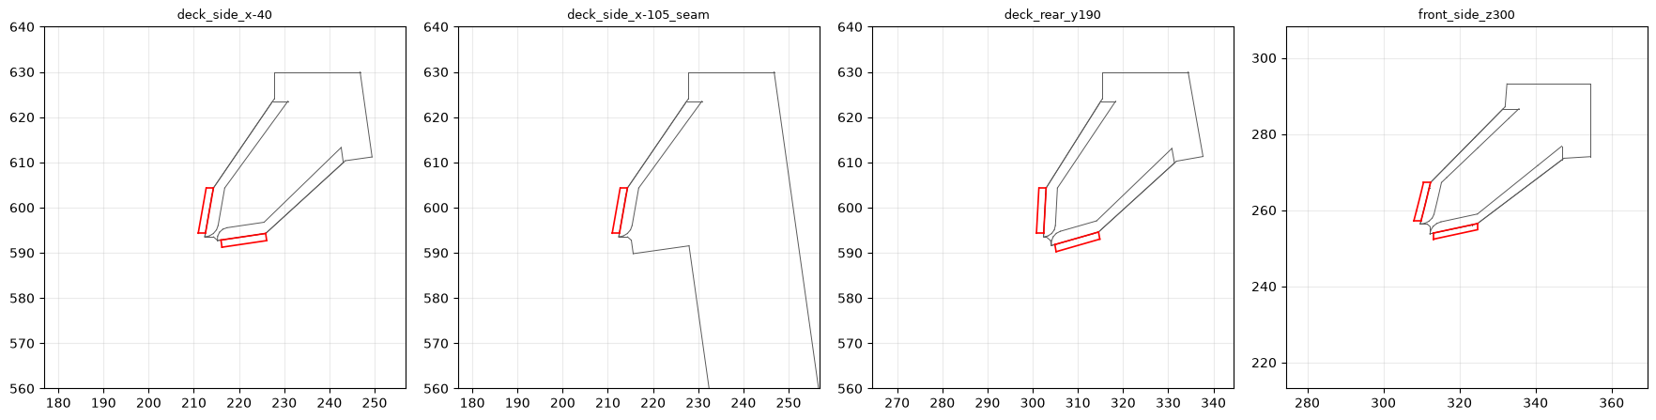
docs/glacis/led_sections_d1_3.png
