ElMagoCT/brophy-tshirt-cannon/docs/glacis/onshape_rev_d2.jpg

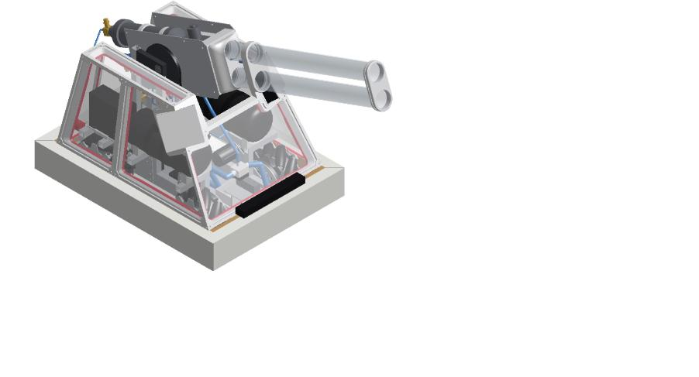
docs/glacis/onshape_rev_d2.jpg
