ElMagoCT/brophy-tshirt-cannon/docs/glacis/onshape_whole_robot.png

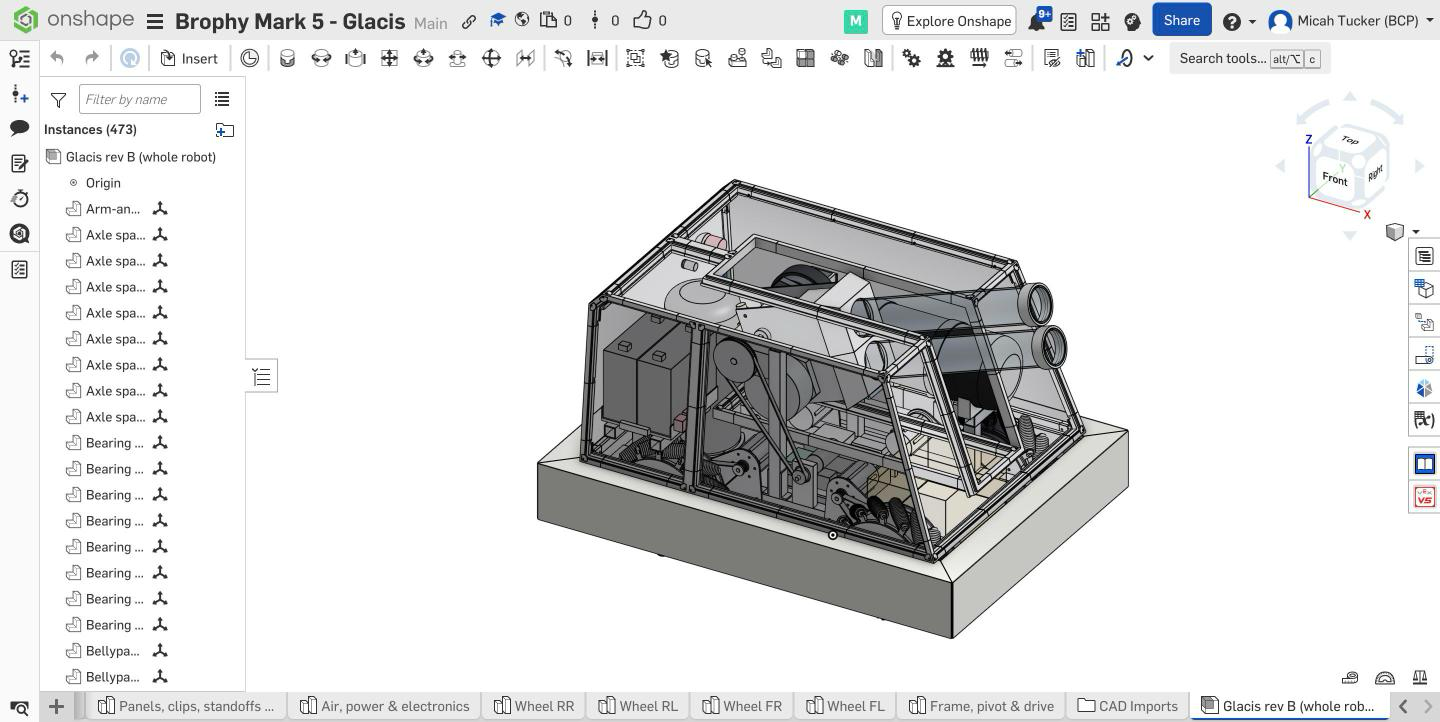
docs/glacis/onshape_whole_robot.png
