ElMagoCT/brophy-tshirt-cannon/docs/glacis/render_d1_1_cad.png

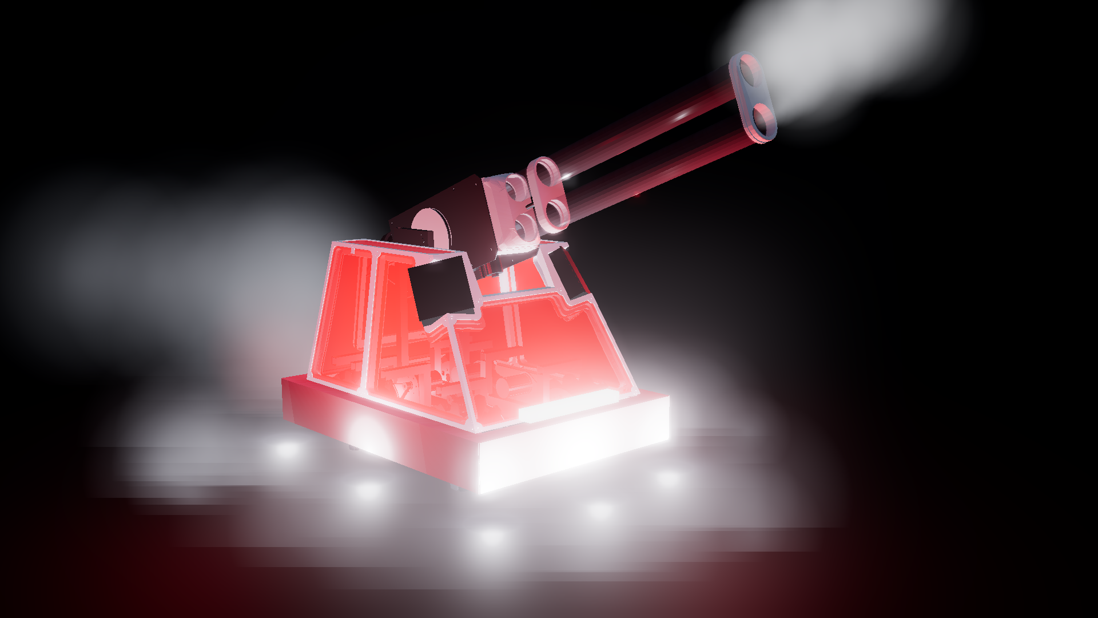
docs/glacis/render_d1_1_cad.png
