ElMagoCT/brophy-tshirt-cannon/docs/glacis/render_d1_1_photo_wide.png

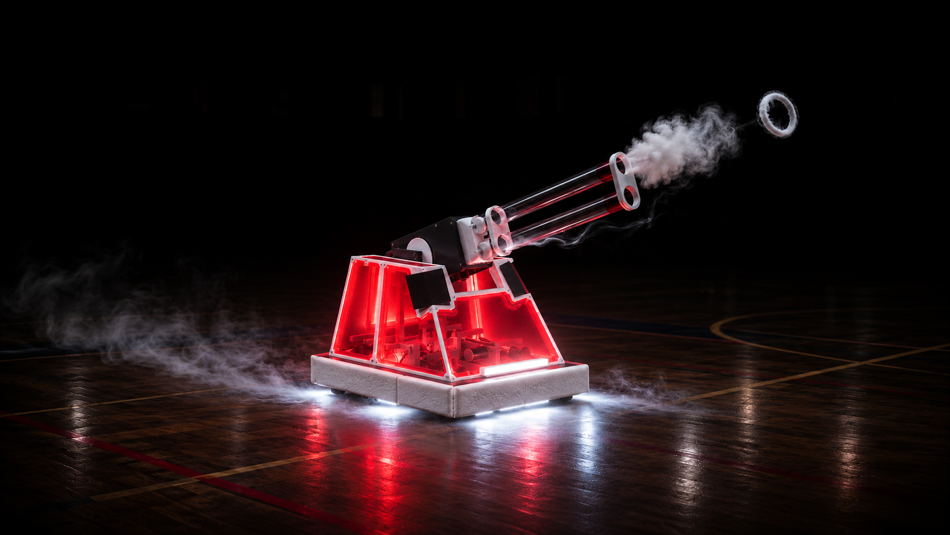
docs/glacis/render_d1_1_photo_wide.png
