ElMagoCT/brophy-tshirt-cannon/cad/glacis/out/parts_from_cad.csv

item | qty | kind | groups | notes
Frosted acrylic panel 1/8 in (owned) | 8 | acrylic | body | 16.9 x 12.0 in outline; 19.6 x 4.5 in outline; 20.3 x 16.9 in outline; 24.1 x 15.4 in outline; 24.1 x 17.0 in outline
1 in NPT close nipple (1-1/2 in), seamless steel, Sch 80 | 2 | cots | gun
1 in cam-buckle strap | 4 | cots | pneu
1/4 NPT brass 90 deg elbow, FNPT x FNPT (ChillWaves) | 1 | cots | pneu
1/4 NPT brass close nipple | 1 | cots | pneu
1/4 NPT brass cross (ChillWaves) | 3 | cots | pneu | close nipples to the in valves; the chamber's transducer and relief on its branches; the hose on
1/4 NPT brass nipple x 1-1/2 in | 1 | cots | pneu | through the rear panel
1/4 NPT brass plug | 4 | cots | pneu
1/4 NPT brass street elbow | 2 | cots | pneu
10k linear pot, 1/4 in shaft (arm angle) | 1 | cots | frame
12 V 40 A SPDT relay + socket | 1 | cots | power | screwed to the bellypan (M4)
12 V 40 A SPDT relay + socket (fog core) | 1 | cots | power | screwed to the bellypan (M4)
12 V 40 A SPDT relay + socket (fog core, spare) | 1 | cots | power | screwed to the bellypan (M4)
12 V 5015 blower | 1 | cots | power | pushes the fog from the cores into the splitter
12->5 V 20 A buck (B089M5R3NJ) | 1 | cots | power | screwed to the bellypan (M4)
120 A main breaker (stash) | 1 | cots | power | rear panel; bottom strip beside the E-stop: the on / off switch; its face through a 42 mm hole; 2 x #10-32 through its ears and the panel
1200 W 20 A boost converter, 8-60 V in, 12-80 V out (set to 33 V) | 1 | cots | power | feeds the amp from a 40 A PDH channel; size not on the listing [UNVERIFIED]; drawn 130 x 55 x 55 like the same module on Amazon
ADS1115 16-bit 4-channel ADC module, I2C, 2-pack (B0DZSP4CG8) | 2 | cots | power | heat-staked onto its printed board tray
Air tank 6 L / 1.6 gal, 200 psi, 1/4 NPT (owner's AliExpress pick) | 2 | cots | pneu
Anderson SB50 pair + 6 AWG contacts (stash) | 2 | cots | power
Anderson SB50 panel-mount charge port | 1 | cots | power | rear panel; bottom: charge or run on standby power with the batteries in
Contactor + battery relays: 12 V 200 A continuous duty, isolated coil, 4-pin (B0D97PSZBB) | 3 | cots | power | in battery A's + lead; between its SB50 and the bus; the controller keeps only the fuller pack connected until the two are within 0.3 V; in battery B's + lead; between its SB50 and the bus; main break
DOT push-to-connect 1/4 tube x 1/4 NPT (Boeray) | 6 | cots | pneu
DOT push-to-connect swivel elbow 1/4 tube x 1/4 NPT | 2 | cots | pneu
DOT push-to-connect swivel elbow 1/4 tube x 1/4 NPT (Boeray) | 2 | cots | gun
DS18B20 waterproof temperature probe | 3 | cots | power | screwed to the bellypan (M4)
ESP32-S3-DevKitC-1 N8R8 (owned) | 1 | cots | power | heat-staked onto its printed board tray
FRC 12 V 18 Ah battery (owned, MK ES17-12) | 2 | cots | power
Falcon 500 (owned) | 4 | cots | drive
Fill check valve, 304 stainless, 1/4 NPT male x male (AliExpress) | 1 | cots | pneu | holds the tanks behind the open plug; flow arrow toward the manifold
Firing valve bottom: U.S. Solid USS-HSV04 1 in NPT, 12 V DC, NC, pilot, 725 psi | 1 | cots | gun
Firing valve top: U.S. Solid USS-HSV04 1 in NPT, 12 V DC, NC, pilot, 725 psi | 1 | cots | gun
Flanged bearing 1/2 hex bore, 1.125 OD (WCP-0783) | 12 | cots | drive/frame
Fog fluid pump: Kamoer NKP 12 V peristaltic | 1 | cots | power
Fog heater core 12 V 200 W (cast, 97 x 32 x 36 mm) | 1 | cots | power | ceramic-fiber wrap; K probe clamped on (firmware cut at 245 C)
Front light bar: Zmoon 12 in single-row LED bar, 72 W spot/flood combo, 12/24 V | 1 | cots | power | in the front hole; on the lower rail; aimed straight ahead
G1/4 BSPP male x 1/4 NPT male hex nipple, 304 | 4 | cots | pneu
HTD 5M 15 mm belt, 140T (WCP) | 4 | cots | drive
HTD 5M 9 mm belt, 150T | 1 | cots | frame | 750 mm pitch length
In valve: GOGO GPG-M03 2/2 NC direct-acting 12 V DC, G1/4, 2.5 mm | 2 | cots | pneu | coil up; flow arrow toward the chamber
Inline ATO fuse holder + 5 A fuse | 1 | cots | power | screwed to the bellypan (M4)
Latching mushroom E-stop, 22 mm, NC | 1 | cots | power | rear panel; bottom; contact 1 in the contactor coil; contact 2 in the valve arm relay coil
Light bar end bracket (comes with the bar) | 2 | cots | power | its foot on the lower front rail (M4 x 8 into a drop-in T-nut); the bar's side bolt through its ear
Logic supply: 5 V 5 A buck-boost module, 3.6-32 V in | 1 | cots | power | heat-staked onto its printed board tray
M5 aluminum standoff (stash) | 4 | cots | power
MOSFET switch module 5-36 V 15 A with heat sink (light bar / fog) | 5 | cots | power | heat-staked onto its printed board tray
MOSFET switch module 5-36 V 15 A, 3.3-20 V trigger (valve / contactor driver) | 6 | cots | power | heat-staked onto its printed board tray
Main controller: Waveshare ESP32-P4-Module-DEV-KIT, ESP32-P4 + ESP32-C6 (B0FDWZ6KWT) | 1 | cots | power | heat-staked onto its printed board tray
Main valve: 1/4 NPT brass ball valve, FNPT x FNPT, 600 WOG (the old cannon's if it fits) | 1 | cots | pneu | stem extended through the rear panel; its lever is outside: along the line = open
PWM expander: PCA9685 16-channel, I2C (Dorhea B07RMTN4NZ) | 1 | cots | power | heat-staked onto its printed board tray
Panel-mount USB-C extension (to the main controller) | 1 | cots | power
Pressure transducer 0-300 psi, 0.5-4.5 V, 1/8 NPT (+ 1/4 x 1/8 bushing) | 2 | cots | pneu
Pressure transducer 0-300 psi, 0.5-4.5 V, 5 V, 1/8 NPT, stainless, with plug cable | 1 | cots | pneu
QD plugs + fill plug: 1/4 NPT female-thread M-style plugs, brass, 10 pcs (ZKZX B081F9J3VF) | 6 | cots | pneu | on the downstream tube; a push-to-connect in its back; your universal coupler snaps on
Quick disconnect coupler: 1/4 NPT female M-style, brass, 300 psi (RUBY.Q) | 5 | cots | pneu | supply side (the coupler has the shut-off); a push-to-connect in its back
REV PDH (owned) + ATO breakers / fuses (stash) | 1 | cots | power
REV Spark MAX (owned) | 1 | cots | power | screwed to the bellypan (M4)
Rear manifold: 1/4 NPT brass crosses + close nipples (built) | 1 | cots | pneu
Relief valve 200 psi, 1/4 NPT male, ASME, ring pull, brass (Loner ST25-1A200, B0F4QP9CG2) | 4 | cots | pneu | pull ring at the rear panel: the hand dump; the chamber's own relief and hand bleed (the in valve's closed seat seals it off from the tanks)
Siren speaker 200 W, 8 ohm, aluminium (Xprite B01DMSR4L4) | 2 | cots | power | 5.7 x 5.5 x 2.3 in with its foot; 121-130 dB
TPA3255 2 x 300 W class-D amp board, 19-50 V DC, 122 x 73 x 30 mm | 1 | cots | power | one channel per speaker; about 70 W each on 33 V
Thermocouple amp MAX6675 module (+ K probe on the core) | 1 | cots | power | heat-staked onto its printed board tray
ULN2803A Darlington driver on a perfboard: the relay coils | 1 | cots | power | heat-staked onto its printed board tray
WCP-0319 12T HTD 15 mm Falcon pulley | 4 | cots | drive
goBILDA 5203-2402-0019 Yellow Jacket 19.2:1, 312 rpm (FTC motor) | 1 | cots | frame | Spark MAX; brushed mode
Breech adapter (CNC 6061, stash bar, 1 in NPT tap) | 2 | machined | gun
Chamber end disc: 3/8 in A36, 3.5 in OD (waterjet) | 4 | machined | gun | 1.33 in hole for the outlet nipple; welded to the pipe and the nipple; blank; welded on
1/2 hex spacer (printed or stash) | 8 | print | drive | 1.4 mm; 3.1 mm
Axle hub | 1 | print | gun | PETG; 5 walls; 40% gyroid; hex bore on the pivot stub; 4 x M4 x 12 through its flange and the cradle plate into nylocs; its lip bears on the inner bearing's inner race
Axle spacer (printed) | 1 | print | gun | hex bore on the right stub; from the cradle plate to the inner bearing's inner race: locates the gun sideways
Battery sled (pulls out its side's battery door) | 2 | print | power
Body frame piece E00S0 | 1 | print | body | PETG; 0.6 mm nozzle; 2 walls; 10% gyroid
Body frame piece E00S1 | 1 | print | body | PETG; 0.6 mm nozzle; 2 walls; 10% gyroid
Body frame piece E01S0+N07+N19 | 1 | print | body | PETG; 0.6 mm nozzle; 2 walls; 10% gyroid
Body frame piece E02S0+N05+E03S0 | 1 | print | body | PETG; 0.6 mm nozzle; 2 walls; 10% gyroid
Body frame piece E03S1 | 1 | print | body | PETG; 0.6 mm nozzle; 2 walls; 10% gyroid
Body frame piece E04S0+N06 | 1 | print | body | PETG; 0.6 mm nozzle; 2 walls; 10% gyroid
Body frame piece E05S0+N08+N20 | 1 | print | body | PETG; 0.6 mm nozzle; 2 walls; 10% gyroid
Body frame piece E06S0 | 1 | print | body | PETG; 0.6 mm nozzle; 2 walls; 10% gyroid
Body frame piece E06S1 | 1 | print | body | PETG; 0.6 mm nozzle; 2 walls; 10% gyroid
Body frame piece E07S0+N16 | 1 | print | body | PETG; 0.6 mm nozzle; 2 walls; 10% gyroid
Body frame piece E08S0+cheek L+N00b | 1 | print | body | PETG; 0.6 mm nozzle; 2 walls; 10% gyroid
Body frame piece E09S0 | 1 | print | body | PETG; 0.6 mm nozzle; 2 walls; 10% gyroid
Body frame piece E10S0+cheek R+N00a | 1 | print | body | PETG; 0.6 mm nozzle; 2 walls; 10% gyroid
Body frame piece E11S0+N15 | 1 | print | body | PETG; 0.6 mm nozzle; 2 walls; 10% gyroid
Body frame piece E12S0 | 1 | print | body | PETG; 0.6 mm nozzle; 2 walls; 10% gyroid
Body frame piece E13S0+N13 | 1 | print | body | PETG; 0.6 mm nozzle; 2 walls; 10% gyroid
Body frame piece E16S0 | 1 | print | body | PETG; 0.6 mm nozzle; 2 walls; 10% gyroid
Body frame piece E17S0 | 1 | print | body | PETG; 0.6 mm nozzle; 2 walls; 10% gyroid
Body frame piece E17S1+N21 | 1 | print | body | PETG; 0.6 mm nozzle; 2 walls; 10% gyroid
Body frame piece E18S0 | 1 | print | body | PETG; 0.6 mm nozzle; 2 walls; 10% gyroid
Body frame piece E18S1 | 1 | print | body | PETG; 0.6 mm nozzle; 2 walls; 10% gyroid
Body frame piece E19S0+N11 | 1 | print | body | PETG; 0.6 mm nozzle; 2 walls; 10% gyroid
Body frame piece E20S0 | 1 | print | body | PETG; 0.6 mm nozzle; 2 walls; 10% gyroid
Body frame piece E20S1 | 1 | print | body | PETG; 0.6 mm nozzle; 2 walls; 10% gyroid
Body frame piece E21S0 | 1 | print | body | PETG; 0.6 mm nozzle; 2 walls; 10% gyroid
Body frame piece E23S0 | 1 | print | body | PETG; 0.6 mm nozzle; 2 walls; 10% gyroid
Body frame piece E23S1 | 1 | print | body | PETG; 0.6 mm nozzle; 2 walls; 10% gyroid
Body frame piece E24S0+N04+N09 | 1 | print | body | PETG; 0.6 mm nozzle; 2 walls; 10% gyroid
Body frame piece E25S0 | 1 | print | body | PETG; 0.6 mm nozzle; 2 walls; 10% gyroid
Body frame piece E25S1 | 1 | print | body | PETG; 0.6 mm nozzle; 2 walls; 10% gyroid
Body frame piece E27S0 | 1 | print | body | PETG; 0.6 mm nozzle; 2 walls; 10% gyroid
Body frame piece E28S0+N12 | 1 | print | body | PETG; 0.6 mm nozzle; 2 walls; 10% gyroid
Body frame piece E29S0+N03+N10 | 1 | print | body | PETG; 0.6 mm nozzle; 2 walls; 10% gyroid
Body frame piece E32S0+N14 | 1 | print | body | PETG; 0.6 mm nozzle; 2 walls; 10% gyroid
Body frame piece E33S0 | 1 | print | body | PETG; 0.6 mm nozzle; 2 walls; 10% gyroid
Body frame piece E34S0 | 1 | print | body | PETG; 0.6 mm nozzle; 2 walls; 10% gyroid
Body frame piece E34S1 | 1 | print | body | PETG; 0.6 mm nozzle; 2 walls; 10% gyroid
Body frame piece E35S0 | 1 | print | body | PETG; 0.6 mm nozzle; 2 walls; 10% gyroid
Body frame piece E35S1+N22 | 1 | print | body | PETG; 0.6 mm nozzle; 2 walls; 10% gyroid
Body frame piece E36S0 | 1 | print | body | PETG; 0.6 mm nozzle; 2 walls; 10% gyroid
Body frame piece E37S0 | 1 | print | body | PETG; 0.6 mm nozzle; 2 walls; 10% gyroid
Body frame piece E37S1 | 1 | print | body | PETG; 0.6 mm nozzle; 2 walls; 10% gyroid
Body frame piece E38S0 | 1 | print | body | PETG; 0.6 mm nozzle; 2 walls; 10% gyroid
Body frame piece E39S0 | 1 | print | body | PETG; 0.6 mm nozzle; 2 walls; 10% gyroid
Body frame piece E40S0 | 1 | print | body | PETG; 0.6 mm nozzle; 2 walls; 10% gyroid
Body frame piece E41S0+N18 | 1 | print | body | PETG; 0.6 mm nozzle; 2 walls; 10% gyroid
Body frame piece E41S1 | 1 | print | body | PETG; 0.6 mm nozzle; 2 walls; 10% gyroid
Body frame piece E41S2+N17 | 1 | print | body | PETG; 0.6 mm nozzle; 2 walls; 10% gyroid
Body frame piece N01 | 1 | print | body | PETG; 0.6 mm nozzle; 2 walls; 10% gyroid
Body frame piece N02 | 1 | print | body | PETG; 0.6 mm nozzle; 2 walls; 10% gyroid
Bumper corner bracket (printed) | 4 | print | bumper | joins the ring outside the corner; inside the foam; 4 x #10-32 x 1/2 in from the rail side into heat-set inserts. 4 walls; 25%
Bumper spacer (printed, 3/16 in) | 6 | print | bumper | on the bumper's #10-32 between the outer rail and the 1x6
Chamber cap | 4 | print | gun | PETG; 5 walls; 40% gyroid; V-shaped like the plates' back; fills out to the plates; one M4 x 8 through each plate into an M4 insert in each side; PETG; 5 walls; 40% gyroid; fills out to the cradle pla
Chamber end cover (printed) | 2 | print | gun | PETG; 4 walls; pushes onto the chamber's welded back end with a bead of RTV; LED groove for a 5 mm strip; cosmetic; not on the pressure boundary
Chamber saddle | 2 | print | gun | PETG; 5 walls; 40% gyroid; 2 x M4 x 8 through each cradle plate into inserts in its sides; caps close the outer halves; PETG; 5 walls; 40% gyroid; V-shaped to follow the plates' swallowtail back; 2 x
Elevation motor bracket | 1 | print | frame | PETG; 5 walls; 40% gyroid; hangs from the right in-well rail (2 x M4 x 12 up into T-nuts in its bottom slot); slotted for belt tension
Elevation pinion 16T HTD 9 mm (8 mm REX bore) | 1 | print | frame | printed from Micah's own pulley design; sits out on the shaft so the belt is centred between the cradle plate and the bearing block
Elevation pulley 112T HTD 9 mm ring (printed) | 1 | print | gun | PETG; 5 walls; 40% gyroid; a ring (136 mm bore) on 6 printed posts 10 mm off the right cradle plate; an M4 insert in each; M4 x 8 from inside the plate; print it on its outer flange; posts up
Fog fluid tank (printed, about 400 mL) | 1 | print | power | water-based glycol fog fluid only
Fog splitter 1 -> 3 (printed) | 1 | print | power | 22 mm barbs for the two trail tubes; a 3/4 in barb (15 mm bore) for the gun's 3/4 in silicone line
Fog vent nozzle (under bumper) | 1 | print | power | through a hole in the bellypan
Fog vent nozzle (under the belly) | 1 | print | power | through a hole in the bellypan
Frame mount post (printed) | 13 | print | body | 2-1/2 in #10-32 up through the end rail and gusset into its insert; the frame's 1/2 in #10-32 from the outer pocket (bumper ring off first); 2-1/2 in #10-32 up through the end rail into its insert; th
Gun core half (valve blocks + breech block + mantlet, printed) | 2 | print | gun | PETG; 5 walls; 40% gyroid; printed outer face down; the two halves close round both valves and both barrels: 4 x M4 x 12 across the split; over and under the barrels (heads in the right half; inserts
Mecanum hub, inboard half + 116T pulley | 4 | print | drive | PETG; 5 walls; 40% gyroid; teeth down
Mecanum hub, outboard half | 4 | print | drive | PETG; 5 walls; 40% gyroid; face down; 10 x M8 nyloc captured
Mecanum roller core (PETG) | 40 | print | drive | 2 x 608 2RS pressed in
Mecanum roller tread (TPU 95A) | 40 | print | drive
Muzzle ring (printed, one piece, LED groove) | 1 | print | gun | slides on last; flush with the barrel ends; a 5 mm strip in its groove
Panel corner clip | 40 | print | body | M4 x 6 button head into an M4 x 4 insert; M4 x 8 button head into an M4 x 4 insert (at the top of the 6.5 mm hole)
Pivot bearing block | 2 | print | frame | PETG; 5 walls; 40% gyroid; sits on the in-well rail (2 x M4 x 12 down into T-nuts in its top slot); 3 x 1/4-20 through the tower plate into heat-set inserts
Pot bracket | 1 | print | frame | screws through the left tower plate into the bearing block
Pot coupler (1/2 hex to 1/4 in D) | 1 | print | frame
Printed board tray | 19 | print | power | PETG; the board heat-staked onto its four pegs; 2 x M4 x 12 up through the bellypan into inserts
Smoke collar (printed, one piece) | 1 | print | gun | slides on from the muzzle until its 6 channels line up with the barrels' smoke holes; a bead of RTV round each barrel seals it; the squished 3/4 in line pushes into the oblong socket at the back
Smoke machine tray | 1 | print | power
Speaker cup | 2 | print | body | lines the corner notch; 4 x M4 x 8 through its side walls into inserts in the frame; the speaker's L foot bolts through the cup's lower wall (M4)
Speaker grille | 2 | print | body | 3 walls; no top or bottom layers; 12% gyroid: an open mesh; glue or screw to the cup
Tank saddle | 4 | print | pneu
Underglow bracket (printed, 45 deg) | 14 | print | bumper | 3M tape on its top onto the rail's bottom wall (and the corner gusset where it steps down); the strip on its 45 deg face with the same tape
1/2 in hex shaft, steel (pivot stub) | 2 | stock | gun | 2.2 in; tapped 1/4-20 both ends: a bolt and washer inside the cradle plate and one outside the outer bearing keep it from sliding; 2.7 in; tapped 1/4-20 both ends: a bolt and washer inside the cradle
1/2 in hex shaft, wheel axle (6 in) | 4 | stock | drive | tapped 10-32 both ends; button head + washer; the outer one inside the outer rail; put in through the 14 mm hole in its outer wall
20x20 T-slot extrusion (owned spare, cut) | 6 | stock | body/gun | 276 mm; 3 x M4 x 8 through the cradle plate into M4 drop-in T-nuts; top flush with the plate; 372 mm across the front hole; 2 x M4 x 8 from inside; through holes CNC'd across the rail into M4 x 4 inse
Aluminum box tube 1x1 x 1/16 wall (owned) | 18 | stock | frame | 17.94 in; 5 CNC'd holes (docs/glacis/tube_drilling.csv); 3.97 in; 4 CNC'd holes (docs/glacis/tube_drilling.csv); 4.09 in; 7 CNC'd holes (docs/glacis/tube_drilling.csv); 4.09 in; 8 CNC'd holes (docs/gl
Aluminum box tube 1x2 x 1/16 wall (owned) | 6 | stock | frame | 20.25 in; 18 CNC'd holes (docs/glacis/tube_drilling.csv); 20.25 in; 19 CNC'd holes (docs/glacis/tube_drilling.csv); 30.24 in; 48 CNC'd holes (docs/glacis/tube_drilling.csv); 32.24 in; 30 CNC'd holes (
Arm knee (1/8 Al, waterjet) | 12 | stock | frame | one on each face of the sled post / arm joint: 2 rivets up the post; 3 along the arm; 5 x 3/16 blind rivets; one on each face of the tank post / arm joint: 2 rivets up the post; 3 along the arm; 5 x 3
Arm knee short (1/8 Al, waterjet) | 2 | stock | frame | front face of the rearmost sled post / rail joint only (the rear manifold is right behind it; the line relief valve in front of the post's lower half): 1 rivet in the post; 3 in the rail; 4 x 3/16 bli
Barrel: clear polycarbonate tube 3 in OD x 1/8 wall | 2 | stock | gun | 36.0 in; 3 x 5 mm smoke holes 205 mm from the breech end; on the side facing the other barrel (straight at it and 35 deg either side); drilled through the collar's channels
Bellypan (1/8 Al, CNC router, one piece) | 1 | stock | frame | one piece; CNC router: riveted up into both inner rails; the fog vents through it; every electronics part's footprint engraved (drill its holes to the part); 24 x 3/16 countersunk blind rivets
Bumper backing, 1x6 ripped to 5 in (3/4 x 5 in) | 4 | stock | bumper | #10-32 x 1-1/4 in from inside the outer rail into a pronged T-nut at x -80; 0; 80; no screws to the robot: held by the side strips through the corner brackets
Bumper fabric cover (white canvas, owner's pick) | 4 | stock | bumper
Bumper foam strip 2 x 5 in (GoTo Foam 43 ILD) | 4 | stock | bumper
Chamber inlet: 1/4 NPT female steel weld-on bung | 2 | stock | gun | welded over a 1/2 in hole in the pipe wall
Chamber outlet: 1 in TOE nipple (half of a 1 x 4 in black nipple), welded through the front disc | 2 | stock | gun
Chamber: 3 in Sch 40 steel pipe, plain end (cut) | 2 | stock | gun | 10.9 in; 12.9 in
Corner gusset bottom (1/8 Al, waterjet) | 4 | stock | frame | rivets into the end rail; the outer rail; countersunk (the underglow bracket runs right under it); 9 x 3/16 countersunk blind rivets
Corner gusset top (1/8 Al, waterjet) | 4 | stock | frame | rivets into the end rail; the outer rail and the inner rail; 9 x 3/16 blind rivets
DOT nylon tube 1/4 OD (ft) | 12 | stock | gun/pneu | SAE J844; inside the core; leaves the bottom behind the pivot
Fog heater bracket (1/8 Al) | 1 | stock | power
Fog tube (owner's flexible tube) | 2 | stock | power
Gun cradle plate (1/8 Al, CNC router) | 2 | stock | gun | Chevron + turret wheel: swallowtail back; round boss round the pivot; chevron pockets (CNC router: too big for the 12 x 12 waterjet)
Inboard plate front tank (1/8 Al, waterjet) | 2 | stock | frame | inner face of the inner rail; riveted to it and up each post; 4 x 3/16 blind rivets
Inboard plate rear (1/8 Al, waterjet) | 2 | stock | frame | inner face of the inner rail; riveted to it and up each post; 11 x 3/16 blind rivets
Inboard plate rear tank (1/8 Al, waterjet) | 2 | stock | frame | inner face of the inner rail; riveted to it and up each post; 4 x 3/16 blind rivets
M8 threaded rod, roller axle (cut 109 mm) | 40 | stock | drive | Loctite 243 in the captured nyloc; slot the outboard end
Mecanum centre plate (1/8 Al) | 4 | stock | drive | waterjet; 1/2 hex + 8 x 1/4-20 + 12 lightening holes
Mecanum inner plate (1/8 Al) | 4 | stock | drive | waterjet; 1/2 hex + 8 x 1/4-20 + 12 lightening holes
Mecanum outer plate (1/8 Al) | 4 | stock | drive | waterjet; 1/2 hex + 8 x 1/4-20 + 12 lightening holes
Rail spacer strip (1/8 Al, waterjet) | 2 | stock | frame | fills the gap between the in-well rail and the deck member past the tower plate; the rail's M4s through it
Side plate front (1/8 Al, waterjet) | 2 | stock | drive | carries the Falcon (4 x 10-32 into its face) and the axle; and rivets into the inner rail and every post on this stretch: tank post x 200; 12 x 3/16 countersunk blind rivets
Side plate rear (1/8 Al, waterjet) | 2 | stock | drive | carries the Falcon (4 x 10-32 into its face) and the axle; and rivets into the inner rail and every post on this stretch: sled post x -320; sled post x -215; tower post x -170; tank post x -60; 16 x 3
Silicone tube 1/2 ID x 5/8 OD (ft) | 1 | stock | power
Silicone tube 3/4 ID x 1 OD (ft) | 1 | stock | gun | collar to the bottom of the core; dead centre between the barrels; squished to an oval in the gun
Tower plate (1/8 Al, waterjet) | 2 | stock | frame | flat (was bent): 2 rivets into the tower; the in-well rail's M4s through it; 3 x 1/4-20 into the bearing block; between the rail and the deck's well-edge member; 2 x 3/16 blind rivets
WS2812B strip 10 mm, 60/m (m) | 12 | stock | body/bumper | aimed 45 deg down and out; its centre just under the bumper's bottom edge; 3M tape; on the rail behind the panel; LEDs across it; cut and jumped with 3 wires where a neighbour crosses
WS2812B strip 5 mm, 100/m (m) | 30 | stock | body | pushed through the frame tunnel; LEDs out
