ElMagoCT/brophy-tshirt-cannon/cad/glacis/out/part_codes.csv

Part number | Part | Tab | CAD label
3DP-B001 | Bumper corner bracket rear R | bumpers_wall_standoffs | Bumper corner bracket (printed)
3DP-B002 | Bumper corner bracket rear L | bumpers_wall_standoffs | Bumper corner bracket (printed)
3DP-B003 | Underglow bracket rear 2 | bumpers_wall_standoffs | Underglow bracket (printed, 45 deg)
3DP-B004 | Underglow bracket rear 3 | bumpers_wall_standoffs | Underglow bracket (printed, 45 deg)
3DP-B005 | Underglow bracket rear 1 | bumpers_wall_standoffs | Underglow bracket (printed, 45 deg)
3DP-B006 | Frame mount rear -170 | bumpers_wall_standoffs | Frame mount post (printed)
3DP-B007 | Frame mount rear 0 | bumpers_wall_standoffs | Frame mount post (printed)
3DP-B008 | Frame mount rear 170 | bumpers_wall_standoffs | Frame mount post (printed)
3DP-B009 | Underglow bracket left 1 | bumpers_wall_standoffs | Underglow bracket (printed, 45 deg)
3DP-B010 | Underglow bracket right 1 | bumpers_wall_standoffs | Underglow bracket (printed, 45 deg)
3DP-B011 | Frame mount L -280 | bumpers_wall_standoffs | Frame mount post (printed)
3DP-B012 | Frame mount R -280 | bumpers_wall_standoffs | Frame mount post (printed)
3DP-B013 | Frame mount L -205 | bumpers_wall_standoffs | Frame mount post (printed)
3DP-B014 | Frame mount R -205 | bumpers_wall_standoffs | Frame mount post (printed)
3DP-B015 | Underglow bracket left 2 | bumpers_wall_standoffs | Underglow bracket (printed, 45 deg)
3DP-B016 | Underglow bracket right 2 | bumpers_wall_standoffs | Underglow bracket (printed, 45 deg)
3DP-B017 | Bumper spacer left -80 | bumpers_wall_standoffs | Bumper spacer (printed, 3/16 in)
3DP-B018 | Bumper spacer right -80 | bumpers_wall_standoffs | Bumper spacer (printed, 3/16 in)
3DP-B019 | Bumper spacer left 0 | bumpers_wall_standoffs | Bumper spacer (printed, 3/16 in)
3DP-B020 | Bumper spacer right 0 | bumpers_wall_standoffs | Bumper spacer (printed, 3/16 in)
3DP-B021 | Bumper spacer left 80 | bumpers_wall_standoffs | Bumper spacer (printed, 3/16 in)
3DP-B022 | Bumper spacer right 80 | bumpers_wall_standoffs | Bumper spacer (printed, 3/16 in)
3DP-B023 | Underglow bracket left 3 | bumpers_wall_standoffs | Underglow bracket (printed, 45 deg)
3DP-B024 | Underglow bracket right 3 | bumpers_wall_standoffs | Underglow bracket (printed, 45 deg)
3DP-B025 | Frame mount L 100 | bumpers_wall_standoffs | Frame mount post (printed)
3DP-B026 | Frame mount R 100 | bumpers_wall_standoffs | Frame mount post (printed)
3DP-B027 | Frame mount L 280 | bumpers_wall_standoffs | Frame mount post (printed)
3DP-B028 | Frame mount R 280 | bumpers_wall_standoffs | Frame mount post (printed)
3DP-B029 | Underglow bracket left 4 | bumpers_wall_standoffs | Underglow bracket (printed, 45 deg)
3DP-B030 | Underglow bracket right 4 | bumpers_wall_standoffs | Underglow bracket (printed, 45 deg)
3DP-B031 | Frame mount front -205 | bumpers_wall_standoffs | Frame mount post (printed)
3DP-B032 | Frame mount front 205 | bumpers_wall_standoffs | Frame mount post (printed)
3DP-B033 | Underglow bracket front 2 | bumpers_wall_standoffs | Underglow bracket (printed, 45 deg)
3DP-B034 | Underglow bracket front 1 | bumpers_wall_standoffs | Underglow bracket (printed, 45 deg)
3DP-B035 | Underglow bracket front 3 | bumpers_wall_standoffs | Underglow bracket (printed, 45 deg)
3DP-B036 | Bumper corner bracket front R | bumpers_wall_standoffs | Bumper corner bracket (printed)
3DP-B037 | Bumper corner bracket front L | bumpers_wall_standoffs | Bumper corner bracket (printed)
3DP-B038 | Body frame E41S1 | body_frame_1_of_6 | Body frame piece E41S1
3DP-B039 | Body frame E41S0+N18 | body_frame_1_of_6 | Body frame piece E41S0+N18
3DP-B040 | Body frame E41S2+N17 | body_frame_1_of_6 | Body frame piece E41S2+N17
3DP-B041 | Body frame E39S0 | body_frame_1_of_6 | Body frame piece E39S0
3DP-B042 | Body frame E20S0 | body_frame_1_of_6 | Body frame piece E20S0
3DP-B043 | Body frame E37S0 | body_frame_1_of_6 | Body frame piece E37S0
3DP-B044 | Body frame N01 | body_frame_1_of_6 | Body frame piece N01
3DP-B045 | Body frame N02 | body_frame_1_of_6 | Body frame piece N02
3DP-B046 | Body frame E40S0 | body_frame_2_of_6 | Body frame piece E40S0
3DP-B047 | Body frame E38S0 | body_frame_2_of_6 | Body frame piece E38S0
3DP-B048 | Body frame E20S1 | body_frame_2_of_6 | Body frame piece E20S1
3DP-B049 | Body frame E37S1 | body_frame_2_of_6 | Body frame piece E37S1
3DP-B050 | Body frame E24S0+N04+N09 | body_frame_2_of_6 | Body frame piece E24S0+N04+N09
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
3DP-B107 | Panel clip 01-4 | body_panels_clips | Panel corner clip
3DP-B108 | Panel clip 05-4 | body_panels_clips | Panel corner clip
3DP-B109 | Panel clip 05-3 | body_panels_clips | Panel corner clip
3DP-B110 | Panel clip 01-2 | body_panels_clips | Panel corner clip
3DP-B111 | Panel clip 05-0 | body_panels_clips | Panel corner clip
3DP-B112 | Panel clip 03-1 | body_panels_clips | Panel corner clip
3DP-B113 | Panel clip 03-2 | body_panels_clips | Panel corner clip
3DP-B114 | Panel clip 04-1 | body_panels_clips | Panel corner clip
3DP-B115 | Panel clip 04-2 | body_panels_clips | Panel corner clip
3DP-B116 | Panel clip 00-6 | body_panels_clips | Panel corner clip
3DP-B117 | Panel clip 00-7 | body_panels_clips | Panel corner clip
3DP-B118 | Panel clip 01-1 | body_panels_clips | Panel corner clip
3DP-B119 | Panel clip 05-1 | body_panels_clips | Panel corner clip
3DP-B120 | Panel clip 00-5 | body_panels_clips | Panel corner clip
3DP-B121 | Panel clip 00-0 | body_panels_clips | Panel corner clip
3DP-B122 | Panel clip 05-2 | body_panels_clips | Panel corner clip
3DP-B123 | Panel clip 01-0 | body_panels_clips | Panel corner clip
3DP-B124 | Panel clip 00-1 | body_panels_clips | Panel corner clip
3DP-B125 | Panel clip 00-4 | body_panels_clips | Panel corner clip
3DP-B126 | Panel clip 00-2 | body_panels_clips | Panel corner clip
3DP-B127 | Panel clip 00-3 | body_panels_clips | Panel corner clip
3DP-C001 | Board tray Main controller ESP32-P4 + C6 | power_electronics_smoke | Printed board tray
3DP-C002 | Board tray ESP32-S3 safety node | power_electronics_smoke | Printed board tray
3DP-C003 | Battery sled left | power_electronics_smoke | Battery sled (pulls out its side's battery door)
3DP-C004 | Battery sled right | power_electronics_smoke | Battery sled (pulls out its side's battery door)
3DP-C005 | Board tray PWM expander PCA9685 | power_electronics_smoke | Printed board tray
3DP-C006 | Board tray ADS1115 ADC 1 | power_electronics_smoke | Printed board tray
3DP-C007 | Board tray ADS1115 ADC 2 | power_electronics_smoke | Printed board tray
3DP-C008 | Board tray Relay driver board | power_electronics_smoke | Printed board tray
3DP-C009 | Board tray Valve MOSFET module 2 | power_electronics_smoke | Printed board tray
3DP-C010 | Board tray Valve MOSFET module 3 | power_electronics_smoke | Printed board tray
3DP-C011 | Board tray Valve MOSFET module 1 | power_electronics_smoke | Printed board tray
3DP-C012 | Board tray Logic supply 5 V | power_electronics_smoke | Printed board tray
3DP-C013 | Board tray Valve MOSFET module 4 | power_electronics_smoke | Printed board tray
3DP-C014 | Board tray Valve MOSFET module 5 | power_electronics_smoke | Printed board tray
3DP-C015 | Board tray Valve MOSFET module 6 | power_electronics_smoke | Printed board tray
3DP-C016 | Board tray Thermocouple amp MAX6675 | power_electronics_smoke | Printed board tray
3DP-D001 | Axle spacer inner RL | chassis_pivot_drive_1_of_6 | 1/2 hex spacer (printed or stash)
3DP-D002 | Axle spacer outer RL | chassis_pivot_drive_1_of_6 | 1/2 hex spacer (printed or stash)
3DP-D003 | Axle spacer inner RR | chassis_pivot_drive_2_of_6 | 1/2 hex spacer (printed or stash)
3DP-D004 | Axle spacer outer RR | chassis_pivot_drive_2_of_6 | 1/2 hex spacer (printed or stash)
3DP-D005 | Pot coupler | chassis_pivot_drive_4_of_6 | Pot coupler (1/2 hex to 1/4 in D)
3DP-D006 | Pot bracket | chassis_pivot_drive_4_of_6 | Pot bracket
3DP-D007 | Axle spacer inner FL | chassis_pivot_drive_6_of_6 | 1/2 hex spacer (printed or stash)
3DP-D008 | Axle spacer outer FL | chassis_pivot_drive_6_of_6 | 1/2 hex spacer (printed or stash)
3DP-D009 | Axle spacer inner FR | chassis_pivot_drive_6_of_6 | 1/2 hex spacer (printed or stash)
3DP-D010 | Axle spacer outer FR | chassis_pivot_drive_6_of_6 | 1/2 hex spacer (printed or stash)
3DP-D011 | Roller tread FL05 | wheel_fl | Mecanum roller tread (TPU 95A)
3DP-D012 | Roller core FL05 | wheel_fl | Mecanum roller core (PETG)
3DP-D013 | Roller tread FL06 | wheel_fl | Mecanum roller tread (TPU 95A)
3DP-D014 | Roller core FL06 | wheel_fl | Mecanum roller core (PETG)
3DP-D015 | Roller tread FL04 | wheel_fl | Mecanum roller tread (TPU 95A)
3DP-D016 | Roller core FL04 | wheel_fl | Mecanum roller core (PETG)
3DP-D017 | Roller core FL03 | wheel_fl | Mecanum roller core (PETG)
3DP-D018 | Roller tread FL07 | wheel_fl | Mecanum roller tread (TPU 95A)
3DP-D019 | Roller core FL07 | wheel_fl | Mecanum roller core (PETG)
3DP-D020 | Roller tread FL03 | wheel_fl | Mecanum roller tread (TPU 95A)
3DP-D021 | Wheel hub inboard + 116T FL | wheel_fl | Mecanum hub, inboard half + 116T pulley
3DP-D022 | Wheel hub outboard FL | wheel_fl | Mecanum hub, outboard half
3DP-D023 | Roller tread FL02 | wheel_fl | Mecanum roller tread (TPU 95A)
3DP-D024 | Roller core FL02 | wheel_fl | Mecanum roller core (PETG)
3DP-D025 | Roller tread FL08 | wheel_fl | Mecanum roller tread (TPU 95A)
3DP-D026 | Roller core FL08 | wheel_fl | Mecanum roller core (PETG)
3DP-D027 | Roller tread FL01 | wheel_fl | Mecanum roller tread (TPU 95A)
3DP-D028 | Roller core FL01 | wheel_fl | Mecanum roller core (PETG)
3DP-D029 | Roller tread FL09 | wheel_fl | Mecanum roller tread (TPU 95A)
3DP-D030 | Roller core FL09 | wheel_fl | Mecanum roller core (PETG)
3DP-D031 | Roller tread FL00 | wheel_fl | Mecanum roller tread (TPU 95A)
3DP-D032 | Roller core FL00 | wheel_fl | Mecanum roller core (PETG)
3DP-D033 | Roller tread FR05 | wheel_fr | Mecanum roller tread (TPU 95A)
3DP-D034 | Roller core FR05 | wheel_fr | Mecanum roller core (PETG)
3DP-D035 | Roller tread FR06 | wheel_fr | Mecanum roller tread (TPU 95A)
3DP-D036 | Roller core FR06 | wheel_fr | Mecanum roller core (PETG)
3DP-D037 | Roller tread FR04 | wheel_fr | Mecanum roller tread (TPU 95A)
3DP-D038 | Roller core FR04 | wheel_fr | Mecanum roller core (PETG)
3DP-D039 | Roller core FR03 | wheel_fr | Mecanum roller core (PETG)
3DP-D040 | Roller tread FR07 | wheel_fr | Mecanum roller tread (TPU 95A)
3DP-D041 | Roller core FR07 | wheel_fr | Mecanum roller core (PETG)
3DP-D042 | Roller tread FR03 | wheel_fr | Mecanum roller tread (TPU 95A)
3DP-D043 | Wheel hub outboard FR | wheel_fr | Mecanum hub, outboard half
3DP-D044 | Wheel hub inboard + 116T FR | wheel_fr | Mecanum hub, inboard half + 116T pulley
3DP-D045 | Roller tread FR02 | wheel_fr | Mecanum roller tread (TPU 95A)
3DP-D046 | Roller core FR02 | wheel_fr | Mecanum roller core (PETG)
3DP-D047 | Roller tread FR08 | wheel_fr | Mecanum roller tread (TPU 95A)
3DP-D048 | Roller core FR08 | wheel_fr | Mecanum roller core (PETG)
3DP-D049 | Roller tread FR01 | wheel_fr | Mecanum roller tread (TPU 95A)
3DP-D050 | Roller core FR01 | wheel_fr | Mecanum roller core (PETG)
3DP-D051 | Roller tread FR09 | wheel_fr | Mecanum roller tread (TPU 95A)
3DP-D052 | Roller core FR09 | wheel_fr | Mecanum roller core (PETG)
3DP-D053 | Roller tread FR00 | wheel_fr | Mecanum roller tread (TPU 95A)
3DP-D054 | Roller core FR00 | wheel_fr | Mecanum roller core (PETG)
3DP-D055 | Roller tread RL05 | wheel_rl | Mecanum roller tread (TPU 95A)
3DP-D056 | Roller core RL05 | wheel_rl | Mecanum roller core (PETG)
3DP-D057 | Roller tread RL06 | wheel_rl | Mecanum roller tread (TPU 95A)
3DP-D058 | Roller core RL06 | wheel_rl | Mecanum roller core (PETG)
3DP-D059 | Roller tread RL04 | wheel_rl | Mecanum roller tread (TPU 95A)
3DP-D060 | Roller core RL04 | wheel_rl | Mecanum roller core (PETG)
3DP-D061 | Roller tread RL07 | wheel_rl | Mecanum roller tread (TPU 95A)
3DP-D062 | Roller core RL07 | wheel_rl | Mecanum roller core (PETG)
3DP-D063 | Roller tread RL03 | wheel_rl | Mecanum roller tread (TPU 95A)
3DP-D064 | Roller core RL03 | wheel_rl | Mecanum roller core (PETG)
3DP-D065 | Wheel hub outboard RL | wheel_rl | Mecanum hub, outboard half
3DP-D066 | Wheel hub inboard + 116T RL | wheel_rl | Mecanum hub, inboard half + 116T pulley
3DP-D067 | Roller tread RL02 | wheel_rl | Mecanum roller tread (TPU 95A)
3DP-D068 | Roller tread RL08 | wheel_rl | Mecanum roller tread (TPU 95A)
3DP-D069 | Roller core RL02 | wheel_rl | Mecanum roller core (PETG)
3DP-D070 | Roller core RL08 | wheel_rl | Mecanum roller core (PETG)
3DP-D071 | Roller tread RL01 | wheel_rl | Mecanum roller tread (TPU 95A)
3DP-D072 | Roller core RL01 | wheel_rl | Mecanum roller core (PETG)
3DP-D073 | Roller tread RL09 | wheel_rl | Mecanum roller tread (TPU 95A)
3DP-D074 | Roller core RL09 | wheel_rl | Mecanum roller core (PETG)
3DP-D075 | Roller tread RL00 | wheel_rl | Mecanum roller tread (TPU 95A)
3DP-D076 | Roller core RL00 | wheel_rl | Mecanum roller core (PETG)
3DP-D077 | Roller tread RR05 | wheel_rr | Mecanum roller tread (TPU 95A)
3DP-D078 | Roller core RR05 | wheel_rr | Mecanum roller core (PETG)
3DP-D079 | Roller tread RR06 | wheel_rr | Mecanum roller tread (TPU 95A)
3DP-D080 | Roller core RR06 | wheel_rr | Mecanum roller core (PETG)
3DP-D081 | Roller tread RR04 | wheel_rr | Mecanum roller tread (TPU 95A)
3DP-D082 | Roller core RR04 | wheel_rr | Mecanum roller core (PETG)
3DP-D083 | Roller tread RR07 | wheel_rr | Mecanum roller tread (TPU 95A)
3DP-D084 | Roller core RR07 | wheel_rr | Mecanum roller core (PETG)
3DP-D085 | Roller tread RR03 | wheel_rr | Mecanum roller tread (TPU 95A)
3DP-D086 | Roller core RR03 | wheel_rr | Mecanum roller core (PETG)
3DP-D087 | Wheel hub inboard + 116T RR | wheel_rr | Mecanum hub, inboard half + 116T pulley
3DP-D088 | Wheel hub outboard RR | wheel_rr | Mecanum hub, outboard half
3DP-D089 | Roller tread RR02 | wheel_rr | Mecanum roller tread (TPU 95A)
3DP-D090 | Roller tread RR08 | wheel_rr | Mecanum roller tread (TPU 95A)
3DP-D091 | Roller core RR02 | wheel_rr | Mecanum roller core (PETG)
3DP-D092 | Roller core RR08 | wheel_rr | Mecanum roller core (PETG)
3DP-D093 | Roller tread RR01 | wheel_rr | Mecanum roller tread (TPU 95A)
3DP-D094 | Roller core RR01 | wheel_rr | Mecanum roller core (PETG)
3DP-D095 | Roller tread RR09 | wheel_rr | Mecanum roller tread (TPU 95A)
3DP-D096 | Roller core RR09 | wheel_rr | Mecanum roller core (PETG)
3DP-D097 | Roller tread RR00 | wheel_rr | Mecanum roller tread (TPU 95A)
3DP-D098 | Roller core RR00 | wheel_rr | Mecanum roller core (PETG)
3DP-E001 | Pivot bearing block L | chassis_pivot_drive_3_of_6 | Pivot bearing block
3DP-E002 | Pivot bearing block R | chassis_pivot_drive_3_of_6 | Pivot bearing block
3DP-E003 | Elevation motor bracket | chassis_pivot_drive_4_of_6 | Elevation motor bracket
3DP-E004 | Elevation pinion 16T | chassis_pivot_drive_5_of_6 | Elevation pinion 16T HTD 9 mm (8 mm REX bore)
3DP-E005 | Elevation pulley 112T ring | gun_pivots_2_of_3 | Elevation pulley 112T HTD 9 mm ring (printed)
3DP-F001 | Smoke collar | gun_pivots_3_of_3 | Smoke collar (printed, one piece)
3DP-F002 | Fog vent rear | power_electronics_smoke | Fog vent nozzle (under the belly)
3DP-F003 | Board tray Fog and light MOSFET module 2 | power_electronics_smoke | Printed board tray
3DP-F004 | Board tray Fog and light MOSFET module 3 | power_electronics_smoke | Printed board tray
3DP-F005 | Board tray Fog and light MOSFET module 5 | power_electronics_smoke | Printed board tray
3DP-F006 | Board tray Fog and light MOSFET module 1 | power_electronics_smoke | Printed board tray
3DP-F007 | Fog fluid tank | power_electronics_smoke | Fog fluid tank (printed, about 400 mL)
3DP-F008 | Board tray Fog and light MOSFET module 4 | power_electronics_smoke | Printed board tray
3DP-F009 | Smoke machine tray | power_electronics_smoke | Smoke machine tray
3DP-F010 | Fog splitter 1-3 | power_electronics_smoke | Fog splitter 1 -> 3 (printed)
3DP-F011 | Fog vent front | power_electronics_smoke | Fog vent nozzle (under bumper)
3DP-P001 | Chamber end cover top | gun_pivots_1_of_3 | Chamber end cover (printed)
3DP-P002 | Chamber end cover bottom | gun_pivots_1_of_3 | Chamber end cover (printed)
3DP-P003 | Chamber cap top rear | gun_pivots_1_of_3 | Chamber cap
3DP-P004 | Chamber saddle rear | gun_pivots_1_of_3 | Chamber saddle
3DP-P005 | Chamber cap bottom rear | gun_pivots_1_of_3 | Chamber cap
3DP-P006 | Chamber cap top -95 | gun_pivots_1_of_3 | Chamber cap
3DP-P007 | Chamber saddle -95 | gun_pivots_1_of_3 | Chamber saddle
3DP-P008 | Chamber cap bottom -95 | gun_pivots_1_of_3 | Chamber cap
3DP-P009 | Axle hub left | gun_pivots_2_of_3 | Axle hub
3DP-P010 | Axle spacer right | gun_pivots_2_of_3 | Axle spacer (printed)
3DP-P011 | Gun core left | gun_pivots_3_of_3 | Gun core half (valve blocks + breech block + mantlet, printed)
3DP-P012 | Gun core right | gun_pivots_3_of_3 | Gun core half (valve blocks + breech block + mantlet, printed)
3DP-P013 | Muzzle ring | gun_pivots_3_of_3 | Muzzle ring (printed, one piece, LED groove)
3DP-P014 | Tank saddle left -60 | pneumatics | Tank saddle
3DP-P015 | Tank saddle right -60 | pneumatics | Tank saddle
3DP-P016 | Tank saddle left 200 | pneumatics | Tank saddle
3DP-P017 | Tank saddle right 200 | pneumatics | Tank saddle
3DP-S001 | Speaker cup top right | lights_speakers_3_of_3 | Speaker cup
3DP-S002 | Speaker cup top left | lights_speakers_3_of_3 | Speaker cup
3DP-S003 | Speaker grille top left | lights_speakers_3_of_3 | Speaker grille
3DP-S004 | Speaker grille top right | lights_speakers_3_of_3 | Speaker grille
ABr-P01 | Breech adapter top | gun_pivots_3_of_3 | Breech puck (2.5D CNC from 1 in 6061 plate, 1 in NPT tap)
ABr-P02 | Breech adapter bottom | gun_pivots_3_of_3 | Breech puck (2.5D CNC from 1 in 6061 plate, 1 in NPT tap)
AEx-R01 | Rail 20x20 gun left | add_on_rails | 20x20 T-slot extrusion (owned spare, cut)
AEx-R02 | Rail 20x20 gun right | add_on_rails | 20x20 T-slot extrusion (owned spare, cut)
AEx-R03 | Rail 20x20 well left | add_on_rails | 20x20 T-slot extrusion (owned spare, cut)
AEx-R04 | Rail 20x20 well right | add_on_rails | 20x20 T-slot extrusion (owned spare, cut)
AEx-R05 | Rail 20x20 front upper | add_on_rails | 20x20 T-slot extrusion (owned spare, cut)
AEx-R06 | Rail 20x20 front lower | add_on_rails | 20x20 T-slot extrusion (owned spare, cut)
ASh-D01 | Corner gusset rear L top | chassis_pivot_drive_1_of_6 | Corner gusset top (1/8 Al, waterjet)
ASh-D02 | Corner gusset rear R top | chassis_pivot_drive_1_of_6 | Corner gusset top (1/8 Al, waterjet)
ASh-D03 | Corner gusset rear L bottom | chassis_pivot_drive_1_of_6 | Corner gusset bottom (1/8 Al, waterjet)
ASh-D04 | Corner gusset rear R bottom | chassis_pivot_drive_1_of_6 | Corner gusset bottom (1/8 Al, waterjet)
ASh-D05 | Arm knee short sled -320 front L | chassis_pivot_drive_1_of_6 | Arm knee short (1/8 Al, waterjet)
ASh-D06 | Arm knee short sled -320 front R | chassis_pivot_drive_1_of_6 | Arm knee short (1/8 Al, waterjet)
ASh-D07 | Inboard plate rear L | chassis_pivot_drive_2_of_6 | Inboard plate rear (1/8 Al, waterjet)
ASh-D08 | Inboard plate rear R | chassis_pivot_drive_2_of_6 | Inboard plate rear (1/8 Al, waterjet)
ASh-D09 | Arm knee sled -215 back L | chassis_pivot_drive_2_of_6 | Arm knee (1/8 Al, waterjet)
ASh-D10 | Arm knee sled -215 back R | chassis_pivot_drive_2_of_6 | Arm knee (1/8 Al, waterjet)
ASh-D11 | Arm knee sled -215 front L | chassis_pivot_drive_2_of_6 | Arm knee (1/8 Al, waterjet)
ASh-D12 | Arm knee sled -215 front R | chassis_pivot_drive_2_of_6 | Arm knee (1/8 Al, waterjet)
ASh-D13 | Side plate rear L | chassis_pivot_drive_2_of_6 | Side plate rear (1/8 Al, waterjet)
ASh-D14 | Side plate rear R | chassis_pivot_drive_2_of_6 | Side plate rear (1/8 Al, waterjet)
ASh-D15 | Arm knee tank -60 back L | chassis_pivot_drive_3_of_6 | Arm knee (1/8 Al, waterjet)
ASh-D16 | Arm knee tank -60 back R | chassis_pivot_drive_3_of_6 | Arm knee (1/8 Al, waterjet)
ASh-D17 | Inboard plate rear tank L | chassis_pivot_drive_3_of_6 | Inboard plate rear tank (1/8 Al, waterjet)
ASh-D18 | Inboard plate rear tank R | chassis_pivot_drive_3_of_6 | Inboard plate rear tank (1/8 Al, waterjet)
ASh-D19 | Arm knee tank -60 front L | chassis_pivot_drive_4_of_6 | Arm knee (1/8 Al, waterjet)
ASh-D20 | Arm knee tank -60 front R | chassis_pivot_drive_4_of_6 | Arm knee (1/8 Al, waterjet)
ASh-D21 | Bellypan | chassis_pivot_drive_4_of_6 | Bellypan (1/8 Al, CNC router, one piece)
ASh-D22 | Rail spacer strip L | chassis_pivot_drive_5_of_6 | Rail spacer strip (1/8 Al, waterjet)
ASh-D23 | Rail spacer strip R | chassis_pivot_drive_5_of_6 | Rail spacer strip (1/8 Al, waterjet)
ASh-D24 | Side plate front L | chassis_pivot_drive_5_of_6 | Side plate front (1/8 Al, waterjet)
ASh-D25 | Side plate front R | chassis_pivot_drive_5_of_6 | Side plate front (1/8 Al, waterjet)
ASh-D26 | Arm knee tank 200 back L | chassis_pivot_drive_5_of_6 | Arm knee (1/8 Al, waterjet)
ASh-D27 | Arm knee tank 200 back R | chassis_pivot_drive_5_of_6 | Arm knee (1/8 Al, waterjet)
ASh-D28 | Inboard plate front tank L | chassis_pivot_drive_5_of_6 | Inboard plate front tank (1/8 Al, waterjet)
ASh-D29 | Inboard plate front tank R | chassis_pivot_drive_5_of_6 | Inboard plate front tank (1/8 Al, waterjet)
ASh-D30 | Arm knee tank 200 front L | chassis_pivot_drive_5_of_6 | Arm knee (1/8 Al, waterjet)
ASh-D31 | Arm knee tank 200 front R | chassis_pivot_drive_6_of_6 | Arm knee (1/8 Al, waterjet)
ASh-D32 | Corner gusset front L top | chassis_pivot_drive_6_of_6 | Corner gusset top (1/8 Al, waterjet)
ASh-D33 | Corner gusset front R top | chassis_pivot_drive_6_of_6 | Corner gusset top (1/8 Al, waterjet)
ASh-D34 | Corner gusset front L bottom | chassis_pivot_drive_6_of_6 | Corner gusset bottom (1/8 Al, waterjet)
ASh-D35 | Corner gusset front R bottom | chassis_pivot_drive_6_of_6 | Corner gusset bottom (1/8 Al, waterjet)
ASh-D36 | Wheel plate inner (1/8 Al) FL | wheel_fl | Mecanum inner plate (1/8 Al)
ASh-D37 | Wheel plate centre (1/8 Al) FL | wheel_fl | Mecanum centre plate (1/8 Al)
ASh-D38 | Wheel plate outer (1/8 Al) FL | wheel_fl | Mecanum outer plate (1/8 Al)
ASh-D39 | Wheel plate inner (1/8 Al) FR | wheel_fr | Mecanum inner plate (1/8 Al)
ASh-D40 | Wheel plate centre (1/8 Al) FR | wheel_fr | Mecanum centre plate (1/8 Al)
ASh-D41 | Wheel plate outer (1/8 Al) FR | wheel_fr | Mecanum outer plate (1/8 Al)
ASh-D42 | Wheel plate inner (1/8 Al) RL | wheel_rl | Mecanum inner plate (1/8 Al)
ASh-D43 | Wheel plate centre (1/8 Al) RL | wheel_rl | Mecanum centre plate (1/8 Al)
ASh-D44 | Wheel plate outer (1/8 Al) RL | wheel_rl | Mecanum outer plate (1/8 Al)
ASh-D45 | Wheel plate inner (1/8 Al) RR | wheel_rr | Mecanum inner plate (1/8 Al)
ASh-D46 | Wheel plate centre (1/8 Al) RR | wheel_rr | Mecanum centre plate (1/8 Al)
ASh-D47 | Wheel plate outer (1/8 Al) RR | wheel_rr | Mecanum outer plate (1/8 Al)
ASh-E01 | Tower plate L | chassis_pivot_drive_3_of_6 | Tower plate (1/8 Al, waterjet)
ASh-E02 | Tower plate R | chassis_pivot_drive_3_of_6 | Tower plate (1/8 Al, waterjet)
ASh-F01 | Fog heater bracket (1/8 Al) | power_electronics_smoke | Fog heater bracket (1/8 Al)
ASh-P01 | Cradle plate left (1/8 Al) | gun_pivots_2_of_3 | Gun cradle plate (1/8 Al, CNC router)
ASh-P02 | Cradle plate right (1/8 Al) | gun_pivots_2_of_3 | Gun cradle plate (1/8 Al, CNC router)
ATu-D01 | End rail rear (1x2) | chassis_pivot_drive_1_of_6 | Aluminum box tube 1x2 x 1/16 wall (owned)
ATu-D02 | Sled post left -320 (1x1) | chassis_pivot_drive_1_of_6 | Aluminum box tube 1x1 x 1/16 wall (owned)
ATu-D03 | Sled rail left -320 (1x1) | chassis_pivot_drive_1_of_6 | Aluminum box tube 1x1 x 1/16 wall (owned)
ATu-D04 | Sled post right -320 (1x1) | chassis_pivot_drive_1_of_6 | Aluminum box tube 1x1 x 1/16 wall (owned)
ATu-D05 | Sled rail right -320 (1x1) | chassis_pivot_drive_1_of_6 | Aluminum box tube 1x1 x 1/16 wall (owned)
ATu-D06 | Sled post left -215 (1x1) | chassis_pivot_drive_2_of_6 | Aluminum box tube 1x1 x 1/16 wall (owned)
ATu-D07 | Sled rail left -215 (1x1) | chassis_pivot_drive_2_of_6 | Aluminum box tube 1x1 x 1/16 wall (owned)
ATu-D08 | Sled post right -215 (1x1) | chassis_pivot_drive_2_of_6 | Aluminum box tube 1x1 x 1/16 wall (owned)
ATu-D09 | Sled rail right -215 (1x1) | chassis_pivot_drive_2_of_6 | Aluminum box tube 1x1 x 1/16 wall (owned)
ATu-D10 | Tank post left -60 (1x1) | chassis_pivot_drive_3_of_6 | Aluminum box tube 1x1 x 1/16 wall (owned)
ATu-D11 | Tank arm left -60 (1x1) | chassis_pivot_drive_3_of_6 | Aluminum box tube 1x1 x 1/16 wall (owned)
ATu-D12 | Tank post right -60 (1x1) | chassis_pivot_drive_3_of_6 | Aluminum box tube 1x1 x 1/16 wall (owned)
ATu-D13 | Tank arm right -60 (1x1) | chassis_pivot_drive_3_of_6 | Aluminum box tube 1x1 x 1/16 wall (owned)
ATu-D14 | Outer rail L (1x2) | chassis_pivot_drive_4_of_6 | Aluminum box tube 1x2 x 1/16 wall (owned)
ATu-D15 | Inner rail L (1x2) | chassis_pivot_drive_4_of_6 | Aluminum box tube 1x2 x 1/16 wall (owned)
ATu-D16 | Outer rail R (1x2) | chassis_pivot_drive_4_of_6 | Aluminum box tube 1x2 x 1/16 wall (owned)
ATu-D17 | Inner rail R (1x2) | chassis_pivot_drive_4_of_6 | Aluminum box tube 1x2 x 1/16 wall (owned)
ATu-D18 | Tank post left 200 (1x1) | chassis_pivot_drive_5_of_6 | Aluminum box tube 1x1 x 1/16 wall (owned)
ATu-D19 | Tank arm left 200 (1x1) | chassis_pivot_drive_5_of_6 | Aluminum box tube 1x1 x 1/16 wall (owned)
ATu-D20 | Tank post right 200 (1x1) | chassis_pivot_drive_5_of_6 | Aluminum box tube 1x1 x 1/16 wall (owned)
ATu-D21 | Tank arm right 200 (1x1) | chassis_pivot_drive_5_of_6 | Aluminum box tube 1x1 x 1/16 wall (owned)
ATu-D22 | End rail front (1x2) | chassis_pivot_drive_6_of_6 | Aluminum box tube 1x2 x 1/16 wall (owned)
ATu-E01 | Turret tower L (1x1) | chassis_pivot_drive_3_of_6 | Aluminum box tube 1x1 x 1/16 wall (owned)
ATu-E02 | Turret tower R (1x1) | chassis_pivot_drive_3_of_6 | Aluminum box tube 1x1 x 1/16 wall (owned)
Acr-B01 | Panel 07 | body_panels_clips | Frosted acrylic panel 1/8 in (owned)
Acr-B02 | Panel 06 (battery door) | body_panels_clips | Frosted acrylic panel 1/8 in (owned)
Acr-B03 | Panel 02 (battery door) | body_panels_clips | Frosted acrylic panel 1/8 in (owned)
Acr-B04 | Panel 03 | body_panels_clips | Frosted acrylic panel 1/8 in (owned)
Acr-B05 | Panel 04 | body_panels_clips | Frosted acrylic panel 1/8 in (owned)
Acr-B06 | Panel 01 | body_panels_clips | Frosted acrylic panel 1/8 in (owned)
Acr-B07 | Panel 05 | body_panels_clips | Frosted acrylic panel 1/8 in (owned)
Acr-B08 | Panel 00 | body_panels_clips | Frosted acrylic panel 1/8 in (owned)
B15-1 | Bumper backing rear | bumpers_wall_standoffs | Bumper backing, 1x6 ripped to 5 in (3/4 x 5 in)
B15-2 | Bumper backing left | bumpers_wall_standoffs | Bumper backing, 1x6 ripped to 5 in (3/4 x 5 in)
B15-3 | Bumper backing right | bumpers_wall_standoffs | Bumper backing, 1x6 ripped to 5 in (3/4 x 5 in)
B15-4 | Bumper backing front | bumpers_wall_standoffs | Bumper backing, 1x6 ripped to 5 in (3/4 x 5 in)
B17-1 | Bumper foam rear | bumpers_wall_standoffs | Bumper foam strip 2 x 5 in (GoTo Foam 43 ILD)
B17-2 | Bumper foam left | bumpers_wall_standoffs | Bumper foam strip 2 x 5 in (GoTo Foam 43 ILD)
B17-3 | Bumper foam right | bumpers_wall_standoffs | Bumper foam strip 2 x 5 in (GoTo Foam 43 ILD)
B17-4 | Bumper foam front | bumpers_wall_standoffs | Bumper foam strip 2 x 5 in (GoTo Foam 43 ILD)
B18-1 | Bumper cover rear | bumpers_wall_standoffs | Bumper fabric cover (white canvas, owner's pick)
B18-2 | Bumper cover left | bumpers_wall_standoffs | Bumper fabric cover (white canvas, owner's pick)
B18-3 | Bumper cover right | bumpers_wall_standoffs | Bumper fabric cover (white canvas, owner's pick)
B18-4 | Bumper cover front | bumpers_wall_standoffs | Bumper fabric cover (white canvas, owner's pick)
C01-1 | Charge port (SB50 panel mount) | power_electronics_smoke | Anderson SB50 panel-mount charge port
C02-1 | Main controller ESP32-P4 + C6 (Waveshare) | power_electronics_smoke | Main controller: Waveshare ESP32-P4-Module-DEV-KIT, ESP32-P4 + ESP32-C6 (B0FDWZ6KWT)
C03-1 | ADS1115 ADC 1 (pressures) | power_electronics_smoke | ADS1115 16-bit 4-channel ADC module, I2C, 2-pack (B0DZSP4CG8)
C03-2 | ADS1115 ADC 2 (battery and bus volts) | power_electronics_smoke | ADS1115 16-bit 4-channel ADC module, I2C, 2-pack (B0DZSP4CG8)
C04-1 | PWM expander PCA9685 | power_electronics_smoke | PWM expander: PCA9685 16-channel, I2C (Dorhea B07RMTN4NZ)
C06-1 | Valve arm relay 40 A | power_electronics_smoke | 12 V 40 A SPDT relay + socket
C06-2 | Fog relay 40 A core 1 | power_electronics_smoke | 12 V 40 A SPDT relay + socket (fog core)
C06-3 | Fog relay 40 A core 2 | power_electronics_smoke | 12 V 40 A SPDT relay + socket (fog core, spare)
C07-1 | Relay driver board (ULN2803A) | power_electronics_smoke | ULN2803A Darlington driver on a perfboard: the relay coils
C08-1 | PDH contactor 200 A | power_electronics_smoke | Contactor + battery relays: 12 V 200 A continuous duty, isolated coil, 4-pin (B0D97PSZBB)
C08-2 | Battery relay A 200 A | power_electronics_smoke | Contactor + battery relays: 12 V 200 A continuous duty, isolated coil, 4-pin (B0D97PSZBB)
C08-3 | Battery relay B 200 A | power_electronics_smoke | Contactor + battery relays: 12 V 200 A continuous duty, isolated coil, 4-pin (B0D97PSZBB)
C10-1 | Logic supply 5 V (buck-boost) | power_electronics_smoke | Logic supply: 5 V 5 A buck-boost module, 3.6-32 V in
C12-1 | USB-C panel pass-through | power_electronics_smoke | Panel-mount USB-C extension (to the main controller)
C14-1 | FRC battery left | power_electronics_smoke | FRC 12 V 18 Ah battery (owned, MK ES17-12)
C14-2 | FRC battery right | power_electronics_smoke | FRC 12 V 18 Ah battery (owned, MK ES17-12)
C15-1 | Main breaker 120 A | power_electronics_smoke | 120 A main breaker (stash)
C15-2 | Power distribution (REV PDH) | power_electronics_smoke | REV PDH (owned) + ATO breakers / fuses (stash)
C15-3 | Anderson SB50 left | power_electronics_smoke | Anderson SB50 pair + 6 AWG contacts (stash)
C15-4 | Anderson SB50 right | power_electronics_smoke | Anderson SB50 pair + 6 AWG contacts (stash)
C16-1 | ESP32-S3 safety node | power_electronics_smoke | ESP32-S3-DevKitC-1 N8R8 (owned)
C17-1 | Inline ATO fuse holder (logic tap) | power_electronics_smoke | Inline ATO fuse holder + 5 A fuse
D01-1 | Falcon 500 RL | chassis_pivot_drive_3_of_6 | Falcon 500 (owned)
D01-2 | Falcon 500 RR | chassis_pivot_drive_3_of_6 | Falcon 500 (owned)
D01-3 | Falcon 500 FL | chassis_pivot_drive_5_of_6 | Falcon 500 (owned)
D01-4 | Falcon 500 FR | chassis_pivot_drive_5_of_6 | Falcon 500 (owned)
D02-1 | Falcon pulley 12T RL | chassis_pivot_drive_3_of_6 | WCP-0319 12T HTD 15 mm Falcon pulley
D02-2 | Falcon pulley 12T RR | chassis_pivot_drive_3_of_6 | WCP-0319 12T HTD 15 mm Falcon pulley
D02-3 | Falcon pulley 12T FL | chassis_pivot_drive_5_of_6 | WCP-0319 12T HTD 15 mm Falcon pulley
D02-4 | Falcon pulley 12T FR | chassis_pivot_drive_5_of_6 | WCP-0319 12T HTD 15 mm Falcon pulley
D04-1 | Bearing hex wheel RL outer | chassis_pivot_drive_1_of_6 | Flanged bearing 1/2 hex bore, 1.125 OD (WCP-0783)
D04-2 | Bearing hex wheel RL inner | chassis_pivot_drive_1_of_6 | Flanged bearing 1/2 hex bore, 1.125 OD (WCP-0783)
D04-3 | Bearing hex wheel RR outer | chassis_pivot_drive_1_of_6 | Flanged bearing 1/2 hex bore, 1.125 OD (WCP-0783)
D04-4 | Bearing hex wheel RR inner | chassis_pivot_drive_2_of_6 | Flanged bearing 1/2 hex bore, 1.125 OD (WCP-0783)
D04-5 | Pivot bearing L 109 | chassis_pivot_drive_4_of_6 | Flanged bearing 1/2 hex bore, 1.125 OD (WCP-0783)
D04-6 | Pivot bearing L 129 | chassis_pivot_drive_4_of_6 | Flanged bearing 1/2 hex bore, 1.125 OD (WCP-0783)
D04-7 | Pivot bearing R 109 | chassis_pivot_drive_4_of_6 | Flanged bearing 1/2 hex bore, 1.125 OD (WCP-0783)
D04-8 | Pivot bearing R 129 | chassis_pivot_drive_4_of_6 | Flanged bearing 1/2 hex bore, 1.125 OD (WCP-0783)
D04-9 | Bearing hex wheel FL outer | chassis_pivot_drive_6_of_6 | Flanged bearing 1/2 hex bore, 1.125 OD (WCP-0783)
D04-10 | Bearing hex wheel FL inner | chassis_pivot_drive_6_of_6 | Flanged bearing 1/2 hex bore, 1.125 OD (WCP-0783)
D04-11 | Bearing hex wheel FR outer | chassis_pivot_drive_6_of_6 | Flanged bearing 1/2 hex bore, 1.125 OD (WCP-0783)
D04-12 | Bearing hex wheel FR inner | chassis_pivot_drive_6_of_6 | Flanged bearing 1/2 hex bore, 1.125 OD (WCP-0783)
D05-1 | Wheel axle RL (1/2 hex) | chassis_pivot_drive_1_of_6 | 1/2 in hex shaft, wheel axle (6 in)
D05-2 | Wheel axle RR (1/2 hex) | chassis_pivot_drive_2_of_6 | 1/2 in hex shaft, wheel axle (6 in)
D05-3 | Wheel axle FL (1/2 hex) | chassis_pivot_drive_6_of_6 | 1/2 in hex shaft, wheel axle (6 in)
D05-4 | Wheel axle FR (1/2 hex) | chassis_pivot_drive_6_of_6 | 1/2 in hex shaft, wheel axle (6 in)
D05-5 | Pivot axle stub left (1/2 hex) | gun_pivots_2_of_3 | 1/2 in hex shaft, steel (pivot stub)
D05-6 | Pivot axle stub right (1/2 hex) | gun_pivots_2_of_3 | 1/2 in hex shaft, steel (pivot stub)
D06-1 | Belt 140T RL | chassis_pivot_drive_2_of_6 | HTD 5M 15 mm belt, 140T (WCP)
D06-2 | Belt 140T RR | chassis_pivot_drive_2_of_6 | HTD 5M 15 mm belt, 140T (WCP)
D06-3 | Belt 140T FL | chassis_pivot_drive_6_of_6 | HTD 5M 15 mm belt, 140T (WCP)
D06-4 | Belt 140T FR | chassis_pivot_drive_6_of_6 | HTD 5M 15 mm belt, 140T (WCP)
E01-1 | Elevation belt | chassis_pivot_drive_4_of_6 | HTD 5M 9 mm belt, 150T
E02-1 | Elevation motor goBILDA 5203 19.2:1 | chassis_pivot_drive_4_of_6 | goBILDA 5203-2402-0019 Yellow Jacket 19.2:1, 312 rpm (FTC motor)
E03-1 | Spark MAX (elevation) | power_electronics_smoke | REV Spark MAX (owned)
E04-1 | Arm-angle pot | chassis_pivot_drive_4_of_6 | 10k linear pot, 1/4 in shaft (arm angle)
F01-1 | Fog heater core L | power_electronics_smoke | Fog heater core 12 V 200 W (cast, 97 x 32 x 36 mm)
F02-1 | Fog pump L | power_electronics_smoke | Fog fluid pump: Kamoer NKP 12 V peristaltic
F03-1 | Thermocouple amp MAX6675 | power_electronics_smoke | Thermocouple amp MAX6675 module (+ K probe on the core)
F05-1 | DS18B20 probe battery bay | power_electronics_smoke | DS18B20 waterproof temperature probe
F05-2 | DS18B20 probe electronics | power_electronics_smoke | DS18B20 waterproof temperature probe
F05-3 | DS18B20 probe fogger | power_electronics_smoke | DS18B20 waterproof temperature probe
F07-1 | Fog blower 5015 | power_electronics_smoke | 12 V 5015 blower
F10-1 | Gun smoke tube | gun_pivots_3_of_3 | Silicone tube 3/4 ID x 1 OD (ft)
F10-2 | Fog loop (to gun) | power_electronics_smoke | Silicone tube 3/4 ID x 1 OD (ft)
F11-1 | Fog and light MOSFET module 2 (fog heater) | power_electronics_smoke | MOSFET switch module 5-36 V 15 A with heat sink (light bar / fog)
F11-2 | Fog and light MOSFET module 3 (fog heater 2) | power_electronics_smoke | MOSFET switch module 5-36 V 15 A with heat sink (light bar / fog)
F11-3 | Fog and light MOSFET module 5 (fog blower) | power_electronics_smoke | MOSFET switch module 5-36 V 15 A with heat sink (light bar / fog)
F11-4 | Fog and light MOSFET module 1 (light bar) | power_electronics_smoke | MOSFET switch module 5-36 V 15 A with heat sink (light bar / fog)
F11-5 | Fog and light MOSFET module 4 (fog pump) | power_electronics_smoke | MOSFET switch module 5-36 V 15 A with heat sink (light bar / fog)
F12-1 | Fog tube rear | power_electronics_smoke | Fog tube (owner's flexible tube)
F12-2 | Fog tube front | power_electronics_smoke | Fog tube (owner's flexible tube)
F13-1 | Fog bracket standoff 282 -54 | power_electronics_smoke | M5 aluminum standoff (stash)
F13-2 | Fog bracket standoff 282 54 | power_electronics_smoke | M5 aluminum standoff (stash)
F13-3 | Fog bracket standoff 342 -54 | power_electronics_smoke | M5 aluminum standoff (stash)
F13-4 | Fog bracket standoff 342 54 | power_electronics_smoke | M5 aluminum standoff (stash)
L01-1 | LED strip frame E39 | lights_speakers_1_of_3 | WS2812B strip 5 mm, 100/m (m)
L01-2 | LED strip frame E20 | lights_speakers_1_of_3 | WS2812B strip 5 mm, 100/m (m)
L01-3 | LED strip frame E37 | lights_speakers_1_of_3 | WS2812B strip 5 mm, 100/m (m)
L01-4 | LED strip frame E38 | lights_speakers_1_of_3 | WS2812B strip 5 mm, 100/m (m)
L01-5 | LED strip frame E40 | lights_speakers_1_of_3 | WS2812B strip 5 mm, 100/m (m)
L01-6 | LED strip frame E24 | lights_speakers_1_of_3 | WS2812B strip 5 mm, 100/m (m)
L01-7 | LED strip frame E29 | lights_speakers_1_of_3 | WS2812B strip 5 mm, 100/m (m)
L01-8 | LED strip frame E21 | lights_speakers_1_of_3 | WS2812B strip 5 mm, 100/m (m)
L01-9 | LED strip frame E36 | lights_speakers_1_of_3 | WS2812B strip 5 mm, 100/m (m)
L01-10 | LED strip frame E28 | lights_speakers_1_of_3 | WS2812B strip 5 mm, 100/m (m)
L01-11 | LED strip frame E19 | lights_speakers_1_of_3 | WS2812B strip 5 mm, 100/m (m)
L01-12 | LED strip frame E17 | lights_speakers_1_of_3 | WS2812B strip 5 mm, 100/m (m)
L01-13 | LED strip frame E35 | lights_speakers_1_of_3 | WS2812B strip 5 mm, 100/m (m)
L01-14 | LED strip frame E23 | lights_speakers_2_of_3 | WS2812B strip 5 mm, 100/m (m)
L01-15 | LED strip frame E25 | lights_speakers_2_of_3 | WS2812B strip 5 mm, 100/m (m)
L01-16 | LED strip frame E27 | lights_speakers_2_of_3 | WS2812B strip 5 mm, 100/m (m)
L01-17 | LED strip frame E16 | lights_speakers_2_of_3 | WS2812B strip 5 mm, 100/m (m)
L01-18 | LED strip frame E32 | lights_speakers_2_of_3 | WS2812B strip 5 mm, 100/m (m)
L01-19 | LED strip frame E13 | lights_speakers_2_of_3 | WS2812B strip 5 mm, 100/m (m)
L01-20 | LED strip frame E14 | lights_speakers_2_of_3 | WS2812B strip 5 mm, 100/m (m)
L01-21 | LED strip frame E31 | lights_speakers_2_of_3 | WS2812B strip 5 mm, 100/m (m)
L01-22 | LED strip frame E18 | lights_speakers_2_of_3 | WS2812B strip 5 mm, 100/m (m)
L01-23 | LED strip frame E34 | lights_speakers_2_of_3 | WS2812B strip 5 mm, 100/m (m)
L01-24 | LED strip frame E22 | lights_speakers_2_of_3 | WS2812B strip 5 mm, 100/m (m)
L01-25 | LED strip frame E26 | lights_speakers_3_of_3 | WS2812B strip 5 mm, 100/m (m)
L01-26 | LED strip frame E09 | lights_speakers_3_of_3 | WS2812B strip 5 mm, 100/m (m)
L01-27 | LED strip frame E06 | lights_speakers_3_of_3 | WS2812B strip 5 mm, 100/m (m)
L01-28 | LED strip frame E00 | lights_speakers_3_of_3 | WS2812B strip 5 mm, 100/m (m)
L01-29 | LED strip frame E02 | lights_speakers_3_of_3 | WS2812B strip 5 mm, 100/m (m)
L01-30 | LED strip frame E04 | lights_speakers_3_of_3 | WS2812B strip 5 mm, 100/m (m)
L02-1 | LED strip underglow rear | lights_speakers_1_of_3 | WS2812B strip 10 mm, 60/m (m)
L02-2 | LED loop panel 07 | lights_speakers_1_of_3 | WS2812B strip 10 mm, 60/m (m)
L02-3 | LED loop panel 06 | lights_speakers_1_of_3 | WS2812B strip 10 mm, 60/m (m)
L02-4 | LED loop panel 02 | lights_speakers_1_of_3 | WS2812B strip 10 mm, 60/m (m)
L02-5 | LED loop panel 03 | lights_speakers_2_of_3 | WS2812B strip 10 mm, 60/m (m)
L02-6 | LED loop panel 04 | lights_speakers_2_of_3 | WS2812B strip 10 mm, 60/m (m)
L02-7 | LED strip underglow left | lights_speakers_2_of_3 | WS2812B strip 10 mm, 60/m (m)
L02-8 | LED strip underglow right | lights_speakers_2_of_3 | WS2812B strip 10 mm, 60/m (m)
L02-9 | LED loop panel 01 | lights_speakers_2_of_3 | WS2812B strip 10 mm, 60/m (m)
L02-10 | LED loop panel 05 | lights_speakers_2_of_3 | WS2812B strip 10 mm, 60/m (m)
L02-11 | LED loop panel 00 | lights_speakers_3_of_3 | WS2812B strip 10 mm, 60/m (m)
L02-12 | LED strip underglow front | lights_speakers_3_of_3 | WS2812B strip 10 mm, 60/m (m)
L03-1 | LED light bar front | lights_speakers_3_of_3 | Front light bar: Zmoon 12 in single-row LED bar, 72 W spot/flood combo, 12/24 V
L03-2 | Light bar bracket left | lights_speakers_3_of_3 | Light bar end bracket (comes with the bar)
L03-3 | Light bar bracket right | lights_speakers_3_of_3 | Light bar end bracket (comes with the bar)
L04-1 | Buck 12-5 V 20 A | power_electronics_smoke | 12->5 V 20 A buck (B089M5R3NJ)
P01-1 | Air tank right (6 L 200 psi) | pneumatics | Air tank 6 L / 1.6 gal, 200 psi, 1/4 NPT (owner's AliExpress pick)
P01-2 | Air tank left (6 L 200 psi) | pneumatics | Air tank 6 L / 1.6 gal, 200 psi, 1/4 NPT (owner's AliExpress pick)
P02-1 | Line relief valve 200 psi | pneumatics | Relief valve 200 psi, 1/4 NPT male, ASME, ring pull, brass (Loner ST25-1A200, B0F4QP9CG2)
P02-2 | Chamber relief valve 200 psi B (bottom cannon) | pneumatics | Relief valve 200 psi, 1/4 NPT male, ASME, ring pull, brass (Loner ST25-1A200, B0F4QP9CG2)
P02-3 | Chamber relief valve 200 psi A (top cannon) | pneumatics | Relief valve 200 psi, 1/4 NPT male, ASME, ring pull, brass (Loner ST25-1A200, B0F4QP9CG2)
P03-1 | Chamber transducer B (bottom cannon) | pneumatics | Pressure transducer 0-300 psi, 0.5-4.5 V, 1/8 NPT (+ 1/4 x 1/8 bushing)
P03-2 | Chamber transducer A (top cannon) | pneumatics | Pressure transducer 0-300 psi, 0.5-4.5 V, 1/8 NPT (+ 1/4 x 1/8 bushing)
P03-3 | Tank transducer 0-300 psi | pneumatics | Pressure transducer 0-300 psi, 0.5-4.5 V, 5 V, 1/8 NPT, stainless, with plug cable
P05-1 | Fill plug (M-style, female) | pneumatics | Fill plug: 1/4 NPT female-thread M-style plug, brass (ZKZX B081F9J3VF)
P06-1 | Fill check valve | pneumatics | Fill check valve, 304 stainless, 1/4 NPT male x male (AliExpress)
P07-1 | In valve B (bottom cannon) | pneumatics | In valve: GOGO GPG-M03 2/2 NC direct-acting 12 V DC, G1/4, 2.5 mm
P07-2 | In valve A (top cannon) | pneumatics | In valve: GOGO GPG-M03 2/2 NC direct-acting 12 V DC, G1/4, 2.5 mm
P08-1 | In valve B (bottom cannon) inlet nipple | pneumatics | G1/4 BSPP male x 1/4 NPT male hex nipple, 304
P08-2 | In valve B (bottom cannon) outlet nipple | pneumatics | G1/4 BSPP male x 1/4 NPT male hex nipple, 304
P08-3 | In valve A (top cannon) inlet nipple | pneumatics | G1/4 BSPP male x 1/4 NPT male hex nipple, 304
P08-4 | In valve A (top cannon) outlet nipple | pneumatics | G1/4 BSPP male x 1/4 NPT male hex nipple, 304
P10-1 | Rear manifold cross | pneumatics | 1/4 NPT brass cross (ChillWaves)
P10-2 | Valve cross | pneumatics | 1/4 NPT brass cross (ChillWaves)
P10-3 | Chamber cross B (bottom cannon) | pneumatics | 1/4 NPT brass cross (ChillWaves)
P10-4 | Chamber cross A (top cannon) | pneumatics | 1/4 NPT brass cross (ChillWaves)
P11-1 | Main valve nipple | pneumatics | 1/4 NPT brass close nipple
P14-1 | Tank plug left -80 | pneumatics | 1/4 NPT brass plug
P14-2 | Tank plug right -80 | pneumatics | 1/4 NPT brass plug
P14-3 | Tank plug left 80 | pneumatics | 1/4 NPT brass plug
P16-1 | Gun tube bottom | gun_pivots_2_of_3 | DOT nylon tube 1/4 OD (ft)
P16-2 | Gun tube top | gun_pivots_2_of_3 | DOT nylon tube 1/4 OD (ft)
P16-3 | Tube main valve to cross | pneumatics | DOT nylon tube 1/4 OD (ft)
P16-4 | Service loop B (bottom cannon) | pneumatics | DOT nylon tube 1/4 OD (ft)
P16-5 | Tube tank left | pneumatics | DOT nylon tube 1/4 OD (ft)
P16-6 | Tube tank right | pneumatics | DOT nylon tube 1/4 OD (ft)
P16-7 | Service loop A (top cannon) | pneumatics | DOT nylon tube 1/4 OD (ft)
P17-1 | Chamber inlet push-to-connect top | gun_pivots_1_of_3 | DOT push-to-connect 1/4 tube x 1/4 NPT (Boeray)
P17-2 | Chamber inlet push-to-connect bottom | gun_pivots_2_of_3 | DOT push-to-connect 1/4 tube x 1/4 NPT (Boeray)
P17-3 | Rear manifold push-to-connect right tank | pneumatics | DOT push-to-connect 1/4 tube x 1/4 NPT (Boeray)
P17-4 | Rear manifold push-to-connect left tank | pneumatics | DOT push-to-connect 1/4 tube x 1/4 NPT (Boeray)
P17-5 | Valve cross push-to-connect | pneumatics | DOT push-to-connect 1/4 tube x 1/4 NPT (Boeray)
P17-6 | Chamber cross B (bottom cannon) push-to-connect | pneumatics | DOT push-to-connect 1/4 tube x 1/4 NPT (Boeray)
P17-7 | Main valve push-to-connect | pneumatics | DOT push-to-connect 1/4 tube x 1/4 NPT (Boeray)
P17-8 | Chamber cross A (top cannon) push-to-connect | pneumatics | DOT push-to-connect 1/4 tube x 1/4 NPT (Boeray)
P17-9 | Tank push-to-connect left | pneumatics | DOT push-to-connect 1/4 tube x 1/4 NPT (Boeray)
P17-10 | Tank push-to-connect right | pneumatics | DOT push-to-connect 1/4 tube x 1/4 NPT (Boeray)
P20-1 | Tank strap left 6 | pneumatics | 1 in cam-buckle strap
P20-2 | Tank strap right 6 | pneumatics | 1 in cam-buckle strap
P20-3 | Tank strap left 86 | pneumatics | 1 in cam-buckle strap
P20-4 | Tank strap right 86 | pneumatics | 1 in cam-buckle strap
P21-1 | Main valve (1/4 ball valve) | pneumatics | Main valve: 1/4 NPT brass ball valve, FNPT x FNPT, 600 WOG (the old cannon's if it fits)
P23-1 | Firing valve top (U.S. Solid USS-HSV04) | gun_pivots_3_of_3 | Firing valve top: U.S. Solid USS-HSV04 1 in NPT, 12 V DC, NC, pilot, 725 psi
P23-2 | Firing valve bottom (U.S. Solid USS-HSV04) | gun_pivots_3_of_3 | Firing valve bottom: U.S. Solid USS-HSV04 1 in NPT, 12 V DC, NC, pilot, 725 psi
P24-1 | Chamber back disc top | gun_pivots_1_of_3 | Chamber end disc: 3/8 in A36, 3.5 in OD (waterjet)
P24-2 | Chamber back disc bottom | gun_pivots_1_of_3 | Chamber end disc: 3/8 in A36, 3.5 in OD (waterjet)
P24-3 | Chamber front disc top | gun_pivots_2_of_3 | Chamber end disc: 3/8 in A36, 3.5 in OD (waterjet)
P24-4 | Chamber front disc bottom | gun_pivots_2_of_3 | Chamber end disc: 3/8 in A36, 3.5 in OD (waterjet)
P25-1 | Chamber pipe top | gun_pivots_1_of_3 | Chamber: 3 in Sch 40 steel pipe, plain end (cut)
P25-2 | Chamber pipe bottom | gun_pivots_1_of_3 | Chamber: 3 in Sch 40 steel pipe, plain end (cut)
P26-1 | Chamber inlet bung top | gun_pivots_1_of_3 | Chamber inlet: 1/4 NPT female steel weld-on bung
P26-2 | Chamber inlet bung bottom | gun_pivots_2_of_3 | Chamber inlet: 1/4 NPT female steel weld-on bung
P27-1 | top nipple 1x1.50 | gun_pivots_3_of_3 | 1 in NPT close nipple (1-1/2 in), seamless steel, Sch 80
P27-2 | bottom nipple 1x1.50 | gun_pivots_3_of_3 | 1 in NPT close nipple (1-1/2 in), seamless steel, Sch 80
P28-1 | Chamber outlet nipple top | gun_pivots_2_of_3 | Chamber outlet: 1 in TOE nipple (half of a 1 x 4 in black nipple), welded through the front disc
P28-2 | Chamber outlet nipple bottom | gun_pivots_3_of_3 | Chamber outlet: 1 in TOE nipple (half of a 1 x 4 in black nipple), welded through the front disc
P30-1 | Valve MOSFET module 2 (firing valve B) | power_electronics_smoke | MOSFET switch module 5-36 V 15 A, 3.3-20 V trigger (valve / contactor driver)
P30-2 | Valve MOSFET module 3 (in valve A) | power_electronics_smoke | MOSFET switch module 5-36 V 15 A, 3.3-20 V trigger (valve / contactor driver)
P30-3 | Valve MOSFET module 1 (firing valve A) | power_electronics_smoke | MOSFET switch module 5-36 V 15 A, 3.3-20 V trigger (valve / contactor driver)
P30-4 | Valve MOSFET module 4 (in valve B) | power_electronics_smoke | MOSFET switch module 5-36 V 15 A, 3.3-20 V trigger (valve / contactor driver)
P30-5 | Valve MOSFET module 5 (contactor (controller)) | power_electronics_smoke | MOSFET switch module 5-36 V 15 A, 3.3-20 V trigger (valve / contactor driver)
P30-6 | Valve MOSFET module 6 (contactor (safety node)) | power_electronics_smoke | MOSFET switch module 5-36 V 15 A, 3.3-20 V trigger (valve / contactor driver)
P31-1 | Barrel top | gun_pivots_3_of_3 | Barrel: clear polycarbonate tube 3 in OD x 1/8 wall
P31-2 | Barrel bottom | gun_pivots_3_of_3 | Barrel: clear polycarbonate tube 3 in OD x 1/8 wall
S01-1 | Speaker top left | lights_speakers_3_of_3 | Siren speaker 200 W, 8 ohm, aluminium (Xprite B01DMSR4L4)
S01-2 | Speaker top right | lights_speakers_3_of_3 | Siren speaker 200 W, 8 ohm, aluminium (Xprite B01DMSR4L4)
S02-1 | Audio amp (TPA3255) | power_electronics_smoke | TPA3255 2 x 300 W class-D amp board, 19-50 V DC, 122 x 73 x 30 mm
S03-1 | Audio boost 12-33 V 1200 W | power_electronics_smoke | 1200 W 20 A boost converter, 8-60 V in, 12-80 V out (set to 33 V)
W-1 | Roller rod FL05 | wheel_fl | M8 threaded rod, roller axle (cut 109 mm)
W-2 | Roller rod FL04 | wheel_fl | M8 threaded rod, roller axle (cut 109 mm)
W-3 | Roller rod FL06 | wheel_fl | M8 threaded rod, roller axle (cut 109 mm)
W-4 | Roller rod FL03 | wheel_fl | M8 threaded rod, roller axle (cut 109 mm)
W-5 | Roller rod FL07 | wheel_fl | M8 threaded rod, roller axle (cut 109 mm)
W-6 | Roller rod FL02 | wheel_fl | M8 threaded rod, roller axle (cut 109 mm)
W-7 | Roller rod FL08 | wheel_fl | M8 threaded rod, roller axle (cut 109 mm)
W-8 | Roller rod FL01 | wheel_fl | M8 threaded rod, roller axle (cut 109 mm)
W-9 | Roller rod FL09 | wheel_fl | M8 threaded rod, roller axle (cut 109 mm)
W-10 | Roller rod FL00 | wheel_fl | M8 threaded rod, roller axle (cut 109 mm)
W-11 | Roller rod FR05 | wheel_fr | M8 threaded rod, roller axle (cut 109 mm)
W-12 | Roller rod FR06 | wheel_fr | M8 threaded rod, roller axle (cut 109 mm)
W-13 | Roller rod FR04 | wheel_fr | M8 threaded rod, roller axle (cut 109 mm)
W-14 | Roller rod FR07 | wheel_fr | M8 threaded rod, roller axle (cut 109 mm)
W-15 | Roller rod FR03 | wheel_fr | M8 threaded rod, roller axle (cut 109 mm)
W-16 | Roller rod FR08 | wheel_fr | M8 threaded rod, roller axle (cut 109 mm)
W-17 | Roller rod FR02 | wheel_fr | M8 threaded rod, roller axle (cut 109 mm)
W-18 | Roller rod FR09 | wheel_fr | M8 threaded rod, roller axle (cut 109 mm)
W-19 | Roller rod FR01 | wheel_fr | M8 threaded rod, roller axle (cut 109 mm)
W-20 | Roller rod FR00 | wheel_fr | M8 threaded rod, roller axle (cut 109 mm)
W-21 | Roller rod RL05 | wheel_rl | M8 threaded rod, roller axle (cut 109 mm)
W-22 | Roller rod RL06 | wheel_rl | M8 threaded rod, roller axle (cut 109 mm)
W-23 | Roller rod RL04 | wheel_rl | M8 threaded rod, roller axle (cut 109 mm)
W-24 | Roller rod RL07 | wheel_rl | M8 threaded rod, roller axle (cut 109 mm)
W-25 | Roller rod RL03 | wheel_rl | M8 threaded rod, roller axle (cut 109 mm)
W-26 | Roller rod RL08 | wheel_rl | M8 threaded rod, roller axle (cut 109 mm)
W-27 | Roller rod RL02 | wheel_rl | M8 threaded rod, roller axle (cut 109 mm)
W-28 | Roller rod RL09 | wheel_rl | M8 threaded rod, roller axle (cut 109 mm)
W-29 | Roller rod RL01 | wheel_rl | M8 threaded rod, roller axle (cut 109 mm)
W-30 | Roller rod RL00 | wheel_rl | M8 threaded rod, roller axle (cut 109 mm)
W-31 | Roller rod RR05 | wheel_rr | M8 threaded rod, roller axle (cut 109 mm)
W-32 | Roller rod RR04 | wheel_rr | M8 threaded rod, roller axle (cut 109 mm)
W-33 | Roller rod RR06 | wheel_rr | M8 threaded rod, roller axle (cut 109 mm)
W-34 | Roller rod RR03 | wheel_rr | M8 threaded rod, roller axle (cut 109 mm)
W-35 | Roller rod RR07 | wheel_rr | M8 threaded rod, roller axle (cut 109 mm)
W-36 | Roller rod RR02 | wheel_rr | M8 threaded rod, roller axle (cut 109 mm)
W-37 | Roller rod RR08 | wheel_rr | M8 threaded rod, roller axle (cut 109 mm)
W-38 | Roller rod RR01 | wheel_rr | M8 threaded rod, roller axle (cut 109 mm)
W-39 | Roller rod RR09 | wheel_rr | M8 threaded rod, roller axle (cut 109 mm)
W-40 | Roller rod RR00 | wheel_rr | M8 threaded rod, roller axle (cut 109 mm)
