ElMagoCT/brophy-tshirt-cannon/cad/glacis/out/pneu_parts_sheet.png

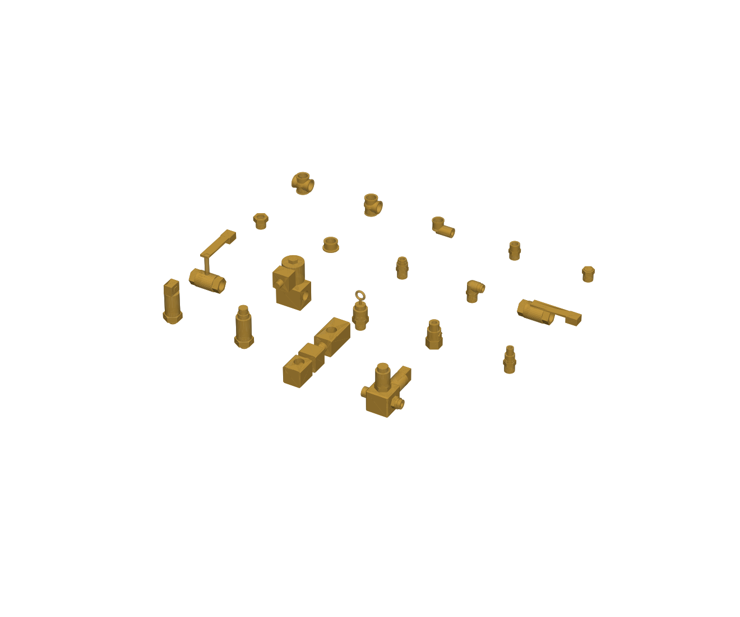
cad/glacis/out/pneu_parts_sheet.png
