ElMagoCT/brophy-tshirt-cannon/cad/glacis/out/step_concept/pneumatics_concept.step

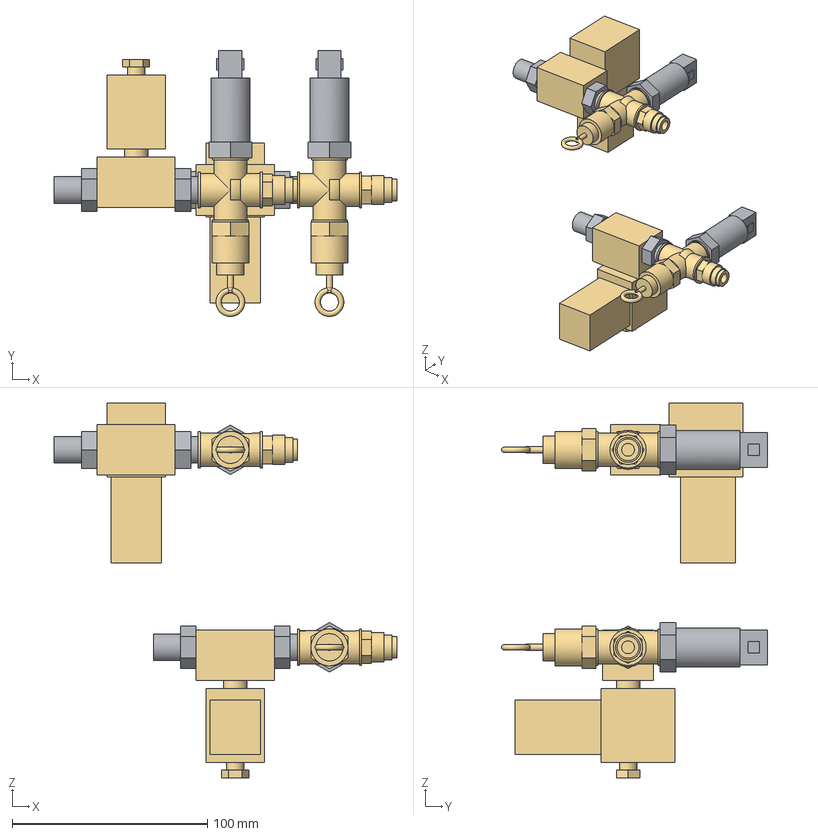
[picture p57: CAD file, 2026-11-13]
cad/glacis/out/step_concept/pneumatics_concept.step
175.6 x 136.4 x 192.3 mm
In valve A (top cannon) inlet nipple (concept, on chamber)
In valve A (top cannon) (concept, on chamber)
In valve A (top cannon) outlet nipple (concept, on chamber)
Chamber cross A (top cannon) (concept, on chamber)
Chamber transducer A (top cannon) (concept, on chamber)
Chamber relief valve 200 psi A (top cannon) (concept, on chamber)
Chamber cross A (top cannon) push-to-connect (concept, on chamber)
In valve B (bottom cannon) inlet nipple (concept, on chamber)
In valve B (bottom cannon) (concept, on chamber)
In valve B (bottom cannon) outlet nipple (concept, on chamber)
Chamber cross B (bottom cannon) (concept, on chamber)
Chamber transducer B (bottom cannon) (concept, on chamber)
Chamber relief valve 200 psi B (bottom cannon) (concept, on chamber)
Chamber cross B (bottom cannon) push-to-connect (concept, on chamber)
