ElMagoCT/brophy-tshirt-cannon/cad/glacis/out/step_gun/gun_pivots_3_of_3.step

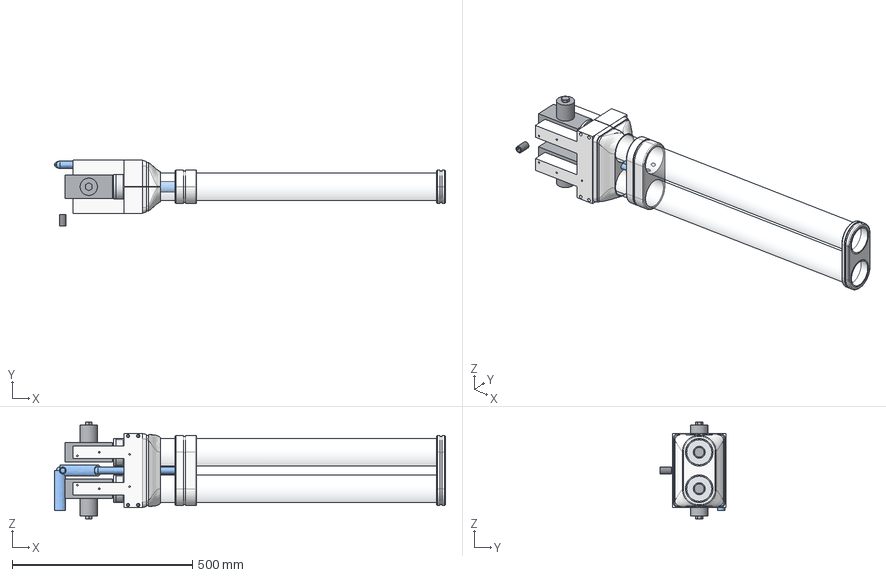
[picture p58: CAD file, 2026-11-13]
cad/glacis/out/step_gun/gun_pivots_3_of_3.step
1085.0 x 182.7 x 268.1 mm
Axle spacer right
Firing valve top (U.S. Solid USS-HSV04)
Firing valve bottom (U.S. Solid USS-HSV04)
top nipple 1x1.50
bottom nipple 1x1.50
Gun smoke tube
Gun core left
Gun core right
Breech adapter top
Breech adapter bottom
Smoke collar
Barrel top
Barrel bottom
Muzzle ring
