ElMagoCT/brophy-tshirt-cannon/cad/glacis/out/step_panels/body_panels_clips.step

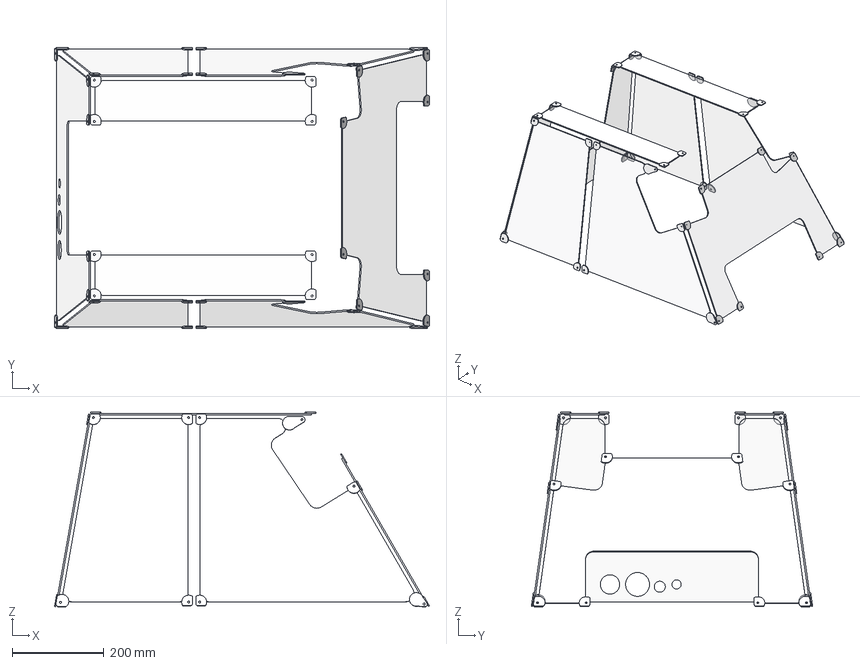
[picture p59: CAD file, 2026-11-13]
cad/glacis/out/step_panels/body_panels_clips.step
816.5 x 612.6 x 423.8 mm
Panel clip 07-5
Panel clip 07-0
Panel clip 02-2
Panel clip 06-1
Panel 07
Panel clip 07-2
Panel clip 07-3
Panel clip 07-1
Panel clip 07-4
Panel clip 02-1
Panel clip 06-2
Panel clip 03-0
Panel clip 03-3
Panel clip 04-0
Panel clip 04-3
Panel 06 (battery door)
Panel 02 (battery door)
Panel clip 06-0
Panel clip 02-3
Panel clip 06-3
Panel clip 02-0
Panel clip 01-3
Panel clip 01-4
Panel clip 05-4
Panel clip 05-3
Panel 03
Panel 04
Panel clip 01-2
Panel clip 05-0
Panel 01
Panel 05
Panel clip 03-1
Panel clip 03-2
Panel clip 04-1
Panel clip 04-2
Panel clip 00-6
Panel clip 00-7
Panel clip 01-1
Panel clip 05-1
Panel clip 00-5
Panel clip 00-0
Panel 00
Panel clip 05-2
Panel clip 01-0
Panel clip 00-1
Panel clip 00-4
Panel clip 00-2
Panel clip 00-3
