ElMagoCT/brophy-tshirt-cannon/cad/glacis/out/step_pneu/pneumatics.step

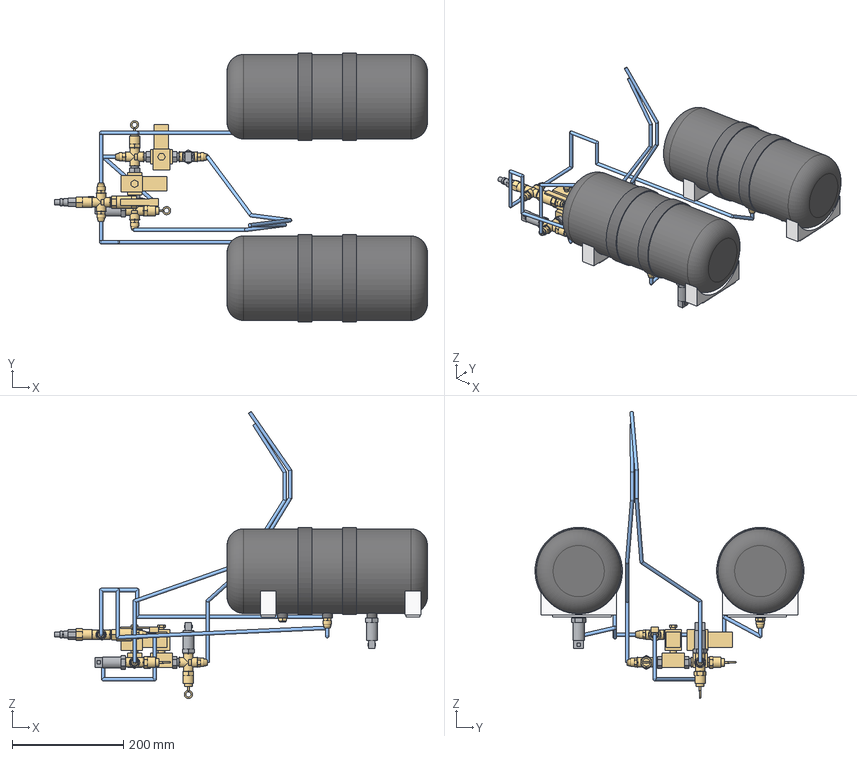
[picture p60: CAD file, 2026-11-13]
cad/glacis/out/step_pneu/pneumatics.step
669.8 x 482.9 x 515.6 mm
Fill plug (M-style, female)
Fill check valve
Rear manifold cross
Rear manifold push-to-connect right tank
Rear manifold push-to-connect left tank
Main valve nipple
Chamber transducer B (bottom cannon)
Valve cross push-to-connect
Tube main valve to cross
Valve cross
Line relief valve 200 psi
In valve B (bottom cannon) inlet nipple
In valve B (bottom cannon) outlet nipple
Chamber cross B (bottom cannon)
Chamber cross B (bottom cannon) push-to-connect
Main valve (1-4 ball valve)
Main valve push-to-connect
In valve B (bottom cannon)
In valve A (top cannon) inlet nipple
Chamber relief valve 200 psi B (bottom cannon)
In valve A (top cannon)
In valve A (top cannon) outlet nipple
Chamber cross A (top cannon)
Chamber transducer A (top cannon)
Chamber relief valve 200 psi A (top cannon)
Chamber cross A (top cannon) push-to-connect
Service loop B (bottom cannon)
Tube tank left
Tube tank right
Service loop A (top cannon)
Tank saddle left -60
Tank saddle right -60
Tank plug left -80
Tank plug right -80
Tank strap left 6
Tank strap right 6
Tank push-to-connect left
Tank push-to-connect right
Air tank right (6 L 200 psi)
Air tank left (6 L 200 psi)
Tank strap left 86
Tank strap right 86
Tank plug left 80
Tank transducer 0-300 psi
Tank saddle left 200
Tank saddle right 200
