ElMagoCT/brophy-tshirt-cannon/cad/glacis/out/step_power/power_electronics_smoke.step

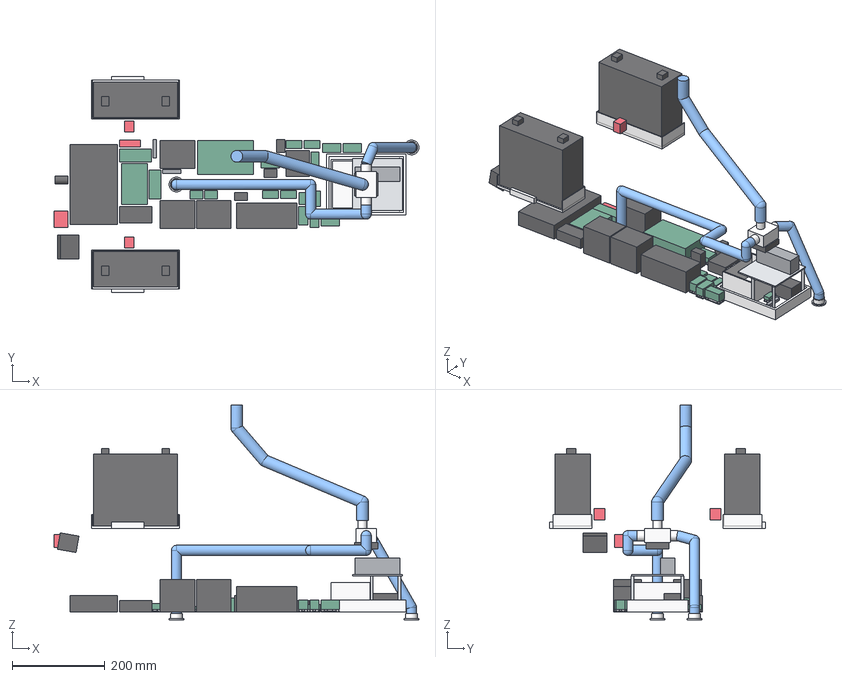
[picture p61: CAD file, 2026-11-13]
cad/glacis/out/step_power/power_electronics_smoke.step
788.5 x 466.9 x 464.5 mm
Charge port (SB50 panel mount)
USB-C panel pass-through
Main breaker 120 A
Power distribution (REV PDH)
Anderson SB50 left
Anderson SB50 right
Inline ATO fuse holder (logic tap)
Main controller ESP32-P4 + C6 (Waveshare)
Board tray Main controller ESP32-P4 + C6
ESP32-S3 safety node
Board tray ESP32-S3 safety node
Battery sled left
FRC battery left
Battery sled right
FRC battery right
Spark MAX (elevation)
DS18B20 probe battery bay
PWM expander PCA9685
Board tray PWM expander PCA9685
DS18B20 probe electronics
Fog vent rear
PDH contactor 200 A
Battery relay A 200 A
ADS1115 ADC 1 (pressures)
Board tray ADS1115 ADC 1
ADS1115 ADC 2 (battery and bus volts)
Board tray ADS1115 ADC 2
Battery relay B 200 A
Audio amp (TPA3255)
Valve arm relay 40 A
Audio boost 12-33 V 1200 W
Relay driver board (ULN2803A)
Board tray Relay driver board
Fog relay 40 A core 1
Valve MOSFET module 2 (firing valve B)
Board tray Valve MOSFET module 2
Fog tube rear
Fog relay 40 A core 2
Valve MOSFET module 3 (in valve A)
Board tray Valve MOSFET module 3
Valve MOSFET module 1 (firing valve A)
Board tray Valve MOSFET module 1
Buck 12-5 V 20 A
Fog loop (to gun)
Fog and light MOSFET module 2 (fog heater)
Board tray Fog and light MOSFET module 2
Logic supply 5 V (buck-boost)
Board tray Logic supply 5 V
Valve MOSFET module 4 (in valve B)
Board tray Valve MOSFET module 4
Fog and light MOSFET module 3 (fog heater 2)
Board tray Fog and light MOSFET module 3
Valve MOSFET module 5 (contactor (controller))
Board tray Valve MOSFET module 5
Valve MOSFET module 6 (contactor (safety node))
Board tray Valve MOSFET module 6
Fog and light MOSFET module 5 (fog blower)
Board tray Fog and light MOSFET module 5
Fog and light MOSFET module 1 (light bar)
Board tray Fog and light MOSFET module 1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
