ElMagoCT/brophy-tshirt-cannon/cad/glacis/out/step_quick/gun_pivots.step

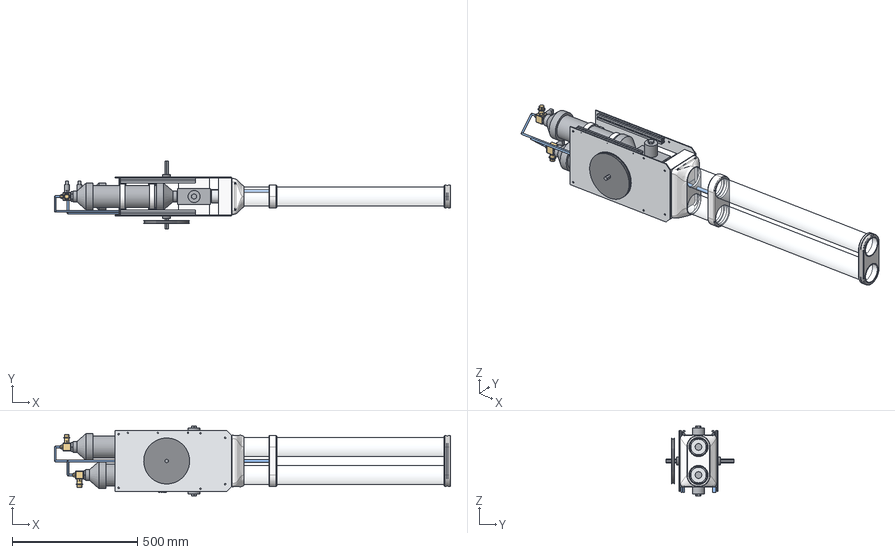
[picture p62: CAD file, 2026-11-12]
cad/glacis/out/step_quick/gun_pivots.step
1580.7 x 272.7 x 278.8 mm
Firing valve top (U.S. Solid USS-HSV04)
top nipple 1x1.50
Breech adapter top
Barrel top
top chamber nipple 1x1.50
top chamber reducer 1x3
top chamber nipple 3x12.00
top chamber reducer 3x1
top chamber bushing 1x1-4
top chamber nipple 1-4x0.87
top chamber port block 1-4
top chamber fill push-to-connect
top chamber relief 200 psi
top chamber transducer 0-300 psi
Firing valve bottom (U.S. Solid USS-HSV04)
bottom nipple 1x1.50
Breech adapter bottom
Barrel bottom
bottom chamber nipple 1x1.50
bottom chamber reducer 1x3
bottom chamber nipple 3x10.00
bottom chamber reducer 3x1
bottom chamber bushing 1x1-4
bottom chamber nipple 1-4x0.87
bottom chamber port block 1-4
bottom chamber fill push-to-connect
bottom chamber relief 200 psi
bottom chamber transducer 0-300 psi
Cradle plate left (1-8 Al)
Rail 20x20 gun left
Cradle plate right (1-8 Al)
Rail 20x20 gun right
Chamber saddle -58
Chamber cap top -58
Chamber cap bottom -58
Chamber saddle -177
Chamber cap top -177
Chamber cap bottom -177
Valve side block top L
Valve side block top R
Valve side block bottom L
Valve side block bottom R
Breech block upper
Breech block lower
Mantlet
Smoke collar
Muzzle ring
Pivot axle stub left (1-2 hex)
Axle hub left
Pivot axle stub right (1-2 hex)
Axle hub right
Elevation pulley 112T
Gun tube top
Gun tube bottom
Gun smoke tube
