ElMagoCT/brophy-tshirt-cannon/docs/glacis/acrylic_cuts/sheet1_strip2.dxf

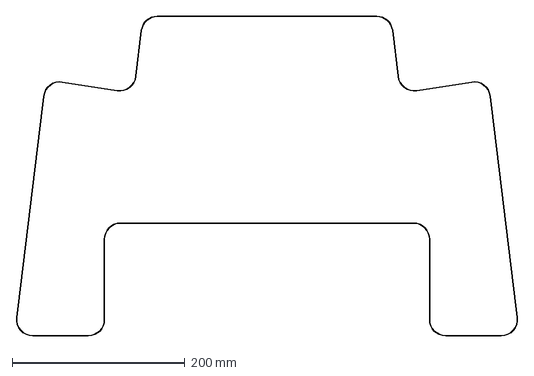
[picture p63: CAD file, 2026-11-11]
docs/glacis/acrylic_cuts/sheet1_strip2.dxf
580.0 x 369.6 mm
