ElMagoCT/brophy-tshirt-cannon/docs/glacis/gun_plates/gun_plate_right.dxf

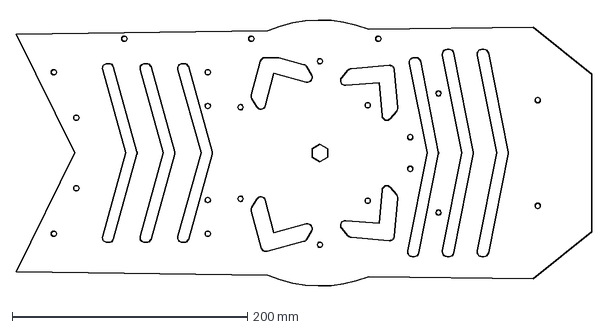
[picture p64: CAD file, 2026-11-11]
docs/glacis/gun_plates/gun_plate_right.dxf
489.5 x 232.2 mm
