ElMagoCT/brophy-tshirt-cannon/docs/glacis/waterjet/corner_plate_top.dxf

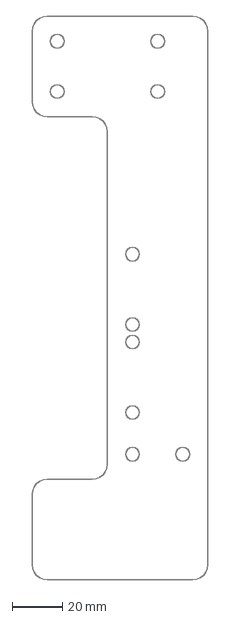
[picture p65: CAD file, 2026-11-13]
docs/glacis/waterjet/corner_plate_top.dxf
70.0 x 224.4 mm
