ElMagoCT/brophy-tshirt-cannon/cad/glacis/out/step_gun/gun_pivots_2_of_3.step

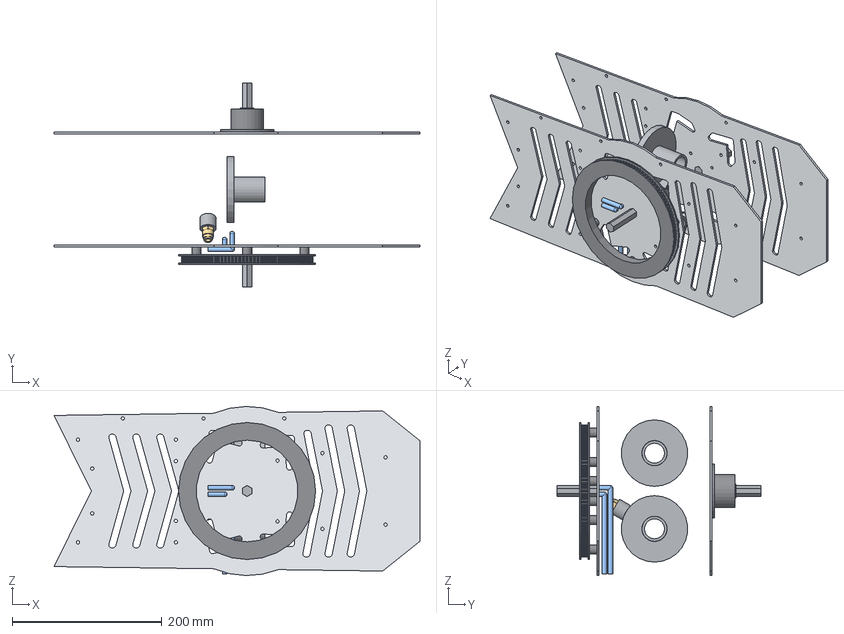
[picture p66: CAD file, 2026-11-13]
cad/glacis/out/step_gun/gun_pivots_2_of_3.step
489.5 x 272.7 x 226.1 mm
Chamber inlet bung bottom
Chamber inlet push-to-connect bottom
Gun tube bottom
Gun tube top
Chamber front disc top
Chamber front disc bottom
Cradle plate left (1-8 Al)
Cradle plate right (1-8 Al)
Chamber outlet nipple top
Chamber outlet nipple bottom
Pivot axle stub left (1-2 hex)
Pivot axle stub right (1-2 hex)
Axle hub left
Elevation pulley 112T ring
