ElMagoCT/brophy-tshirt-cannon/cad/glacis/out/step_quick/add_on_rails.step

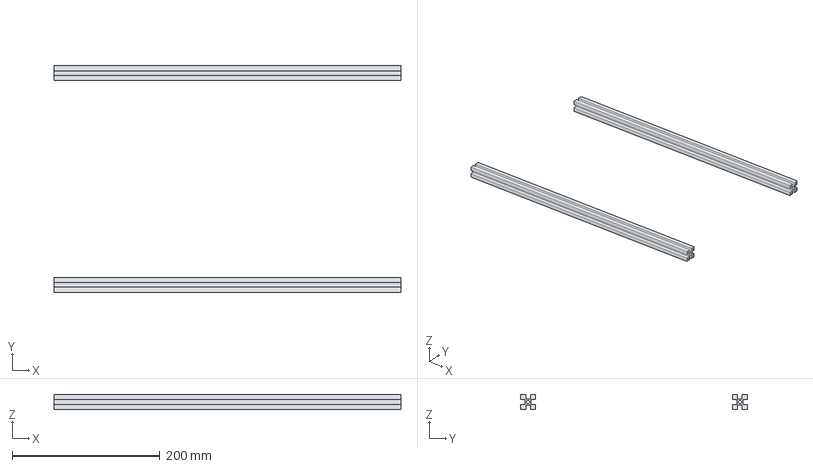
[picture p67: CAD file, 2026-11-12]
cad/glacis/out/step_quick/add_on_rails.step
470.0 x 307.0 x 20.0 mm
Rail 20x20 deck left
Rail 20x20 deck right
