ElMagoCT/brophy-tshirt-cannon/docs/glacis/acrylic_cuts/sheet1_strip3.dxf

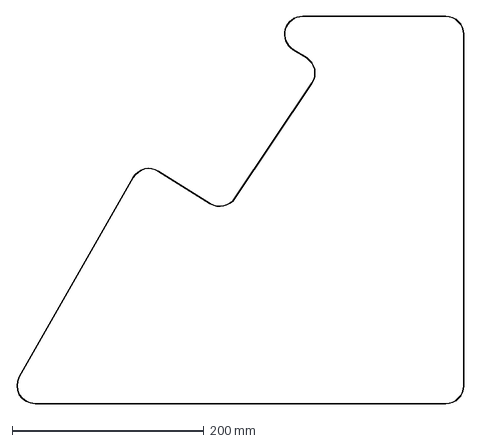
[picture p68: CAD file, 2026-11-11]
docs/glacis/acrylic_cuts/sheet1_strip3.dxf
466.3 x 403.5 mm
