ElMagoCT/brophy-tshirt-cannon/docs/glacis/gun_plates/gun_plate_left.dxf

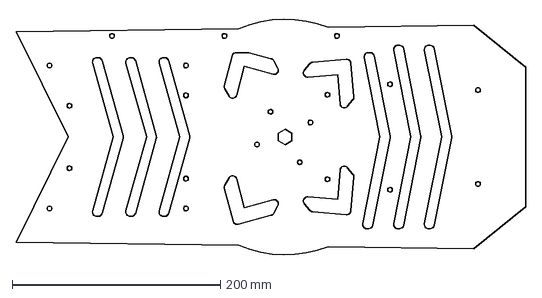
[picture p69: CAD file, 2026-11-11]
docs/glacis/gun_plates/gun_plate_left.dxf
489.5 x 232.2 mm
