ElMagoCT/brophy-tshirt-cannon/docs/glacis/waterjet/side_plate_front.dxf

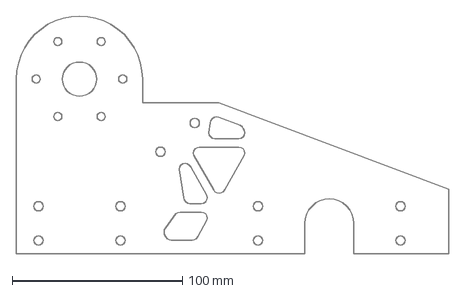
[picture p70: CAD file, 2026-11-13]
docs/glacis/waterjet/side_plate_front.dxf
253.7 x 139.7 mm
