ElMagoCT/brophy-tshirt-cannon/cad/glacis/out/step_gun/gun_pivots_1_of_3.step

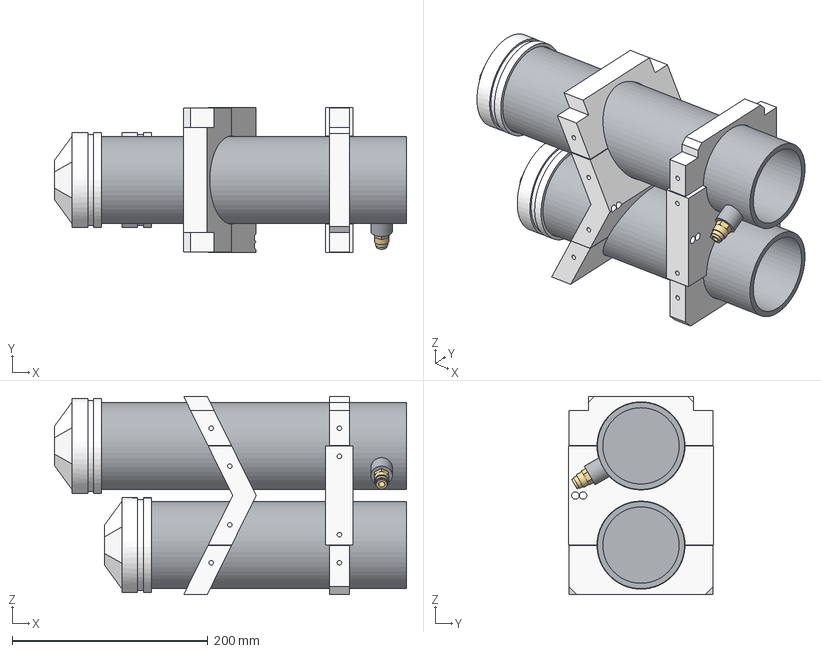
[picture p71: CAD file, 2026-11-13]
cad/glacis/out/step_gun/gun_pivots_1_of_3.step
359.2 x 148.0 x 202.2 mm
Chamber end cover top
Chamber back disc top
Chamber end cover bottom
Chamber back disc bottom
Chamber cap top rear
Chamber cap bottom rear
Chamber saddle rear
Chamber pipe top
Chamber pipe bottom
Chamber cap bottom -95
Chamber saddle -95
Chamber cap top -95
Chamber inlet bung top
Chamber inlet push-to-connect top
