ElMagoCT/brophy-tshirt-cannon/docs/glacis/acrylic_cuts/sheet1_strip1.dxf

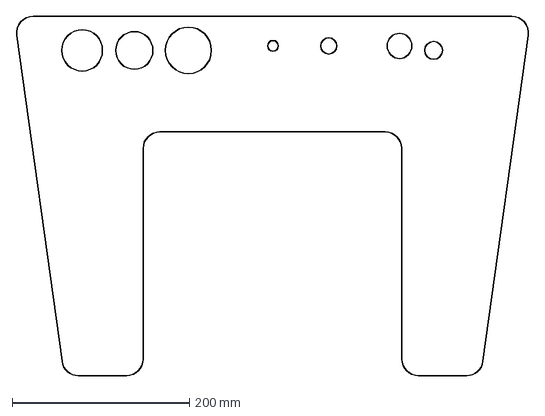
[picture p72: CAD file, 2026-11-11]
docs/glacis/acrylic_cuts/sheet1_strip1.dxf
578.9 x 405.9 mm
