ElMagoCT/brophy-tshirt-cannon/docs/glacis/waterjet/nest_1-8_sheet3.dxf

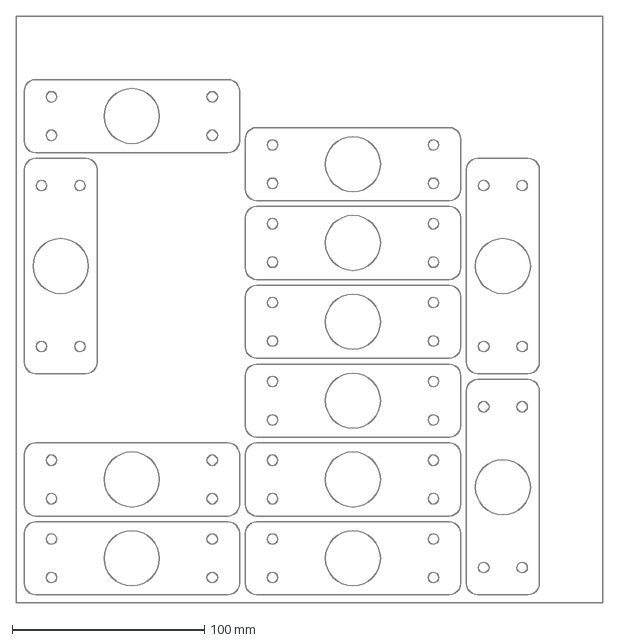
[picture p73: CAD file, 2026-11-13]
docs/glacis/waterjet/nest_1-8_sheet3.dxf
304.8 x 304.8 mm
