ElMagoCT/brophy-tshirt-cannon/docs/glacis/acrylic_cuts/sheet2_strip2.dxf

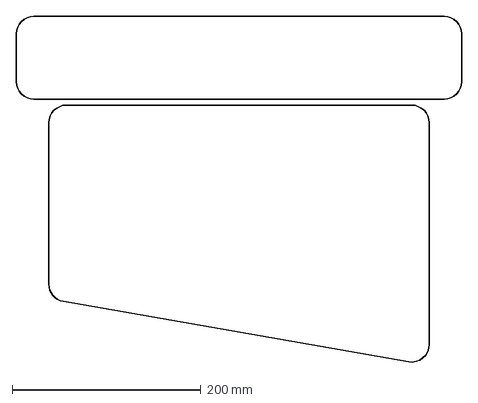
[picture p74: CAD file, 2026-11-11]
docs/glacis/acrylic_cuts/sheet2_strip2.dxf
472.3 x 367.2 mm
