ElMagoCT/brophy-tshirt-cannon/docs/glacis/waterjet/corner_plate_bottom.dxf

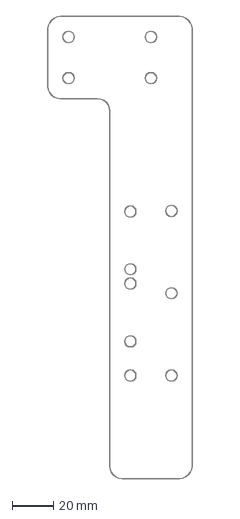
[picture p75: CAD file, 2026-11-13]
docs/glacis/waterjet/corner_plate_bottom.dxf
70.0 x 224.4 mm
