ElMagoCT/brophy-tshirt-cannon/docs/glacis/acrylic_cuts/sheet2_strip3.dxf

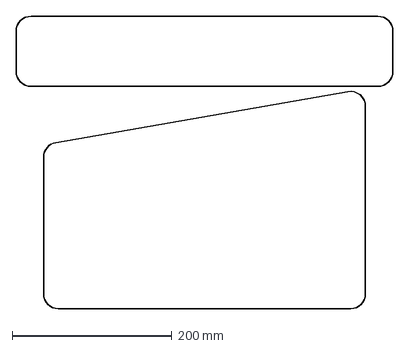
[picture p76: CAD file, 2026-11-11]
docs/glacis/acrylic_cuts/sheet2_strip3.dxf
472.3 x 366.5 mm
