ElMagoCT/brophy-tshirt-cannon/docs/glacis/acrylic_cuts/sheet2_strip1.dxf

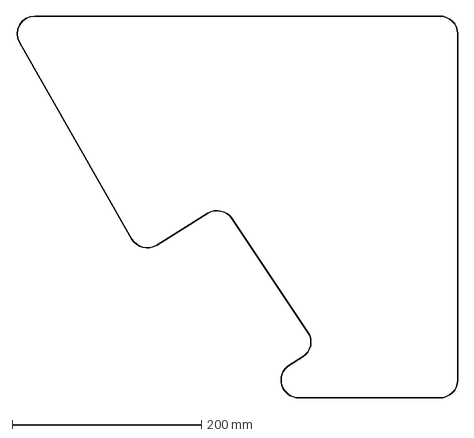
[picture p78: CAD file, 2026-11-11]
docs/glacis/acrylic_cuts/sheet2_strip1.dxf
466.3 x 403.5 mm
