ElMagoCT/brophy-tshirt-cannon/docs/glacis/waterjet/nest_1-8_sheet2.dxf

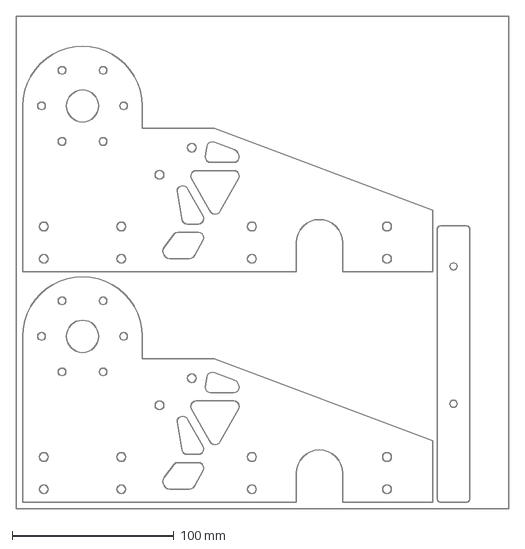
[picture p79: CAD file, 2026-11-13]
docs/glacis/waterjet/nest_1-8_sheet2.dxf
304.8 x 304.8 mm
