ElMagoCT/brophy-tshirt-cannon/docs/glacis/waterjet/tower_plate.dxf

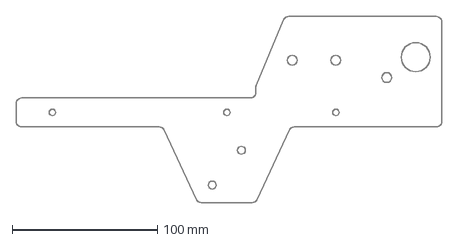
[picture p80: CAD file, 2026-11-13]
docs/glacis/waterjet/tower_plate.dxf
293.0 x 128.0 mm
