ElMagoCT/brophy-tshirt-cannon/docs/glacis/waterjet/rail_spacer_strip.dxf

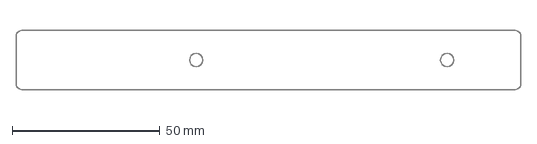
[picture p81: CAD file, 2026-11-13]
docs/glacis/waterjet/rail_spacer_strip.dxf
171.0 x 20.0 mm
