ElMagoCT/brophy-tshirt-cannon/docs/glacis/waterjet/bearing_plate.dxf

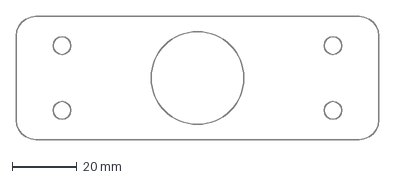
[picture p82: CAD file, 2026-11-13]
docs/glacis/waterjet/bearing_plate.dxf
112.0 x 38.0 mm
