ElMagoCT/brophy-tshirt-cannon/docs/glacis/waterjet/bellypan.dxf

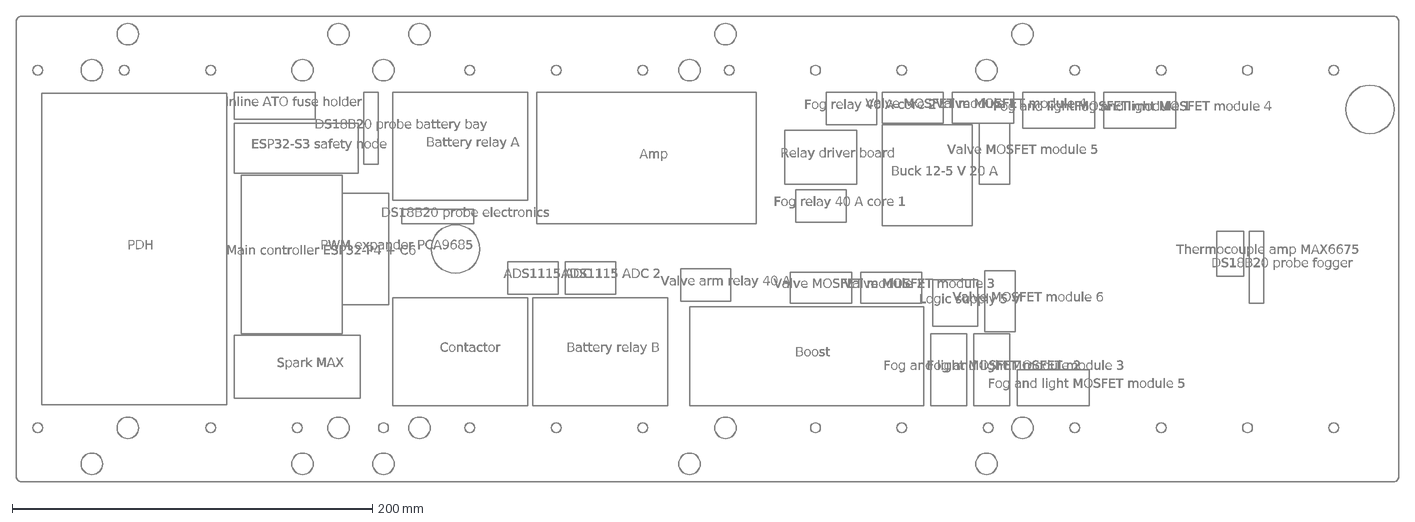
[picture p83: CAD file, 2026-11-13]
docs/glacis/waterjet/bellypan.dxf
PDH
Main controller ESP32-P4 + C6
ESP32-S3 safety node
PWM expander PCA9685
ADS1115 ADC 1
ADS1115 ADC 2
Spark MAX
Valve arm relay 40 A
Relay driver board
Fog relay 40 A core 1
Fog relay 40 A core 2
Valve MOSFET module 1
Valve MOSFET module 2
Valve MOSFET module 3
Valve MOSFET module 4
Valve MOSFET module 5
Valve MOSFET module 6
Fog and light MOSFET module 1
Fog and light MOSFET module 2
Fog and light MOSFET module 3
Fog and light MOSFET module 4
Fog and light MOSFET module 5
Thermocouple amp MAX6675
Inline ATO fuse holder
DS18B20 probe electronics
DS18B20 probe battery bay
DS18B20 probe fogger
Buck 12-5 V 20 A
Logic supply 5 V
Contactor
Battery relay A
Battery relay B
Amp
Boost
