ElMagoCT/brophy-tshirt-cannon/docs/glacis/waterjet/side_plate_rear.dxf

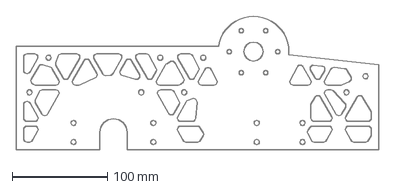
[picture p86: CAD file, 2026-11-13]
docs/glacis/waterjet/side_plate_rear.dxf
380.0 x 139.7 mm
