ElMagoCT/brophy-tshirt-cannon/docs/glacis/waterjet/corner_gusset_top.dxf

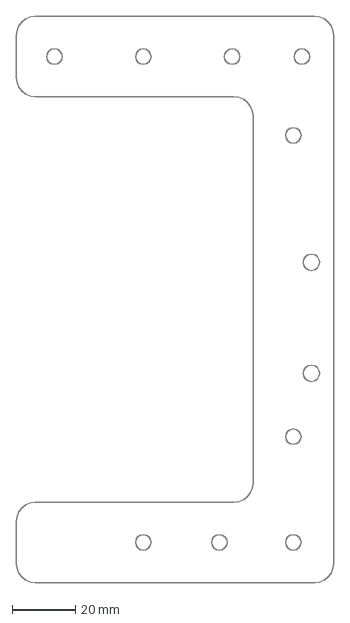
[picture p87: CAD file, 2026-11-12]
docs/glacis/waterjet/corner_gusset_top.dxf
100.0 x 178.6 mm
