ElMagoCT/brophy-tshirt-cannon/docs/glacis/waterjet/arm_knee.dxf

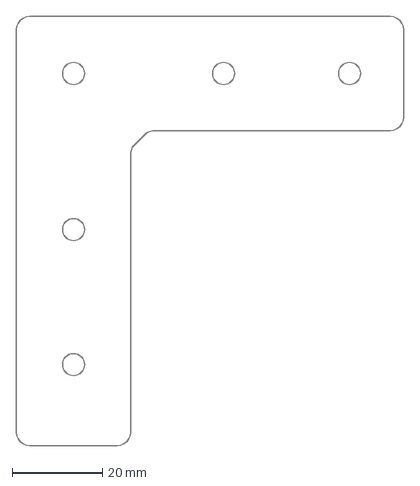
[picture p88: CAD file, 2026-11-12]
docs/glacis/waterjet/arm_knee.dxf
86.0 x 95.4 mm
