ElMagoCT/brophy-tshirt-cannon/docs/glacis/waterjet/nest_1-8_sheet6.dxf

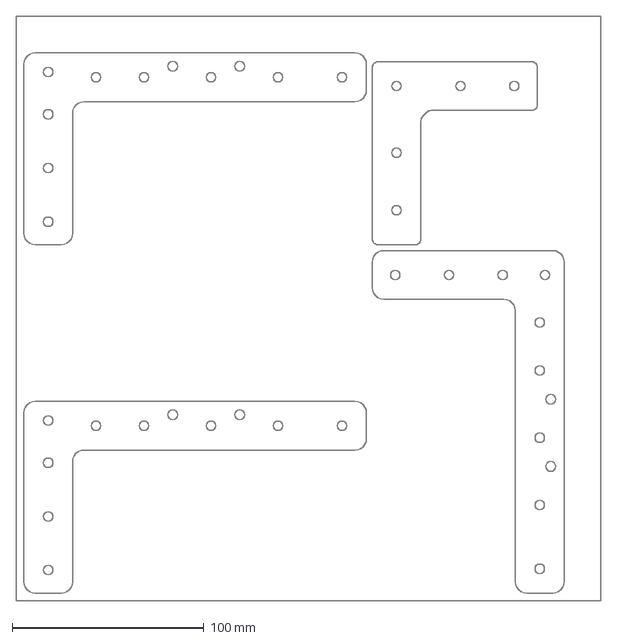
[picture p89: CAD file, 2026-11-12]
docs/glacis/waterjet/nest_1-8_sheet6.dxf
304.8 x 304.8 mm
