ElMagoCT/brophy-tshirt-cannon/docs/glacis/waterjet/bellypan_front.dxf

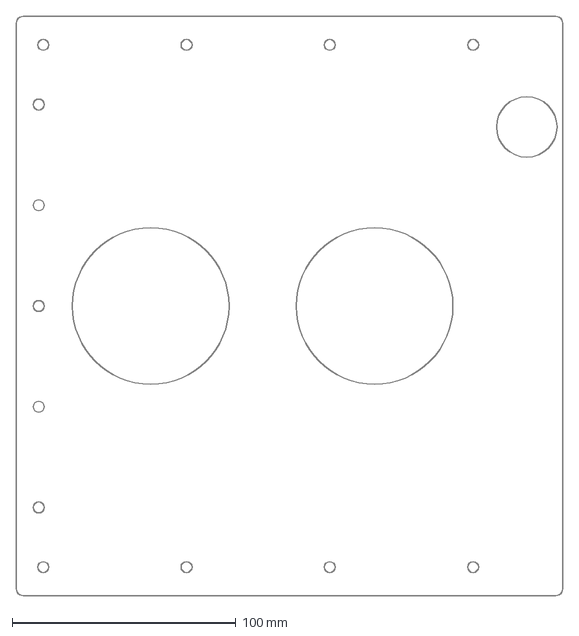
[picture p90: CAD file, 2026-11-11]
docs/glacis/waterjet/bellypan_front.dxf
244.0 x 258.7 mm
