ElMagoCT/brophy-tshirt-cannon/docs/glacis/air_wiring_artifact.html

# Glacis air & wiring

Brophy Borealis · Mark 5 · listings re-read 10 Nov 2026

## Air sim

0 psi 100 200 psi moving dashes = flowing · click any part

Shop airConnect hose stops at150 psi MainOpen RailSafe Auto fillOn Top120 psi Bottom120 psi Elevation35° Fire top– Fire bottom– Speed1×4×12× EmptyCharged

Fire a cannon: the arc and landing distance draw in the side view.

## Power sim

12 V power 5 V power data / control dead teal transistor = switched on

Kill (main breaker)On Battery B12.6 V RemoteLink upE-stop DashboardEnabledValves safe Drive0% Honk Music off LEDsOffGlowChaseRainbow cap20% BarOffDimOn FogOffHeatPuff

## Parts list

Brophy Borealis · changes vs rev D.2.1

Every itemChanged this round Open a system; click a row for its listing notes.

## Open items

click an item for the part

Onshape: document "TC5 - Brophy Borealis". Latest version: "Straight connectors, flat rear cross, no QDs (2026-11-12)". Branch (workspace) "Concept: in valves + sensors on the chambers": each chamber's in valve, cross, transducer and relief sit on the chamber's back end (concept only, clashes allowed).

## Money

vs rev D.2.1
