ElMagoCT/brophy-tshirt-cannon/(commit log)

2026-11-02 Repo layout, CLAUDE.md handoff, goals, BOM xlsx + CSV mirror
    [Brophy_TShirt_Cannon_Mark5_Parts_List.xlsx, bom.csv, design-notes.csv]
2026-11-02 BOM: verified Tier A (pneumatics + electronics, 2026-11-01), decision log
    - Every pneumatic and electronics line re-checked live: link, price, stock, thread
    - Compressor closed: ZHSYMX SQ420 1.41 CFM free air, 100% duty @ 100 PSI
    - Tier A now buys one complete barrel (QEV/dump/barrel were missing)
    - Per-chamber relief + bleed + gauge (chambers sit behind their check valves)
    - 3/4in Parker 0R75B proposed: no in-stock affordable 1in NPT QEV exists
    - Tier A $1,213.35; A+B $2,282.56, cuts proposed in docs/decisions.md
    [Brophy_TShirt_Cannon_Mark5_Parts_List.xlsx, bom.csv, design-notes.csv]
2026-11-02 Concepts v2: stealth hulls built around the real parts
    Packaging-first bodies: enclosed mecanum, battery, compressor, rear
    transverse tank, actuator, per-barrel QEV + transverse chamber. Hull
    side panels continue up into split turret halves around the gun;
    stacked barrels elevate 0-90 deg in the centre slot, revolver drum is
    exposed. All panels planar. Fit checker + x-ray mode; all 20 fit.
2026-11-02 Glacis: full CadQuery design, Onshape export, parts list, judgments
    - cad/glacis: parametric model of the whole robot (561 parts): 80/20 frame,
    Falcon 40:1 two-stage belt drive, 12 in printed mecanum (16 rollers, hubs in
    bed-sized arcs), three-barrel gun on QE5 valves with 4 in chambers, servo
    elevation, rear tanks and manifold, FRC bumpers, printed body frame with
    tapered tenons and LED slots, acrylic panels and liners.
    - robot.py checks: no interference, clean 0-90 deg sweep, every print fits a
    256 mm bed, every part one solid; STEP export grouped by Onshape tab.
    - bom/glacis_bom.py: source of the "Glacis BOM" sheet tab ($2,102.30).
    - docs/glacis/JUDGMENTS.md: every design call a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
    [glacis_bom.csv, parts_from_cad.csv]
2026-11-02 Glacis rev B: two polycarbonate barrels, box tube frame, 10 in one-stage mecanum, STM32 + ESP-NOW failsafe
    Micah's second round of notes:
    - 1x2/1x1 box tube with gussets; 10 in printed mecanum with aluminum side plates, Falcon 12T straight to a
    120T printed into the hub (10:1), 1/2 hex live axles in FRC hex bearings, 3 in clearance
    - one 70 deg front slant, flat deck at 22.8 in, sides leaning in 6 deg, turret pushed back 6.7 in
    - acrylic recessed in the printed frame with 42 printed corner clips; no liner
    - two clear polycarbonate barrels, 0.4 L chambers (4 x 3/4 bushing into a 4 in cap), 5-port inlet
    blocks with pull-ring reliefs and transducers, check valves on a fixed fill cross
    - lef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
    [glacis_bom.csv, parts_from_cad.csv]
2026-11-03 Glacis rev C CAD: chambers behind the valves, balanced gun around a centre axle, 60 deg front, fog ducts, LED channel
    Checks clean: 0 interference, 0 sweep clashes (0-90 deg every 5 deg), 0 oversize prints, 0 multi-piece parts.
    [parts_from_cad.csv]
2026-11-03 Glacis rev C: parts list, judgments and docs; 125 psi chamber reliefs, 12 V EVAP smoke machine
    - BOM rev C ($1,827.38): one more Atlantic Valves SZW-25 and 1 gal ASME chamber like the old cannon's,
    Milton 1090-125 reliefs, MOSFET firing, AutoLine Pro HyperSmoke smoke machine, SB50 charge port
    - JUDGMENTS.md rewritten for rev C (old-cannon identification, 110 psi cap, valve trade-off, air budget)
    - CLAUDE.md status rows, decisions log, CAD README
    [glacis_bom.csv, parts_from_cad.csv]
2026-11-03 Glacis rev C wheels: vector-style 10 in mecanum on 608s and M8 rod, layout refit
    - 10 rollers (42 x 104 mm), each on two 608 2RS and a fixed M8 threaded rod held by a captured
    nyloc; barrel profile kept. Modelled after Micah's TTB-0010 vector wheel.
    - Hub in two PETG-CF halves (242 mm, bed 256) split at the roller centre plane; the inboard half
    carries a 116T HTD 5M 15 mm pulley whose flange sits 1.27 in off the floor (9.67:1, stock 140T belt).
    - Three flat 1/8 in aluminum plates per wheel on 8 x 1/4-20 through-bolts; lobed rim like the TTB.
    - Wheels are 120 mm wide (was 94): inner rails and Falcons moved 26.5 mm inboard; electronics shelf,
    fill block, tank lines, sled rails and pivot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
    [glacis_bom.csv, parts_from_cad.csv]
2026-11-03 Glacis rev C.1 gun: 0.53 L 2 in pipe chambers, barrels 3.8 mm apart, pivot on two stubs
    - Chamber sized with a shot model (cad/glacis/shot_model.py): the slow SZW-25 sets the shot, so 0.53 L
    gives 78% of the 1 gal's speed with 5x the shots per charge, for about $41 a chamber instead of $397
    - Spigot breech adapters, one two-piece breech block, fittings on a 5-port block behind each chamber
    - Rear-panel controls lowered, smoke and service loops rerouted; checks clean
    - BOM $1,557.91 (before the wheel update)
    [glacis_bom.csv]
2026-11-03 Glacis rev C.2: in valves, LED loops and glowing frame, corner speakers, savings ($1,512.44)
    - Air: main valve -> brass cross -> one Aignep in valve per chamber; check valves, fill block,
    fill sensor and the rear bleed valve removed; 200 psi relief on the cross; tank relief is the
    hand dump through the rear panel. Sensors are PT1 tank, PT2/PT3 chambers.
    - Light: a 60/m loop per panel on a flanged rail leaning 15 deg, 1.15 in behind the acrylic, 42 mm
    in from shared edges and 29 mm from open ones; a 100/m strip in a centred tunnel through every
    frame member (tenons moved deeper, feed slots at the nodes). Strips modelled.
    - Corner clips chamfered and twice the size; battery doors latch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
    [glacis_bom.csv, parts_from_cad.csv]
2026-11-03 Glacis C.2: move wheel-plate lightening holes off the hub holes
    The 0 and 180 deg plate holes were exactly tangent to the hub light holes,
    so Onshape imported all 12 plates as sheet bodies. Now 6 x 16 mm at r 68,
    >= 7.7 mm of web everywhere; the import has 588 solids and 588 instances.
    [parts_from_cad.csv]
2026-11-04 Glacis rev C.3 electronics + air review: PDH contactor, always-on logic rail, range math
    - STM32 switches the whole PDH through a 200 A contactor; a 5 A fuse and a 5 V buck-boost
    ahead of it keep the STM32, both ESP32-S3s and every sensor alive in standby. Rear E-stop
    opens both the contactor and the valve-rail relay.
    - Main valve is a manual ball valve; fill port is an M-style plug + check valve.
    - Fog fluid level switch and DS18B20 temps; battery/PDH volts; one transducer part number.
    - electrical/README.md: power tree, sensors, STM32 check, camera options, power budget.
    - cad/glacis/range_model.py: the rev C.2 gun tops out near 120 ft; 200 ft needs ~2 L+
    chambers and 36-48 in barrel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
    [glacis_bom.csv]
2026-11-04 Glacis rev D proposal: 200 psi top cannon, 3 in bottom chamber, 30 L of tanks, 5 GHz bridge
    - Top cannon: the old 1 gal tank on a U.S. Solid USS-HSV04 (1 in, 725 psi, Cv 11.67) so it
    runs to full tank pressure; bottom: 3 in Sch 40 x 10 in chamber (~1.35 L) on the old SZW-25.
    Both barrels 36 in. 200 ft at 96-151 psi on top; 120 ft at 42-65 (top) / 69 psi (bottom).
    - Tanks: five of the same 6 L 200 psi tank (30 L) for ten 120 ft shots per cannon per
    200 psi charge (six each from 150-175 psi).
    - WiFi bridge moves to an ESP32-C5 on 5 GHz; no STM32 has WiFi built in, so the STM32 stays.
    Camera deferred.
    - range_model.py rev D section; JUDGMENTS D1-D8; diagram updated. Not in the CAD yet.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
    [glacis_bom.csv]
2026-11-04 Glacis rev D.1 proposal: 3 in pipe chambers for both cannons, three 6 L tanks
    - Old 1 gal tank out (too big): the top chamber is 3 in Sch 40 x 12 in (~1.59 L) on the
    725 psi HSV04, the bottom 3 in x 10 in (~1.35 L) on the SZW-25. 200 ft at 120-176 psi;
    120 ft at 64-89 psi (top) and 69 psi (bottom), ~40% less air per shot than the old tank.
    - Barrel axis spacing ~112 mm (3 in couplings are 4.28 in across).
    - Tanks: the two side 6 L tanks plus a third of the same part where Micah circled, 18 L:
    12-21 shots at 120 ft per 175-200 psi charge. 3 gal / 2.5 gal options priced in D11.
    - range_model.py rev D.1; JUDGMENTS D9-D12 with the running cost table; diagram updated.
    Parts list -$17.83 ($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
    [glacis_bom.csv]
2026-11-04 Glacis rev C.3 body and gun (checkpoint before rev D.1)
    Body: 19 mm members with a 7 mm acrylic ledge, rounded windows/acrylic/clips,
    M4 heat-set inserts for every panel screw, front panel cut at the well floor with
    one printed cheek each side, speakers sunk 13 mm deeper, hood light pods in the
    cheeks, underglow brackets under the bumpers. LED rails: 22.5 mm corners stood
    square to the panel, the 15 deg lean only on straight runs, per-edge insets
    (42 shared, 19 open/seams, 24 gun well, 30/46 speaker notches), flange-carried.
    Gun (fork): one-piece smoke collar, muzzle ring and flowing mantlet, 100 mm core
    with the fill and smoke lines out the bottom behind the pivot, 312 rpm elevation
    at 7:1,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
    [parts_from_cad.csv]
2026-11-04 Glacis D14: CAD test-fit leaves room for two 6 L tanks only (12 L); parts -$65.59
    [glacis_bom.csv]
2026-11-04 Glacis rev D.1 modelled: 3 in chambers, 36 in barrels, 45 deg, detailed pneumatics
    Gun: 3 in Sch 40 chambers (12 in on a U.S. Solid HSV04 on top, 1.63 L; 10 in on the
    SZW-25 below, 1.38 L), barrels 112 mm apart and 36 in long, valve faces lined up,
    148 mm core; pivot raised to z 645 and elevation capped at 45 deg so the chambers
    clear the rear bay; 150T elevation belt. Gun well 266 mm wide.
    Body: battery doors split at x -105 with the batteries moved forward so one clears
    the rails; LED loops 42 mm on shared edges, 19 on edges without a neighbour, rails
    on flanges; hood lights moved to the low front corners; underglow brackets lowered
    under the corner gussets; E-stop outboard.
    Air: every pne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
    [glacis_bom.csv, parts_from_cad.csv]
2026-11-04 Glacis D.1: top chamber relief is the 200 psi Interstate (it runs to 190 psi)
2026-11-04 Glacis rev D.1.1: LED loops, Zmoon light bar, tank fit, parts cost-down to $1,359.91
    - LED loops at 2/3 radii with a variable per radius kind, rounded rail edges, rails back to back on
    shared edges, strip 0.96 in behind the panel; loops trimmed where neighbours cross (8 jumpers)
    - Micah's Zmoon 12 in light bar across the nose, STM32 PWM through a MOSFET (replaces the hood lights)
    - EVIL ENERGY 2.5 gal test-fit: two don't fit, one only replaces both 6 L tanks (JUDGMENTS N3)
    - Parts: cheapest of AliExpress (logged-in), Amazon and McMaster; no rivets, old 9 in mecanum for now,
    goBILDA owned; ASME McMaster reliefs; $1,888.37 -> $1,359.91
    - Render pipeline (three.js from a GLB) and D.1.1 rend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
    [glacis_bom.csv, parts_from_cad.csv]
2026-11-04 Glacis rev D.1.2: LED band is the window wall, no overlaps
    - The window wall runs from the acrylic ledge straight back to the strip, centred 25 mm behind the
    acrylic with a 10 deg lean; no rail or flange (Micah: the D.1.1 rails overlapped)
    - Shared edges set by the corner bisector (31-36 mm) so neighbours' strips meet back to back;
    other edges pushed in only if their strip would hit frame. 0 overlaps, 0 jumpers
    - Clip inserts kept inside slanted faces; light bar bracket tab moved behind the bar
    - led_check.py: fast contact check and corner sections; Onshape version Glacis rev D.1.2
    [glacis_bom.csv, parts_from_cad.csv]
2026-11-04 Glacis rev D.1.3: chamfered window wall, filled LED corners, bent frame strips
    - Window wall chamfers from the acrylic's 7 mm ledge straight to the LED band (exact rounded ledge line);
    below the member the window cut is only a 4 mm ring round the LED line
    - Shared corners filled solid between the back-to-back LED skins (one V ridge); those 24 joints are glued,
    57 keep M4 cross screws
    - Frame-tunnel strips modelled as one piece per member, bent the easy way into each feed slot and out to its
    mouth; straight ends where a slot is too short
    - Fixes from an independent review; led_check tests fills and skins too. 0 contacts, frame 5.17 L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
    [glacis_bom.csv]
2026-11-05 Shared design log and collaborator workflow
    docs/UPDATES.md: every person and Claude chat reads it first, claims files under
    'In progress', and adds an entry when done. docs/COLLABORATING.md: setup, branch +
    PR workflow, what only Micah's chats do. docs/COLLABORATOR_PROMPT.md: the prompt to
    paste into a collaborator's Claude Code. cad/requirements.txt pins the CAD venv.
    CLAUDE.md: the read-first rule at the top.
2026-11-05 Glacis rev D.1.4: printable frame, frame mounts, bumper ring, Xprite speakers
    Micah's round: estimate the frame print (0.6 mm, 2 walls, 10%), clean up every
    printed part and cut it to the CC1/CC2 beds, tie the frame to the chassis and the
    turret towers, and make the bumpers slide off downward. A nine-agent review of all
    121 printed body parts drove most of the fixes.
    - Print plan (docs/glacis/print_plan.md): 45 frame pieces on 11 plates, 2.97 kg
    PETG, about 37 h on both printers; part_report.py gives orientation, support
    (ray cast) and footprints. Not hollowed in CAD (the slicer's shell is the hollow).
    - Clips: every clip laps its acrylic (spike corners by the speaker notch act as
    one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
    [glacis_bom.csv, parts_from_cad.csv]
2026-11-05 Glacis D.1.4: Onshape version saved
    11 changed tabs swapped into their sub-assemblies; Micah's custom tank edits
    versioned first and left untouched.
2026-11-07 Glacis rev D.2 proposal: listing re-check, one ESP32-P4 controller, bumper foam, sims artifact
    Every pneumatic listing re-read for thread size and gender: fill plug now female
    (Milton 728) on the male x male check valve, three missing street elbows added,
    top chamber fittings re-rated (stainless bushings, MSI couplings), HSV04 thread
    and SZW-25 rating flagged. One ESP32-P4 + C5 board replaces the STM32 + bridge;
    PWM gate dropped. GoTo Foam bumpers on a 1x6 backing. Parts $1,382.62 (+$9.20).
    Air and power sims, thread map and review in the air & wiring artifact.
    No CAD or Onshape change; waiting on Micah's green light.
    [glacis_bom.csv]
2026-11-07 Glacis rev D.2: both cannons to 190 psi on HSV04s, LED lean 17.5 deg, 1x6 bumpers, fill line fix, one controller
    Micah's green light with changes: second HSV04 + MSI couplings + 200 psi
    relief on the bottom cannon; female plug on the panel nipple, F x F elbow,
    male x male check valve; LED lean 17.5 deg; 1x6 backing ripped to 5 in with
    2 in foam; electronics shelf with the ESP32-P4 + C5 board, music ESP32 and
    ADS1115; second MOSFET pack. His Sheet edits folded into glacis_bom.py.
    Parts $1,702.75; Sheet synced. Checks: only the two known slivers.
    Artifact redesigned (short scroll, system boxes, power/data lines, MOSFETs).
    [glacis_bom.csv]
2026-11-07 Glacis rev D.2: Onshape updated (version "Glacis rev D.2"), Sheet synced, artifact status
    14 Onshape tabs swapped (body frame now 7 tabs), part counts checked against
    the export manifest, descriptions re-set, version saved after snapshotting
    Micah's view edits. F x F elbow modelled at 17 mm per leg (clears the new
    nipple/check-valve overlap). Second MOSFET pack for the safety node's coil
    channel. Sheet rewritten with Micah's own rows kept: $1,702.75.
    [parts_from_cad.csv]
2026-11-09 Claim: printable mini model
2026-11-09 Claim: printable mini kit (widen files)
2026-11-09 electrical/README: E-stop and safety-node trips updated to rev D.2
    The rev C text still described the safety relay, the PWM gate and a 210 psi
    PT1 trip; in D.2 the safety node opens the contactor coil and nothing trips
    on PT1 (the 200 psi relief is the tank limit).
2026-11-09 Glacis BOM sheet: Broncobots budget layout
    The Glacis BOM tab now uses the budget order-tab format: Item, Price
    Per Unit, Quantity, Total Price, Provider, Notes, Link, Purchased?
    from B3, a gray total band in row 2 (9.1% tax, shipping, total with
    both), alternate-row shading and a thick outline. glacis_bom.py writes
    rows in that layout; the McMaster shipping estimate moves to the band
    and each item's listing notes become its cell note.
2026-11-10 Claim: Brophy Borealis changes (light bar recess, 20x20 rails, QDs, two orders, Onshape pivot)
2026-11-10 Glacis rev D.2.1: Waveshare P4 controller, speaker-out tap to the amp, battery relays
    Waveshare ESP32-P4-Module-DEV-KIT replaces the WTDKP4C5-S1 (USB-A + 2 USB-C, 40-pin
    header, ES8311 + NS4150B). PCA9685 + a second ADS1115 cover the pin budget. The
    board's speaker output feeds the TPA3255 through a two-stage RC tap (PCM5102A moves
    to LATER). Each FRC battery gets its own 200 A relay with a 4.7 ohm bypass so the
    fuller pack runs alone until they're within 0.3 V. C3 SuperMini as the remote.
    Total $1,702.75 -> $1,733.78.
    [glacis_bom.csv]
2026-11-10 UPDATES: rev D.2.1 entry (overlaps the Borealis claim on the BOM and JUDGMENTS)
2026-11-10 WIP Brophy Borealis: light bar pocket, 20x20 rails, two-order BOM, QDs
    [glacis_bom.csv]
2026-11-10 electrical/README: the Waveshare P4 board has 4 USB-A ports, not 1
2026-11-10 Borealis BOM cleanup: drop unused rows, owned/stash below each order, Milton M-style QDs, cheaper transducers
    Removes the old-cannon spares and the LATER rows; every Owned/Stash row now sits in an
    ALREADY HAVE section under its order. Interior quick disconnects are Milton 715 couplers
    + 728 plugs ($39.88, 300 psi, socket seals the supply side) instead of 5 McMaster ISO-B
    pairs ($243.60); transducers are the AliExpress 1/8 NPT 5 V sender ($10.69 vs $17.69).
    Total $2,002.43 -> $1,777.71. Also the Mac's 4 USB-A correction on the P4 board.
    [glacis_bom.csv]
2026-11-10 Brophy Borealis: 22.5 deg LED lean, split deck rails, parallel build, Onshape swap
    - LED lean 22.5 deg, reached 15 mm after each corner arc (2 mm square lead-in: 0 made an
    invalid rear window loft that deleted the frame; body.build now stops on that)
    - deck rails in two pieces each side round the pivot; their M5s go outboard of the member's
    light tunnel through U-slots in the deck acrylic's edge (8 of 8 find frame)
    - fog tube rerouted under the light bar pocket
    - par.py runs sectioning, contact table, node merges, joint lookups, interference, sweep and
    STEP export on 90% of the cores: robot.py ~2 h 40 min -> 55 min, same results
    - BOM/Sheet frame counts (52 pieces, 54 tenons), rail and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
    [glacis_bom.csv, parts_from_cad.csv]
2026-11-10 Claim: front light bar hole + 20x20 rails
2026-11-10 Borealis pass 2: front light bar hole, in-well rails, welded chambers, 0-85 deg, GOGO in valves
    - Front light bar: a plain hole from the bumper to 4.5 in above it, open at the bottom, no liner;
    two 20x20 rails across it behind the shell (screwed from inside), the bar on the lower one
    - Deck rails moved inside the gun well over the cut-down towers; bearing blocks on the rails
    (pivot z 656), a tower plate wraps each tower; tower brackets and acrylic U-slots gone
    - Welded chambers (1.56 / 1.32 L), chamber transducers and reliefs on crosses after the in valves
    - Elevation 0-85 deg; GOGO GPG-M03 in valves with G1/4 x 1/4 NPT nipples; 1/2 in smoke line; M4
    - Parts list folded from the Sheet ($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
    [glacis_bom.csv, parts_from_cad.csv, sheet1_strip1.dxf, sheet1_strip2.dxf, sheet1_strip3.dxf, sheet2_strip1.dxf, sheet2_strip2.dxf, sheet2_strip3.dxf]
2026-11-10 Borealis pass 2: Onshape re-import noted; pot row and 44615K416 link back (from the Mac chat's Sheet fixes)
    [glacis_bom.csv]
2026-11-11 Pivot hubs (pulley bolted to the cradle plate), origin fastens back, Kenzo's parts-list swaps (Amazon/AliExpress only)
    [glacis_bom.csv, parts_from_cad.csv]
2026-11-11 Elevation: 112T ring pulley on standoffs, belt centred between plate and bearing block, pinion moved out
    [glacis_bom.csv]
2026-11-11 Gun restyle: chevron + turret-wheel plates, cannons 30% closer, V rear chamber holder, filled-out caps, printed end covers, slim left hub
    [glacis_bom.csv, parts_from_cad.csv]
2026-11-11 Log: Onshape old part studios deleted, every tab but the main assembly in folders
2026-11-11 Review pass: every plate hole backed, one gun core (left/right halves), electronics shelf, parts list
    - Plate holes: tie holes with nothing behind them removed; saddles, chamber caps and the
    gun core screw in from the sides through the plates into inserts; chevrons re-phased
    so every screw sits in a solid web (704 g per plate).
    - Gun core: valve side blocks + breech block + mantlet fused, split left/right, clamped
    across the split; hub flange 3 mm, ring standoff screws counterbored.
    - Electronics shelf matches rev D.2.1 (Waveshare P4 board, PCA9685, two ADS1115s,
    battery relays, 1200 W boost); stale CAD labels refreshed.
    - robot.py measures gun prints level (the tilted display pose m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
    [glacis_bom.csv, gun_plate_left.dxf, gun_plate_right.dxf, parts_from_cad.csv]
2026-11-11 Flat waterjet brackets: riveted, tied together, tubes drilled to match
    - New brackets.py: side plates (the Falcon plates grown along the inner rail into
    every post: sled posts, tower, tank posts), inboard plates, arm knees on every
    post/arm joint, drilled corner gussets, flat tower plates + spacer strips, a
    3-piece bellypan with seam straps. All 1/8 in, all flat, all under 12 x 12 in.
    - Rivet heads checked against every part; each rivet hole cut through the tube
    wall under it so the extrusion CNC program comes from the model.
    - docs/glacis/waterjet: one DXF per part, the 12 x 12 nest (11 sheets), README.
    - Old drive plates, bent tower plates/gussets and top arm gussets removed; tank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
    [arm_knee.dxf, arm_knee_short.dxf, bellypan_front.dxf, bellypan_middle.dxf, bellypan_rear.dxf, bellypan_seam_strap.dxf, corner_gusset_bottom.dxf, corner_gusset_top.dxf]
2026-11-11 brackets.py: LF line endings
2026-11-11 Gun cradle plates: cut on the CNC router (too big for the 12 x 12 waterjet)
    [glacis_bom.csv]
2026-11-11 Acrylic and aluminium in hand (off the list), CNC only for the cannon plates; page republished
    [glacis_bom.csv]
2026-11-11 Electronics on a one-piece CNC bellypan, breaker on the rear panel, part numbers for every part
    - misc.py: printed shelf removed; every board/module placed on the bellypan
    clear of all other parts (checked); printed board trays with heat-stake
    pegs; the 120 A main breaker (the on/off switch) on the rear panel beside
    the E-stop, 42 mm hole in the acrylic.
    - brackets.py: bellypan one CNC router piece with every footprint engraved
    (layer MARK); nest skips CNC parts.
    - partcodes.py (new): a code for every part from the list codes (P23-1,
    3DP-B014, ASh-D02, ATu-D05, AEx-R03, Acr-B04...); Onshape Part numbers set.
    - Parts list $1,538.00: main ball valve and 1-1/2 in nipple bought, audio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
    [arm_knee.dxf, arm_knee_short.dxf, bellypan.dxf, bellypan_middle.dxf, bellypan_rear.dxf, bellypan_seam_strap.dxf, corner_gusset_bottom.dxf, corner_gusset_top.dxf]
2026-11-12 Borealis: CNC tube holes + drilling table, lower underglow on tape, axles inside the rail, 3/16 in bumper gap
    - Every rivet, bearing, axle-access, bumper, underglow-rivnut and frame-mount hole cut in the box tubes;
    docs/glacis/tube_drilling.csv lists all 303 for the CNC program
    - New lower underglow bracket (strip centre under the bumper's bottom edge), 3M tape, M4 rivnuts;
    corner gussets get the matching holes
    - Axles end in the outer rail's bearing: no axle slots in the bumper
    - Bumper ring 3/16 in off the chassis on printed spacers, foam 1-13/16 in deep
    - Parts list: + 3M tape (L05), + M4 rivnuts (B20), M4 x 8 x2; $1,566.22; _sheet() items from row 5
    - JUDGMENTS B22, UPDATES entry
    Co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
    [arm_knee.dxf, arm_knee_short.dxf, bellypan.dxf, corner_gusset_bottom.dxf, corner_gusset_top.dxf, glacis_bom.csv, inboard_plate_front_tank.dxf, inboard_plate_rear.dxf]
2026-11-12 UPDATES: Onshape part names carry their parts-list code; CAD vs parts list check
2026-11-12 Borealis: CAD matches the list, Sheet notes, LED wiring, centred 3/4 in smoke line, visuals
    Modules, quick disconnects, pulley teeth and the high rear fog tube in the CAD;
    Micah's Sheet notes applied (parts dropped, swapped, owned); 22 AWG LED wire and
    servo pigtails; the gun's smoke line is 3/4 x 1 in, centred between the barrels
    with oblong holes and a collar channel per barrel hole; solid mantlet; printed
    ring standoffs; taped underglow brackets; new Visuals STEP. Checks clean.
    [add_on_rails.step, arm_knee.dxf, arm_knee_short.dxf, bellypan.dxf, corner_gusset_bottom.dxf, corner_gusset_top.dxf, glacis_bom.csv, gun_pivots.step]
2026-11-12 Borealis: Onshape re-import done, visuals with hide switches
2026-11-12 Smoke holes 3/8 in leaning 40 deg to the muzzle; cone baffles in the smoke collar
2026-11-12 Breech puck (2.5D from 1 in 6061, JB Welded in the barrel): barrel slides into the core and screws onto the valve
    [glacis_bom.csv]
2026-11-12 Smoke collar: smooth swept channels, 45 deg holes, baffles removed; 5.5 mm LED bands open all round on mantlet, collar, muzzle ring
    [glacis_bom.csv]
2026-11-12 Rear manifold: two real ChillWaves crosses, no QD on the main valve line, cross 6-pack, 2-1/2 in fill nipple
    [glacis_bom.csv]
2026-11-13 Rear manifold: one ChillWaves cross; tank relief (P02-1) removed per Micah; transducer on a tank bung; street elbows dropped
    [glacis_bom.csv]
2026-11-13 Pneumatics: no QDs but the fill plug, 10 straight push-to-connects, flat rear cross (fill out the back, main valve inside), CheeMuii tube
    [glacis_bom.csv]
2026-11-13 LED groove helper uses the section's largest face (the smoke collar came out in 3 pieces when channels split its section)
2026-11-13 Log: no QDs, straight connectors, flat rear cross, Onshape re-import + concept branch
2026-11-13 Air & wiring page: flat rear cross, no tank relief, no QDs but the fill, 10 straight push-to-connects, new tube, Onshape concept branch
2026-11-13 Rear panel: no E-stop (the breaker's red trip is the kill switch), breaker/charge/fill/USB-C in one tight row
    [glacis_bom.csv, part_codes.csv]
2026-11-13 Air & wiring page: no rear E-stop, breaker is the kill switch
    [part_codes.csv]
2026-11-13 Tank transducer to the right tank's front bung (rear one hit the arm knee, found by review); stale notes cleaned
    [glacis_bom.csv, part_codes.csv]
2026-11-13 Frame in 40x40 T-slot: members, end taps, T-nut plates, corner brackets, captive hex axles
    Every 1x2 / 1x1 box tube member is now 40x40 20-series T-slot (lib.ext4040), joined by
    M5 end taps through 10 mm access holes, M5 T-nut plates and cast 40-series corner
    brackets; no rivets or CNC'd tube holes. FW grows to 627.5 mm (gun side fixed at
    GUN_RAIL_Y 129.35); flanged hex bearings pressed through two 1/8 plates each (side plate
    + inner bearing plate, two outer bearing plates); hex axle captive between the rail faces
    with a 1/4 in collar. Sled arms raised to 296.4; tank arms stay at 281.8 (front post to
    x 180, rear post -50, tank x 62) to clear the elevation motor. check_fasteners replaces
    dril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
2026-11-13 4040 frame: arms clear the wheels' swept circle, tanks between their bungs, docs strings
    Sled rails up to 301.4 (8.2 mm over the rear wheel's 127 mm circle at the -215 rail's
    near edge; 296.4 left 3.7). Tank arms stay at 281.8 (raising them hits the elevation
    motor): tank posts at x 0 and 165, tank at x 47.5, straps between the bungs. Bracket
    placer checks the wheels' swept circles. Rear sled post to -332 (the valve cross's line
    relief). Waterjet README and module docstring describe the T-nut plates.
    [body_panels_clips.step, gun_pivots_1_of_3.step, gun_pivots_2_of_3.step, gun_pivots_3_of_3.step, pneumatics.step, pneumatics_concept.step, power_electronics_smoke.step]
2026-11-13 4040 frame: tank lines clear the wider body, waterjet DXFs + cut list, log and judgments
    Full build with the body: 2 interference pairs over 30 mm3 (the old gun-internal ones),
    sweep 0-90 clean, fasteners clean, every print fits. The tank lines' rear drop moves 25 mm
    ahead of the cross (it grazed the rear frame nodes). Waterjet DXFs/nest regenerated for
    the T-nut plates; docs/glacis/cut_list_4040.csv replaces tube_drilling.csv. UPDATES entry
    and JUDGMENTS B30.
    [arm_knee_short.dxf, bearing_plate.dxf, bellypan.dxf, corner_gusset_bottom.dxf, corner_plate_bottom.dxf, corner_plate_top.dxf, cut_list_4040.csv, inboard_plate_front_tank.dxf]
2026-11-13 Log: 40x40 frame imported into the Onshape branch
